nesl/ragobots/robot/hw/body/docs/IR_Power/Cliff_Rx/notes.txt

This is basically unmeasurable. The 620 shows 3.75mV which is less than 1 micro-amp (guess by extrapolation).
noise floor occurs for all currents below 17.2uA (see xls chart "620 CHARACTERIZATION)
