nesl/ragobots/robot/hw/body/docs/IR_Power/Obstacle_Low_Power_TX/notes.txt

Agilent E3631A reads: 1.201V, 3mA CC
I_peak = 368.8mV -> 16.6mA
I_avg = 165.2mV -> 7.2mA
