nesl/ragobots/publications/2004_10_Ragobot_EEARR2004.pdf

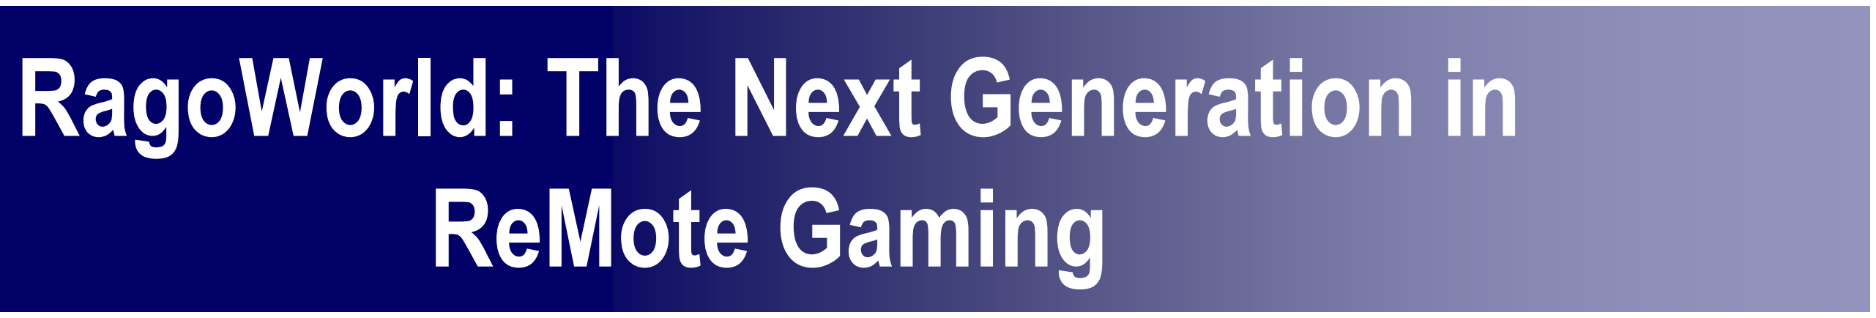
[picture p17: figure]
RagoWorld: The Next Generation in ReMote Gaming

Jonathan Friedman, David Lee, Advait Dixit, Parixit Aghera, Aman Kansal, Sophia Wong, William J. Kaiser, Greg J. Pottie, and Mani Srivastava http://nesl.ee.ucla.edu

### 2 EE ARR 2004

## Behind the Bot: A RagoStory

- Entertainment
- Provide new interactive gaming environment
- Visual interesting and new potential games
- Education
- Fun platform for students to learn about embedded robots
- Provide teaching aids for complex systems
- Research
- Provide reconfigurable mobile platform for embedded research
- New directions in adaptive actuation and coordinated operation
- Isolate test algorithms by shifting other functionality to central server

## RagoWorld: Robogaming Environment

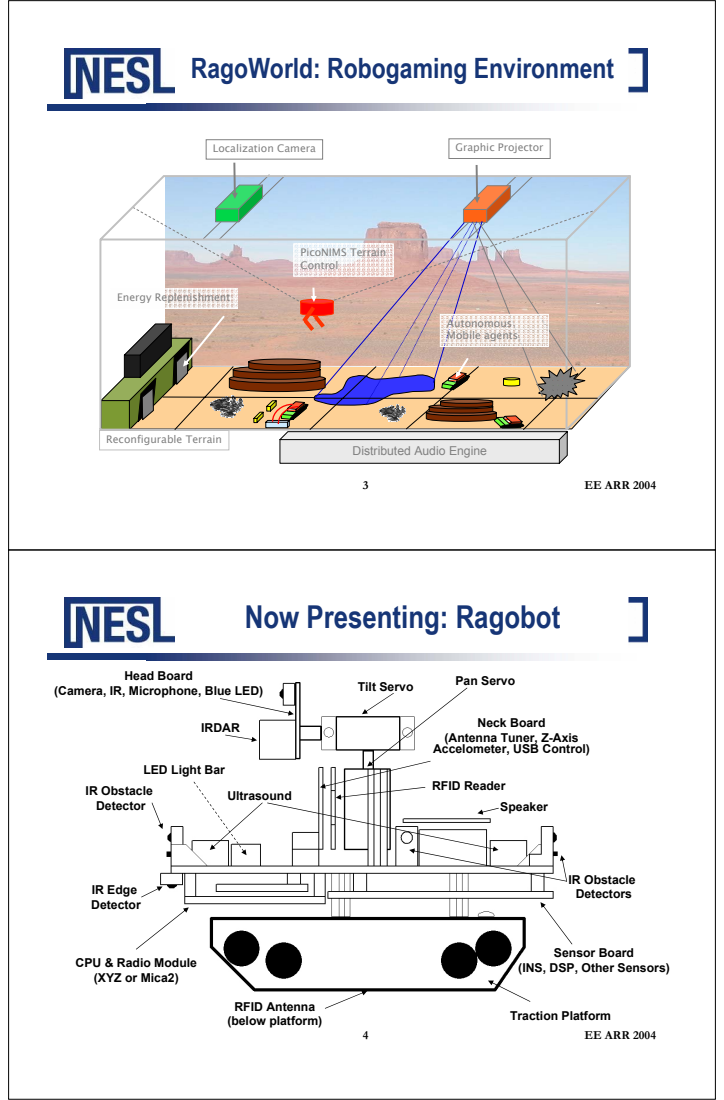
[picture p18: page 2]
3 EE ARR 2004; Graphic Projector; PicoNIMS Terrain Control; Energy Replenishment; Reconfigurable Terrain; Localization Camera; Autonomous Mobile agents; 4 EE ARR 2004; wIR Edge wDetector; IR Obstacle Detector; RFID Reader; Head Board; IRDAR; RFID Antenna (below platform); Speaker; Ultrasound; IR Obstacle Detectors; Traction Platform

Distributed Audio Engine

Now Presenting: Ragobot

Pan Servo Tilt Servo

(Camera, IR, Microphone, Blue LED)

Neck Board
(Antenna Tuner, Z-Axis
Accelometer, USB Control)

LED Light Bar

Sensor Board
(INS, DSP, Other Sensors)

wCPU & Radio Module
w(XYZ or Mica2)

## Ragobot Rev. 1, Say Cheese

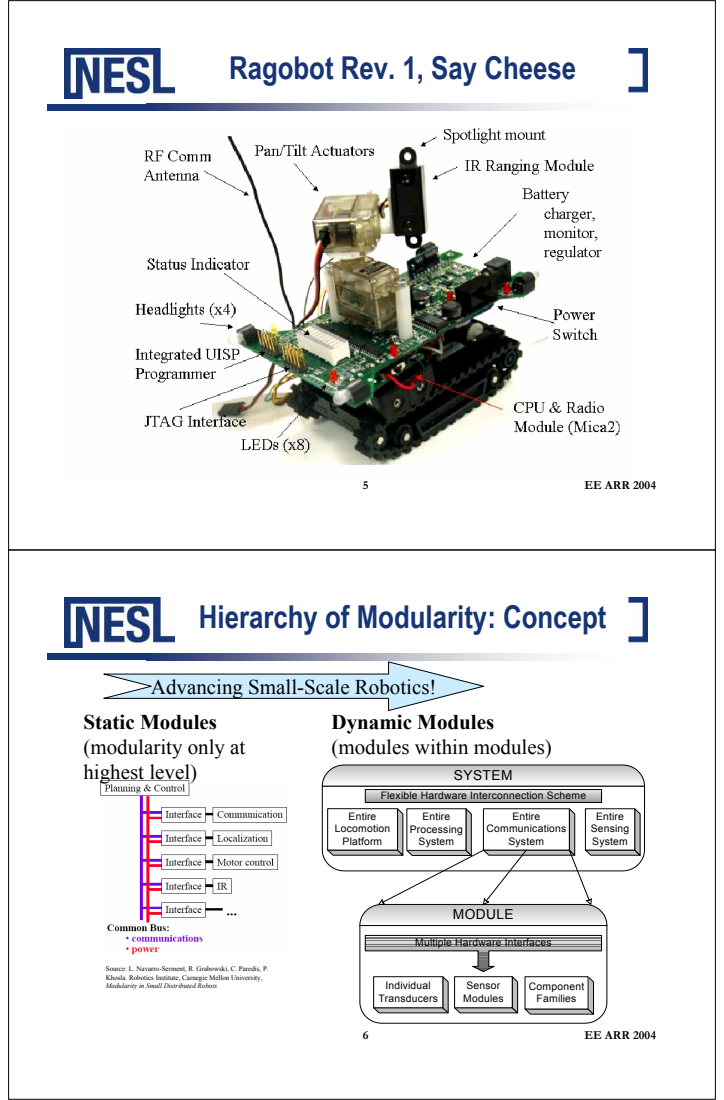
[picture p19: page 3]
5 EE ARR 2004; 6 EE ARR 2004; Entire Sensing System; Sensor Modules; Component Families; SYSTEM; MODULE; Individual Transducers; Entire Processing System; Entire Communications System

Hierarchy of Modularity: Concept

Advancing Small-Scale Robotics!
Static Modules
(modularity only at
highest level)

Dynamic Modules
(modules within modules)

Flexible Hardware Interconnection Scheme
Entire
Locomotion
Platform

Multiple Hardware Interfaces

Source: L. Navarro-Serment, R. Grabowski, C. Paredis, P.
Khosla. Robotics Institute, Carnegie Mellon University,
Modularity in Small Distributed Robots

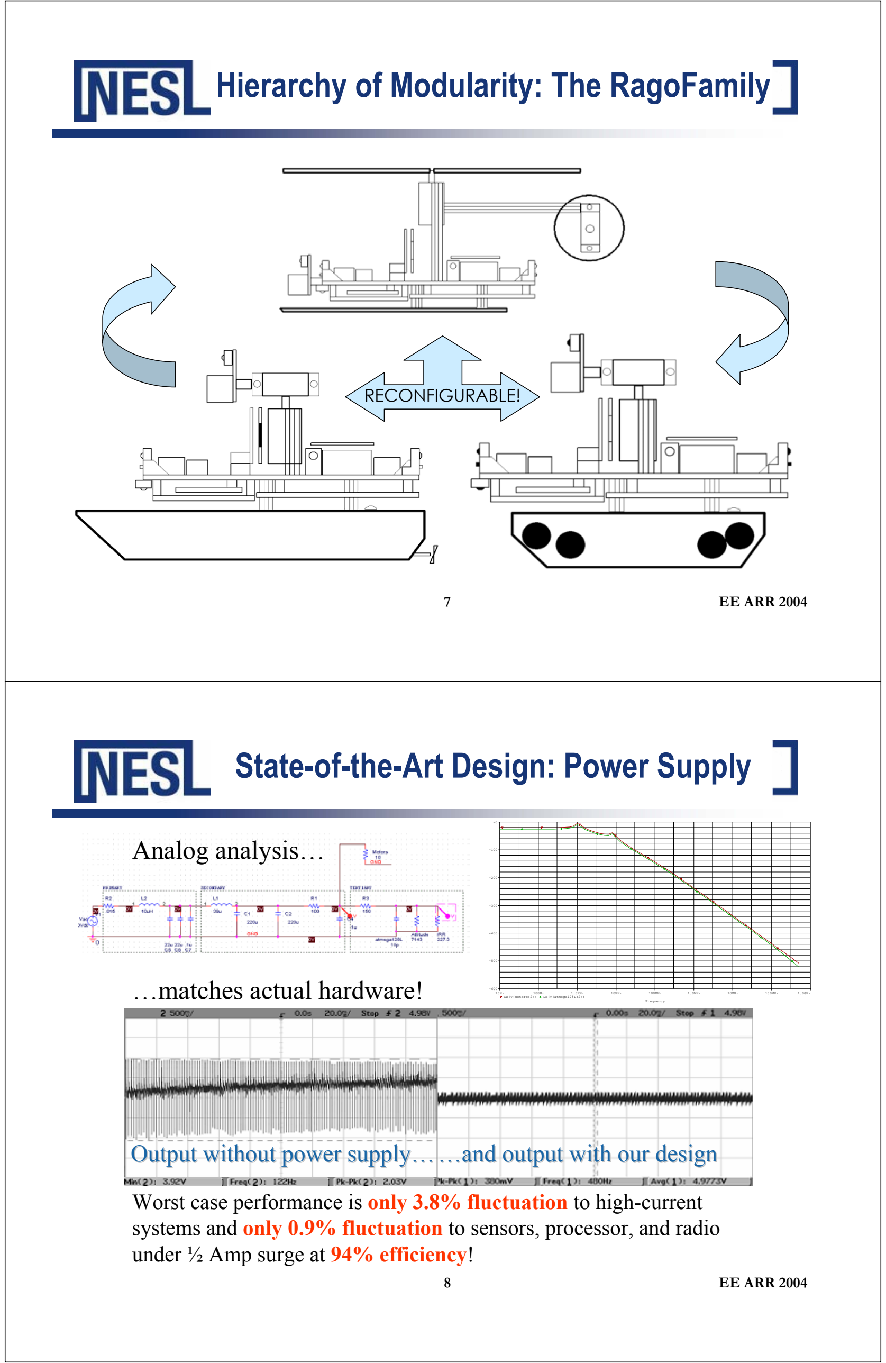
[picture p20: figure]
7 EE ARR 2004; Hierarchy of Modularity: The RagoFamily; RECONFIGURABLE!; 8 EE ARR 2004; State-of-the-Art Design: Power Supply; Frequency; 1.0KHz; 10KHz; 100KHz; 1.0MHz; 10MHz; 100MHz; 1.0GHz; DB(V(Motors:2)); DB(V(atmega128L:2)); under ½ Amp surge at 94% efficiency!; Analog analysis…; …matches actual hardware!

Worst case performance is only 3.8% fluctuation to high-current systems and only 0.9% fluctuation to sensors, processor, and radio

Output without power supply……and output with our design and output with our design

## Actuated Structures

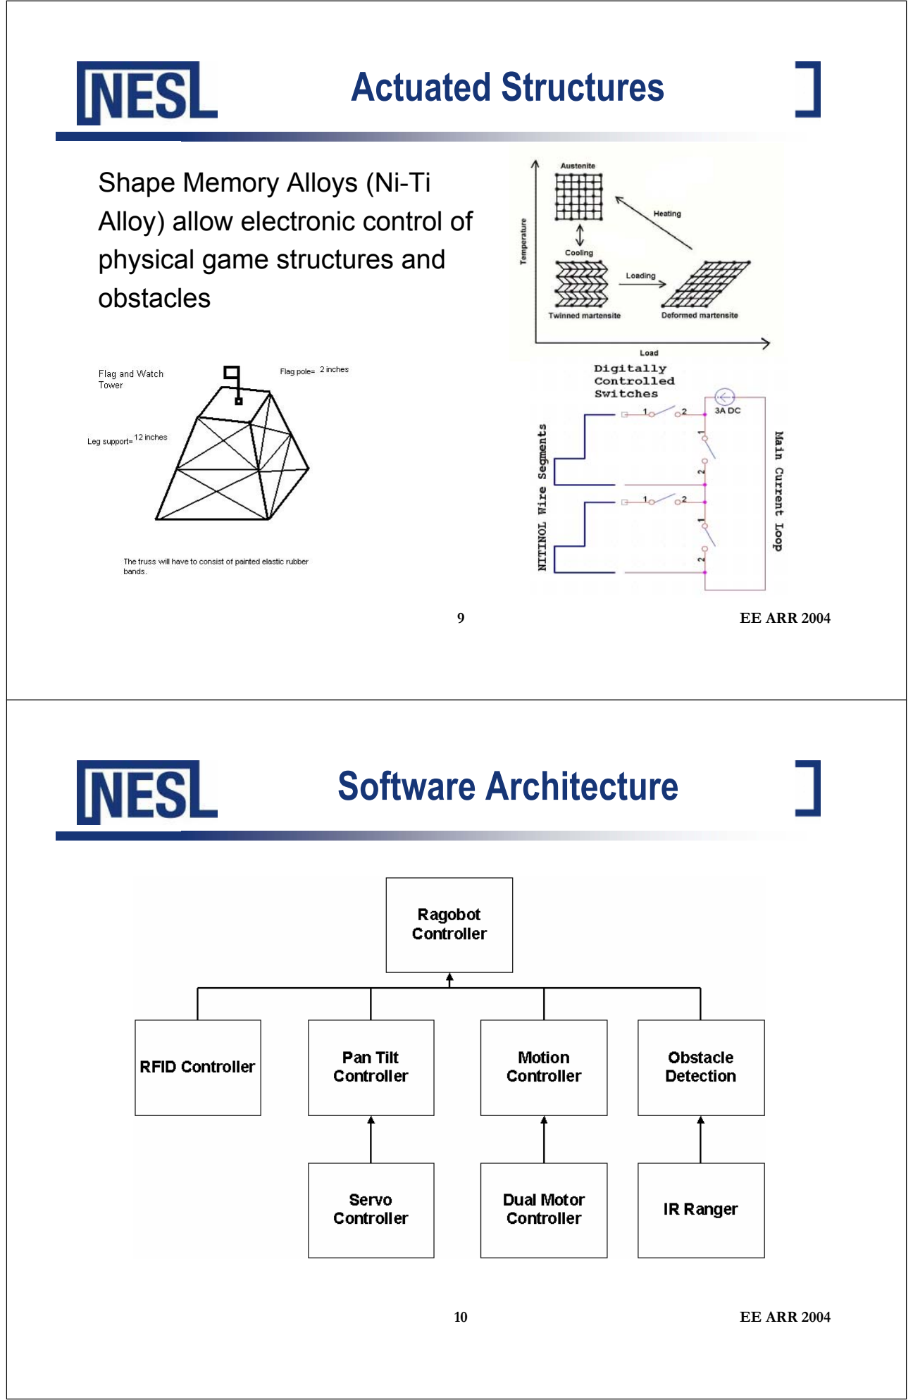
[picture p21: page 5]

### 9 EE ARR 2004

Shape Memory Alloys (Ni-Ti Alloy) allow electronic control of physical game structures and obstacles

### 10 EE ARR 2004

## Software Architecture

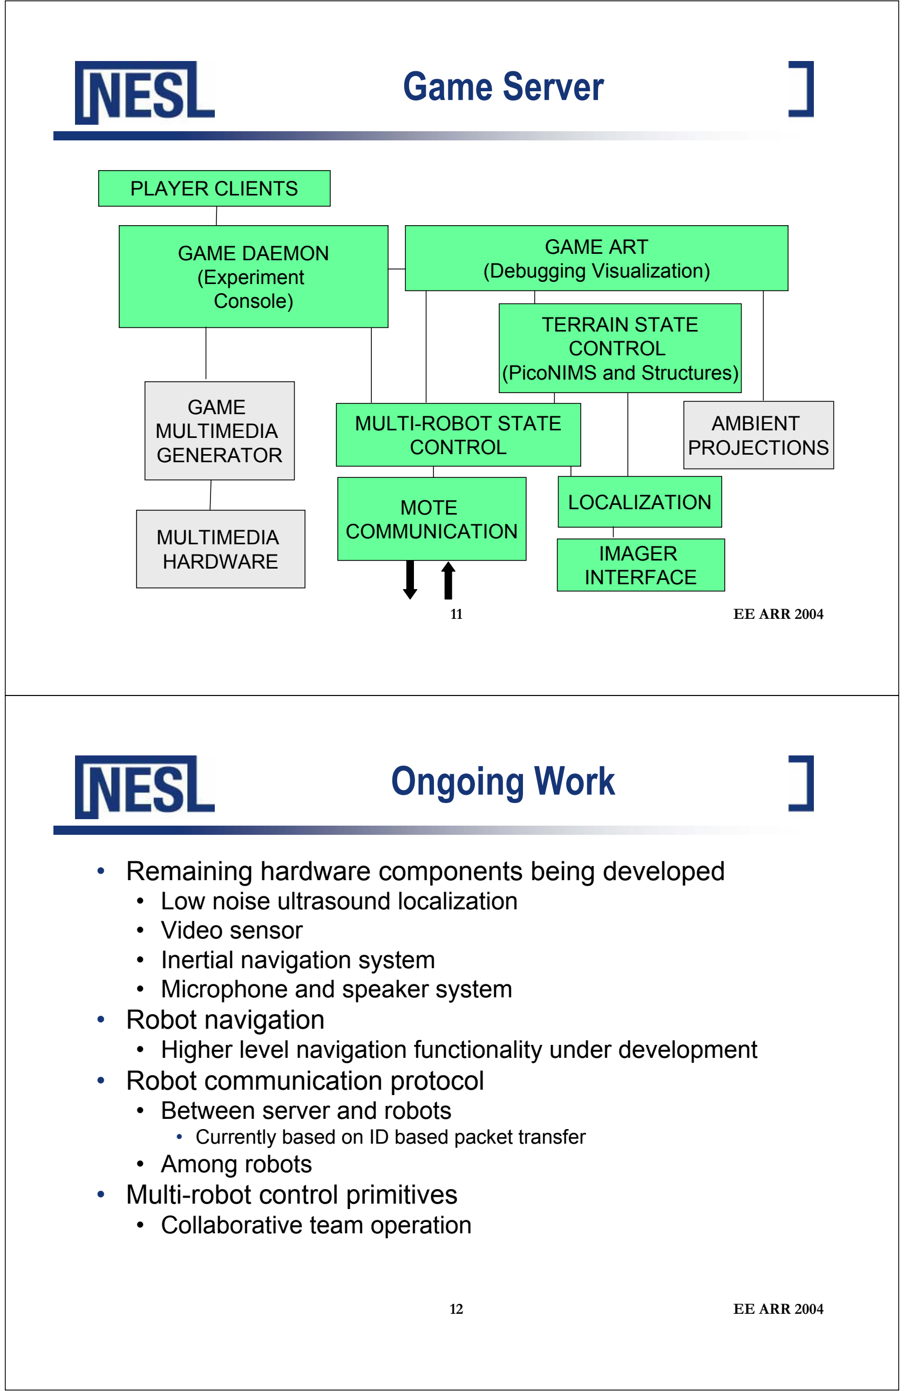
[picture p22: figure]
11 EE ARR 2004; Game Server; MOTE COMMUNICATION; MULTI-ROBOT STATE CONTROL; LOCALIZATION; GAME DAEMON (Experiment Console); PLAYER CLIENTS; TERRAIN STATE CONTROL (PicoNIMS and Structures); IMAGER INTERFACE; GAME MULTIMEDIA GENERATOR; MULTIMEDIA HARDWARE; GAME ART (Debugging Visualization); AMBIENT PROJECTIONS; 12 EE ARR 2004; Ongoing Work; • Low noise ultrasound localization • Video sensor • Inertial navigation system • Microphone and speaker system • Robot navigation; • Robot communication protocol • Between server and robots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

- Remaining hardware components being developed
- Higher level navigation functionality under development
- Currently based on ID based packet transfer
