nesl/ragobots/publications/2004_10_Ragobots_CENSARR2004.pdf

### Problem Description: Creation of a Test Platform for Mobile Sensor Network Research

### Proposed Solution: Ragobot and its Gaming Terrain

# Real Action Gaming Robots

Jonathan Friedman, David Lee, Parixit Aghera, Advait Dixit, Aman Kansal, Deborah Estrin, William J Kaiser, Mani B Srivastava, and Gaurav Sukhatme Networked and Embedded Systems Laboratory – http://nesl.ee.ucla.edu

### Introduction: Importance of Robogaming in Entertainment, Education, and Research

Entertainment and Education
- Provides new interactive gaming environment
– Creates opportunities for social interaction
- Promotes creativity
- Provides a flexible design platform
- Engages students to learn about robots and embedded mobile sensor networks
- Provides a teaching aid for complex systems

Mobile Sensor Network Research
- Provides reconfigurable mobile platform for embedded research
– Static sensor nodes may not be sufficient
– Mobility allows nodes to reconfigure into optimal sensing and communications topologies
- Allows adaptive actuation and coordinated operation

- Ragobot Hardware
– Hierarchy of modularity: robot divided into 5 PCBs:
- DSP sensor “Nerve” board,
- Processor “Brain” board,
- Motile sensor “Head” board,
- Vertical sensor mount “Neck” board, and
- Main interface “Body” board
– Large sensor array: 1) ultrasound, 2) RFID, 3) IR obstacle detection,
4) inertial navigation system , 5) microphone, and 6) camera –Custom power supply to reduce noise on mixed signal board
- Ragobot Software
–Game Server: 1) provides global services such as localization,
2) maintains state and provides robot control, 3) controls terrain configuration
- Platform independent GUI for player console ( Java )
- Components communicate using TCP/IP sockets (modularity)
–Robot Software (in TinyOS) 1) controls actuators and sensors,
2) communicates with game server and other Ragobots, 3) performs local tasks such as navigation, obstacle avoidance and treasure collection
- Different levels of abstractions to isolate hardware changes from upper layers
- Modular software design allows selection of different sets of functionalities
- Ragobot Terrain
–Electronically-controlled actuated structures using Ni-Ti shape memory alloys
–Modular terrain pieces with natural obstacles created from Insulfoam –Reconfigurable to create new terrain environments
–Global localization system using camera (CMVision) or ultrasound
- A fully capable, reconfigurable mobile platform to interface with sensor nodes
- Customizable sensor suite on mobile robots
- Simple programming interface for expert and non-expert users
- Real-time response to environmental stimuli
- Flexible, reconfigurable, interactive terrain

Game Server

Camera Localization

Multi-Robot State and
Control

Terrain Control
(PicoNIMS, Structures,
Projection and Audio)

Robot
Communication

Camera Interface

Player Console
Player Console

Robot Software

Navigation

Localization

Ragobot Controller

DualMotorController

ObstacleDetection

PanTiltController

ServoController

IRRanger

MotionController

«uses» | «uses»

«uses»

«uses» | «uses»

«uses»

«uses» | «uses»

«uses»

TreasureCollector

«uses»

GameServerComm

PlayerStrategy

RFIDController

HintCollector

Shaded Components have been developed/are being developed as part of this project.

ReliableComm

CPU & Radio Module
(XYZ or Mica2)

IR Edge
Detector

IR Obstacle
Detector

Sensor Board
(INS, DSP, Other Sensors)

RFID Reader

Head Board
(Camera, IR, Microphone, Blue LED)

IRDAR

RFID Antenna
(below platform)

Speaker

Ultrasound

LED Light Bar

IR Obstacle
Detectors

Neck Board
(Antenna Tuner, Z-Axis
Accelerometer, USB
Control)

Traction Platform

Pan Servo Tilt Servo
