nesl/ragobots/publications/org_chart.jpg

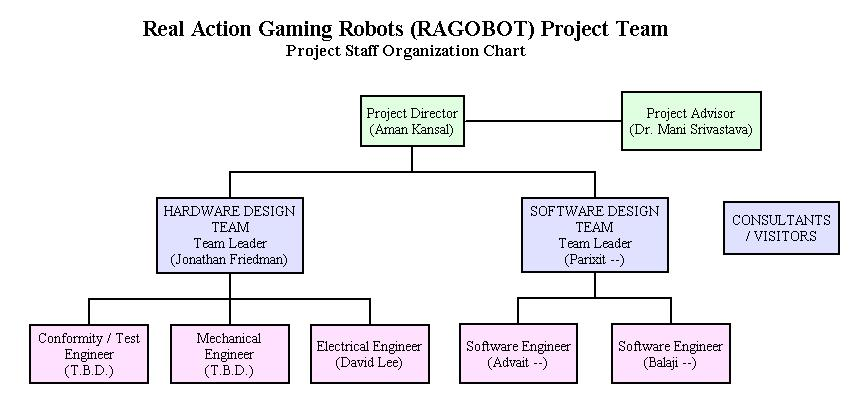
publications/org_chart.jpg
