nesl/ragobots/server/localization/capture.jpeg

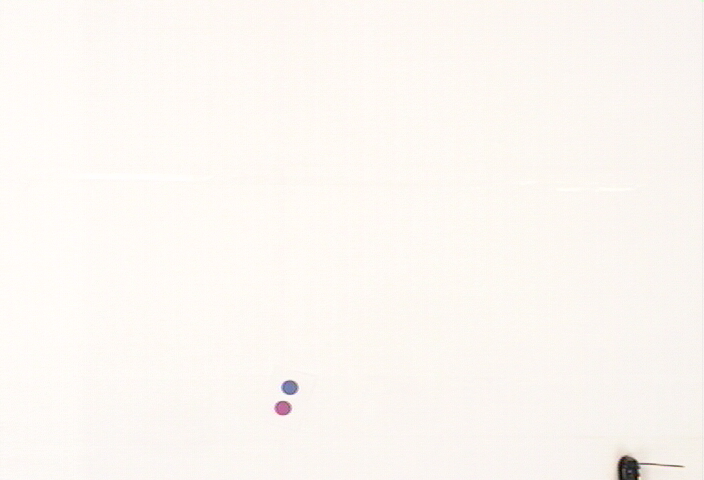
server/localization/capture.jpeg
