nesl/ragobots/server/localization/colors.bmp

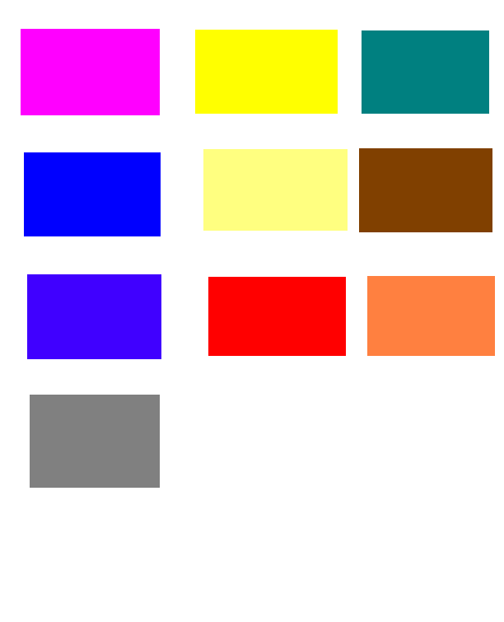
server/localization/colors.bmp
