nesl/ragobots/server/localization/colors_circles2.bmp

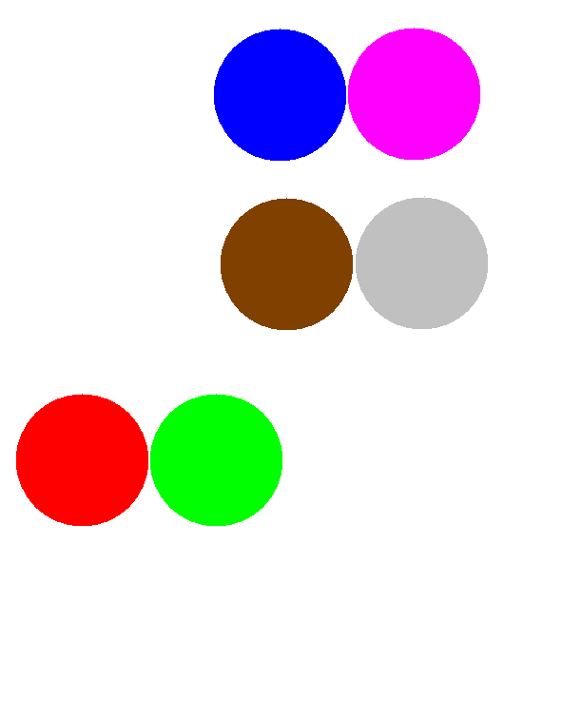
server/localization/colors_circles2.bmp
