nesl/ragobots/server/localization/colors_circles3.bmp

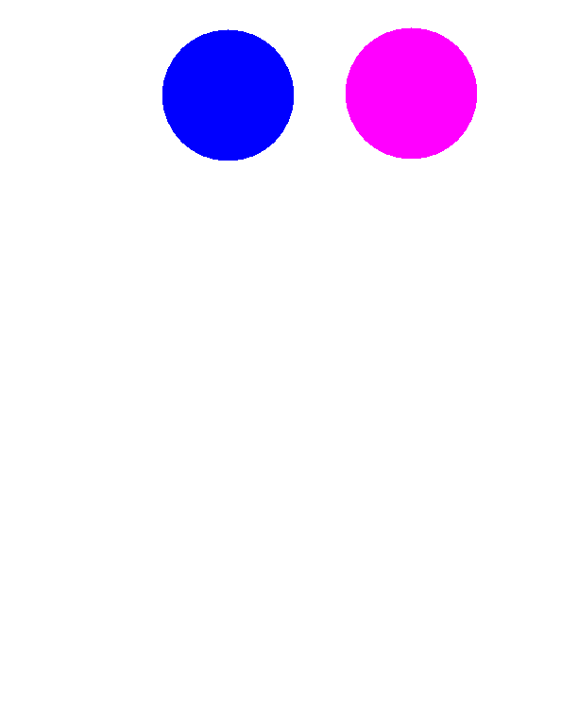
server/localization/colors_circles3.bmp
