nesl/ragobots/server/localization/colors_circles.bmp

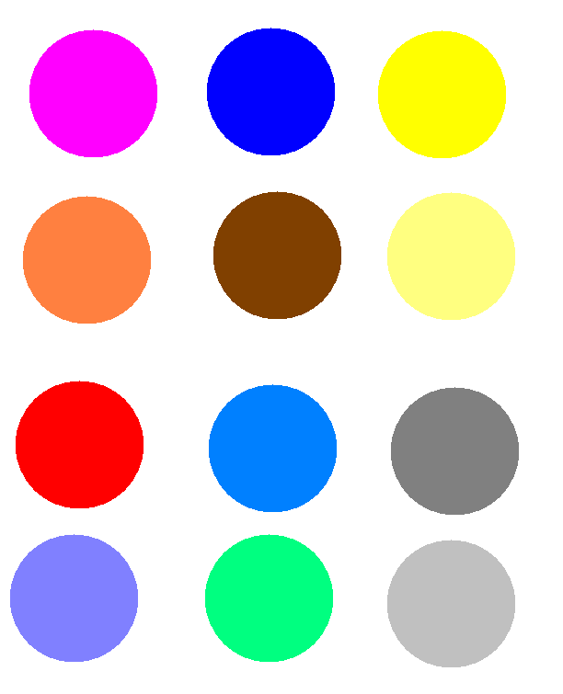
server/localization/colors_circles.bmp
