nesl/ragobots/server/localization/protractor2.gif

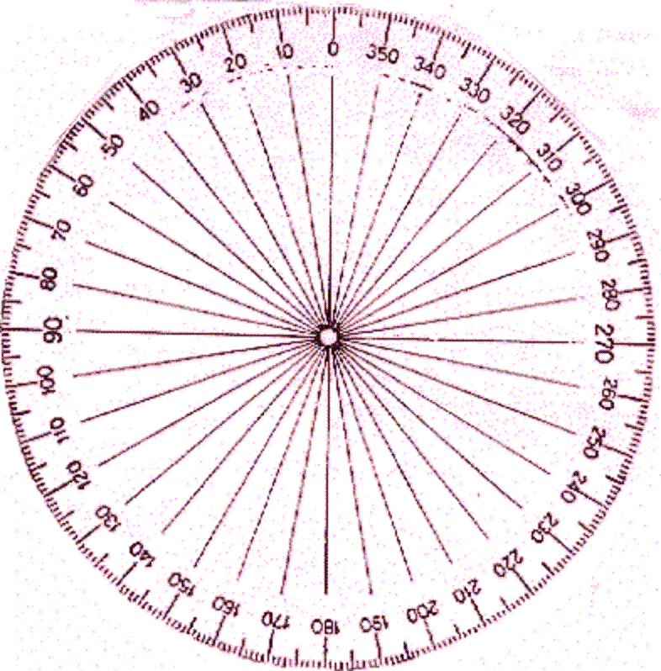
server/localization/protractor2.gif
