nesl/ragobots/server/localization/protractor.jpg

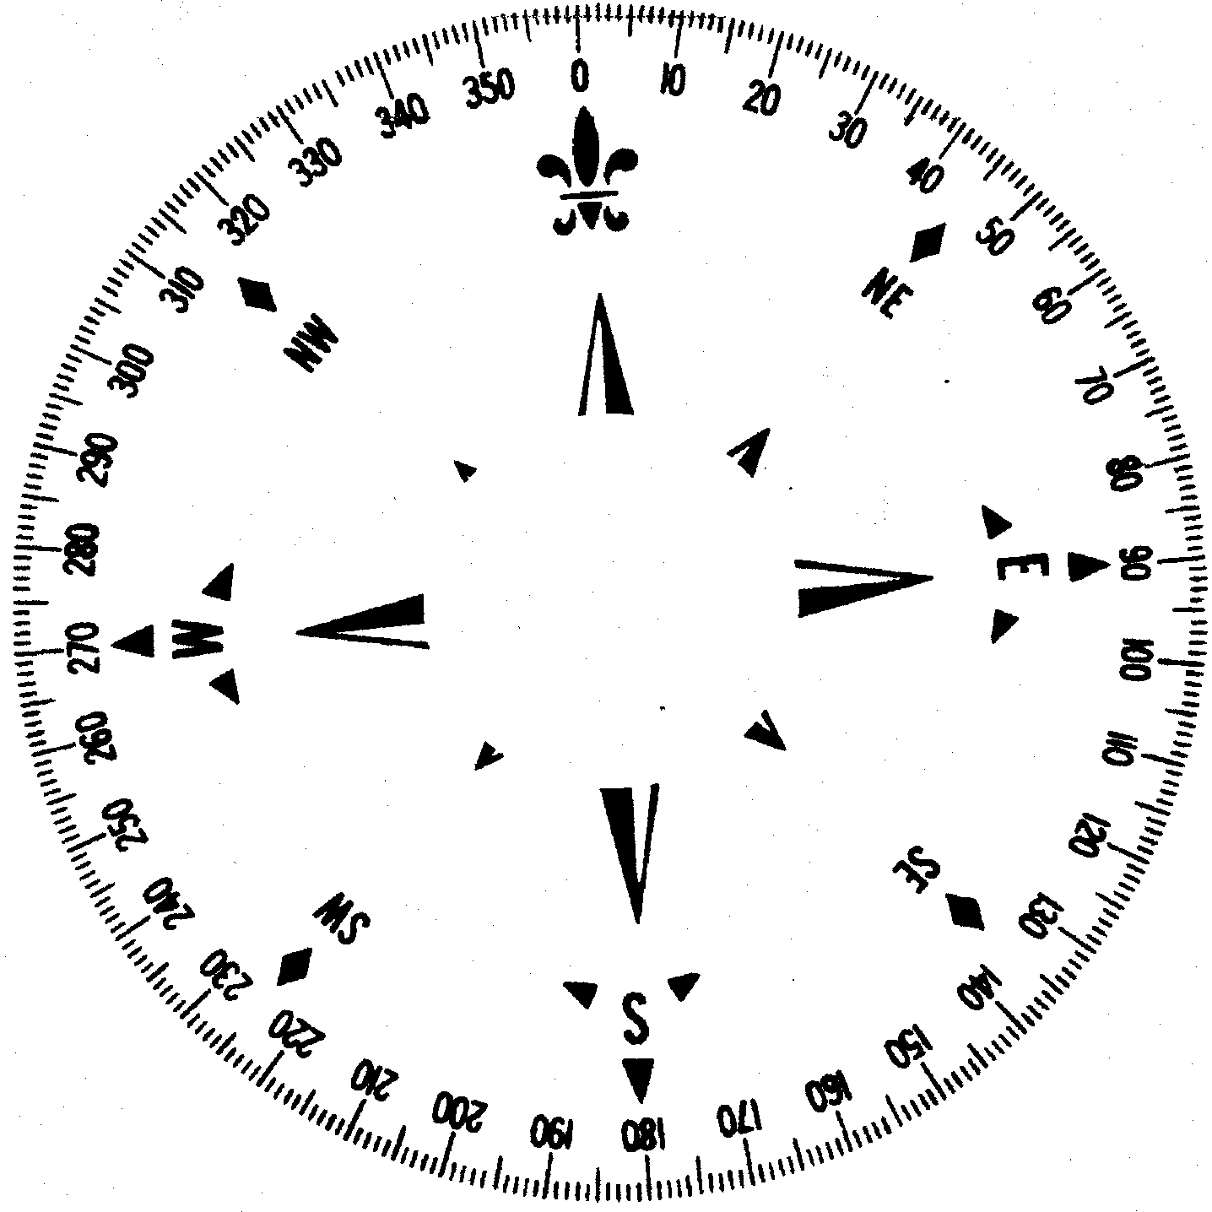
server/localization/protractor.jpg
