nesl/ragobots/robot/hw/body/docs/BOM_COST.xls

Item Number | Bin# | Distributor_Part_Number | Mfg_Part_Number | Description | Value | Quantity | Unit_Price
1 | C10.1 | ADXL203CE-ND | ADXL203CE | IC ACCELEROMETER DUAL-AXIS 8CLCC | ANALOG_DEVICES/ADXL203CE | 1 | 22.5 | $22.50 |  |  | $30.00 | <-Threshold for Expensive! Parts
2 | . | 77C7015 | MAX1138EEE | I2C 10 bit ADC with 12 channels | MAXIM/MAX1138 | 1 | 7.96 | $7.96 |  |  | $75.00 | <-Sum of Expensive! Parts
3 | . | AD623ARM-ND | AD623ARM | IC INSTR AMP R-R OUT 8-MSOP | ANALOG_DEVICES/AD623 | 4 | 3.49 | $13.96 |  |  | $207.37 | <-Total without Expensive! Parts
4 | G05.6 | MAX1908ETI | Max1908 | Low-Cost Multichemistry Battery Chargers | MAX1908 | 1 | 7.19 | $7.19
5 | . | 490-1582-1-ND | GRM188F51C105ZA01D | CAP CER 1.0UF 16V Y5V 0603 | 1.0uF | 4 | 0.075 | $0.30
6 | . | 445-1436-1-ND | C3225X5R1C226M | CAP CER 22UF 16V X5R 20% 1210 | 22uF | 5 | 1.386 | $6.93 |  |  |  |  | $194.39 | Cost without Sensors
7 | . | 311-1047-1-ND | 04022F104Z7B20D | CAP .10UF 16V CERAMIC Y5V 0402 | 0.1uF | 39 | 0.088 | $3.43
8 | G02.2 | 308-1269-1-ND | CDRH104R-100NC | INDUCTOR POWER 10UH 4.40A SMD | 10uH | 1 | 2.45 | $2.45
9 | . | P33.2LCT-ND | ERJ-2RKF33R2X | RES 33.2 OHM 1/16W 1% 0402 SMD | 33.2 | 1 | 0.098 | $0.10
10 | . | P133KLCT-ND | ERJ-2RKF1333X | RES 133K OHM 1/16W 1% 0402 SMD | 133K | 3 | 0.098 | $0.29
11 | . | P9.31KLCT-ND | ERJ-2RKF9311X | RES 9.31K OHM 1/16W 1% 0402 SMD | 9.31k | 1 | 0.098 | $0.10
12 | . | RHM1.00KLCT-ND | MCR01MZPF1001 | RES 1.00K OHM 1/16W 1% 0402 SMD | 1k | 4 | 0.082 | $0.33
13 | A10.4 | P33.2KLCT-ND | ERJ-2RKF3322X | RES 33.2K OHM 1/16W 1% 0402 SMD | 33k | 5 | 0.098 | $0.49
14 |  |  |  |  | 0 |  |  | $0.00
15 | . | P39NBCT-ND | ERJ-L12KF39MU | RESISTOR .039 OHM 1/2W 1% 1812 | 0.039 | 4 | 0.696 | $2.78
16 | G04.2 | P15MCT-ND | ERJ-M1WSF15MU | RESISTOR .015 OHM 1W 1% 2512 | 0.015 | 3 | 0.816 | $2.45
17 | C15.4 | DS2438Z-ND | DS2438Z | IC MONITOR SMART BATTERY 8-SOIC | DS2438 | 1 | 3.87 | $3.87
18 | . | RHM5.10KLCT-ND | MCR01MZPF5101 | RES 5.10K OHM 1/16W 1% 0402 SMD | 5.1K | 2 | 0.082 | $0.16
19 | L08.0 | H2163-ND | DF9-51S-1V(54) | CONN RECEPT 51POS 1MM SMD GOLD | Mica2 Sensor HDR (to Mote) | 1 | 3.12 | $3.12
20 | . | P5506-ND | ECA-0JHG221 | CAP 220UF 6.3V ELECT NHG RADIAL | 220uF | 1 | 0.19 | $0.19
21 | . | 490-1586-1-ND | GRM188F51A225ZE01D | CAP CER 2.2UF 10V Y5V 0603 | 2.2uF | 1 | 0.168 | $0.17
22 | . | 493-2182-1-ND | UWT1C681MNL1GS | CAP 680UF 16V ELECT WT SMD | 680u | 1 | 0.548 | $0.55
23 | B01.1 | 311-1014-1-ND | 0402CG100J9B200 | CAP CERAMIC 10PF 50V NP0 0402 | 10pF | 1 | 0.077 | $0.08
24 | B06.3 | PCC1909CT-ND | ECJ-1VB0J334K | CAP .33UF 6.3V CERAMIC X5R 0603 | 0.33uF | 1 | 0.134 | $0.13
25 | . | 478-1248-1-ND | 0603YD474KAT2A | CAP CERM .47UF 10% 16V X5R 0603 | 0.47uF | 3 | 0.495 | $1.48
26 | E02.5 | 160-1167-1-ND | LTST-C150CKT | LED RED CLEAR 1206 SMD | LED | 6 | 0.11 | $0.66
27 | . | L20488-ND | 5305H1/5 | LED RED/GRN T1-3/4 BI-CLR PCB | 5305H1/5 Tricolor LED | 4 | 1.94 | $7.76
28 | . | B220ADICT-ND | B220A-13 | DIODE SCHOTTKY 20V 2A SMA | 2A,20V | 12 | 0.76 | $9.12
29 | . | LN54PA-ND | LN54 | IR LED 950NM 17 DEG SIDE VIEW | 950nm | 6 | 1 | $6.00
30 | . | 02J4593 | MAX6816 | Single CMOS Switch Debouncer | MAXIM/MAX6816 | 1 | 2.18 | $2.18
31 | . | 38C7158 | FDS4435A | Discrete Semi's, MOSFET, P Channel, -30 V Voltage Rating, SO-8 Package | FAIRCHILD/FDS4435A | 1 | 1.15 | $1.15
32 | . | 497-1396-5-ND | L298P | IC DUAL FULL DRIVER 20POWERRSOIC | ST/L298/P20 | 1 | 4.86 | $4.86
33 | . | IRF7509CT-ND | IRF7509TR | HEX/MOS N/PCH DL 30V/-30V MICRO8 | IR/IRF7509 | 1 | 1.89 | $1.89
34 | . | WM4802-ND | 70543-0003 | CONN HEADER 4POS .100 VERT GOLD | 4 | 1 | 0.96 | $0.96
35 | . | PI74STX1G04CXCT-ND | PI74STX1G04CX | IC SINGLE INVERTER SC70-5 | PERICOM/PI74STX1G04CX/SC70 | 2 | 0.38 | $0.76
36 | E14.4 | 425-1131-ND | GP1UD28YK | RECEIVER REMOTE CTRL SIDE 40KHZ | SHARP/GP1UD26XK | 6 | 1.33 | $7.98
37 | . | HFJ50CT-ND | FH12-50S-0.5SH | CONN FPC/FFC 50POS .5MM HORZ SMD | 50 PIN | 2 | 3.54 | $7.08
38 | . | H1755-ND | DF15A(6.2)-50DP-0.65V(50) | CONN HEADER 50POS 6.2MM DUAL SMD | HEADER 50 | 1 | 2.73 | $2.73
39 | . | A26565-ND | 87227-1 | CONN HEADER VERT .100 2POS 15AU | CONN SOCKET 2 | 4 | 0.87 | $3.48
40 | D12.3 | CP-016-ND | PJ-016 | CONN PWR JACK 4.4MM X 1.65MM PCB | CONN_JACK_PWR | 1 | 0.54 | $0.54
41 | G07.3 | 445-1553-1-ND | MMZ1608Y152B | FERRITE CHIP 1500 OHM 300MA 0603 | 1.5K | 7 | 0.092 | $0.64
42 | . | 308-1050-1-ND | CDRH125-220MC | POWER INDUCTOR 22UH 2.8A SMD | 22uH | 1 | 2.13 | $2.13
43 | L04.0 | 512-MV5E164 | MV5E164 | LED BARGRAPH 10-SEG GRN/YLW/RED | LUMEX SSA-LXB10SRW-GF/LP | 1 | 0.86 | $0.86
44 | . | P11123-ND | WM-R30B | SPEAKER FLAT 30MM X 30MM | Note: Place both footprints! (one is mech, one is electrical) | 1 | 6.32 | $6.32
45 | . | 02J4502 | MAX3370EXK-T | 1uA, 2Mbps, Low-Voltage Level Translator in SC70 Package | MAXIM/MAX3370 | 4 | 2.04 | $8.16
46 | . | 342-1006-ND | HMC1023 | SENSOR LINEAR MAGN 3 AXIS 16-BGA | HONEYWELL/HMC1023 | 1 | 75 | $75.00 | EXPENSIVE! | $75.00
47 | G01.1 | BTR-7006 | BTR-7006 | 90 Degree Universal Servo Mount | SERVOCITY/90_DEG_SERVO_MOUNTS | 4 | 1.95 | $7.80
48 | . | A23858-ND | 644861-6 | CONN HEADER VERT .100 6POS TIN | 6x1 | 1 | 1.02 | $1.02
49 | . | A26267-ND | 103308-1 | CONN HEADER LOPRO STR 10POS 15AU | 5x2; .100" | 2 | 0.44 | $0.88
50 | . | 82C2573 | FDS6898A | SO-8 DUAL N-CH 20V PowerTrench MOSFETs | Dual N-CH | 5 | 1.32 | $6.60
51 | . | P150LCT-ND | ERJ-2RKF1500X | RES 150 OHM 1/16W 1% 0402 SMD | 150 | 6 | 0.098 | $0.59
52 | . | P47.5LCT-ND | ERJ-2RKF47R5X | RES 47.5 OHM 1/16W 1% 0402 SMD | 47.5 | 7 | 0.098 | $0.69
53 | . | RHM4.70LCT-ND | MCR01MZPFL4R70 | RES 4.70 OHM 1/16W 1% 0402 SMD | 4.7 | 2 | 0.082 | $0.16
54 | . | P17.4LCT-ND | ERJ-2RKF17R4X | RES 17.4 OHM 1/16W 1% 0402 SMD | 17.4 | 1 | 0.098 | $0.10
55 | . | P191LCT-ND | ERJ-2RKF1910X | RES 191 OHM 1/16W 1% 0402 SMD | 191 | 1 | 0.098 | $0.10
56 | G08.5. | Y1470CT-ND | EXB-2HV470JV | RES ARRAY 47 OHM 5% 8 RES SMD | 47 | 1 | 0.18 | $0.18
57 | . | P8002SCT-ND | EVQ-PHP03T | LIGHT TOUCH SWITCH W/ACT SLD SMD | SPST-M-NO | 1 | 0.86 | $0.86
58 | . | EG2486-ND | EG2211A | SWITCH SLIDE DPDT RT ANG PC MNT | slide switch | 1 | 0.82 | $0.82
59 | . | H2249-ND | FX2-40S-1.27SV | CONN RECEPT 40POS 1.27MM STR SMD | HIROSE/FX2-40S-1.27SV | 1 | 4.84 | $4.84
60 | . | NC7S32M5CT-ND | NC7S32M5 | IC GATE OR 2-INPUT SINGLE SOT-23 | FAIRCHILD/NC7S32M5X/SOT23_5 | 2 | 1.02 | $2.04
61 | . | MC74HC595ADTROSCT-ND | MC74HC595ADTR2 | IC REG SHFT 8BIT LCH 3ST 16TSSOP | ON/MC74HC595A/TSSOP16/B | 6 | 0.49 | $2.94
62 | . | TC74VHC165FN-ND | TC74VHC165FN | IC REG SHIFT PISO 8BIT 16-SOL | TOSHIBA/TC74VHC165 | 1 | 0.58 | $0.58
63 | G01.5 | ATMEGA48V-10MI-ND | ATMEGA48V-10MI | IC MCU AVR 4K 5V 12MHZ 32-MLF | ATMEL/ATMEGA48/88/168/MLF32 | 1 | 2.69 | $2.69
64 | . | MAX395CAG | MAX395CAG | Serially Controlled, Low-Voltage, 8-Channel SPST Switch, WSOIC24 (.300 inch) | MAX395CAG | 1 | 5.62 | $5.62
65 | . | WM1752-ND | 53048-1210 | CONN HEADER 12POS 1.25MM R/A TIN | PLANTRACO/Desktop_Rover | 1 | 1.62 | $1.62
66 |  |  |  |  | HEADER 8 |  |  | $0.00
67 |  |  |  |  | HEADER 8 |  |  | $0.00
68 | . | 490-1814-1-ND | GRM31CR61C106KC31L | CAP CER 10UF 16V 10% X5R 1206 | 10uF | 1 | 0.792 | $0.79
69 | . | PCD1667CT-ND | ELL-4LM100M | COIL PWR CHOKE 10UH 690MA SMD | 10uH | 1 | 1.4 | $1.40
70 | . | MAX1626ESA-ND | MAX1626ESA | IC DC/DCCONV STP-UP 3.3/5V 8SOIC | MAXIM/MAX1626 | 1 | 4.61 | $4.61
71 | . | 296-14212-5-ND | TPS62056DGS | IC STEP-DOWN CONV HI-EFF 10-MSOP | TI/TPS620XX | 1 | 4.16 | $4.16
 |  |  |  |  |  |  |  | $0.00
 |  |  |  |  |  |  |  | $0.00
 |  |  |  |  |  | 202 | Parts | $282.37 | Total BOM Cost
 |  |  |  |  |  |  |  |  | (no servos)
 |  | Update |  | Description/Results |  | BOM |  | Costs Saved
2004-12-05 |  | 11:37p |  | Removed Gyroscope |  | 84->80 |  | $49.00
2004-12-06 |  | 1:15a |  | BOM cleanup |  | 73 |  | $9.10
