nesl/ragobots/robot/hw/body/design/REV.B2/Ragobot BOM.xls

Item Number | Part Reference | Distributor_Part_Number | Quantity | Mfr_Part_Number | PCB Footprint | Description
1 | AC1 | MAX942CSA-ND | 1 | MAX942CSA | SOG.050/8/WG.244/L.200 | IC COMPARATOR DUAL 3V/5V 8-SOIC
2 | ACCEL1 | ADXL203CE-ND | 1 | ADXL203CE | ANALOG_DEVICES/ADXL203CE | IC ACCELEROMETER DUAL-AXIS 8CLCC
3 | ADC1 | 77C7015 | 1 | MAX1138EEE | MAXIM/QSOP/16 | I2C 10 bit ADC with 12 channels
4 | AMP2 AMP3 AMP4 | AD623ARM-ND | 3 | AD623ARM | ANALOG_DEVICES/AD623/MSOP | IC INSTR AMP R-R OUT 8-MSOP
5 | BC1 | MAX1908ETI | 1 | Max1908 | MAXIM/QFN/28/5X5X0.8 | Low-Cost Multichemistry Battery Chargers
6 | BC_C1 BC_C2 BC_C3 BC_C7 C22 C42 | 490-1582-1-ND | 6 | GRM188F51C105ZA01D | SM/C_0603 | CAP CER 1.0UF 16V Y5V 0603
7 | BC_C4 CB4 CB5 VR_CIN1 VR_CO1 | 445-1436-1-ND | 5 | C3225X5R1C226M | SM/C_1210 | CAP CER 22UF 16V X5R 20% 1210
8 | BC_C8 BC_C9 CD1 CD2 | PCC103BQCT-ND | 4 | ECJ-0EB1C103K | SM/C_0402 | CAP 10000PF 16V CERAMIC 0402 SMD
9 | BC_L1 | 308-1269-1-ND | 1 | CDRH104R-100NC | SUMIDA_CDRH104R | INDUCTOR POWER 10UH 4.40A SMD
10 | BC_R1 | P33.2LCT-ND | 1 | ERJ-2RKF33R2X | SM/R_0402 | RES 33.2 OHM 1/16W 1% 0402 SMD
11 | BC_R2 BC_R6 BM_RFILT1 | P133KLCT-ND | 3 | ERJ-2RKF1333X | SM/R_0402 | RES 133K OHM 1/16W 1% 0402 SMD
12 | BC_R3 BC_R7 | P9.31KLCT-ND | 2 | ERJ-2RKF9311X | SM/R_0402 | RES 9.31K OHM 1/16W 1% 0402 SMD
13 | BC_R4 R13 R21 R22 | P33.2KLCT-ND | 4 | ERJ-2RKF3322X | SM/C_0402 | RES 33.2K OHM 1/16W 1% 0402 SMD
14 | BC_R5 RGAIN2 RGAIN3 RGAIN4 | RHM1.00KLCT-ND | 4 | MCR01MZPF1001 | SM/C_0402 | RES 1.00K OHM 1/16W 1% 0402 SMD
15 | BC_R8 BM_R1 R43 R44 | RHM5.10KLCT-ND | 4 | MCR01MZPF5101 | SM/R_0402 | RES 5.10K OHM 1/16W 1% 0402 SMD
16 | BC_RS2 | P15MCT-ND | 1 | ERJ-M1WSF15MU | SM/R_2512 | RESISTOR .015 OHM 1W 1% 2512
17 | BM1 | DS2438Z-ND | 1 | DS2438Z | SOG.050/8/WG.244/L.200 | IC MONITOR SMART BATTERY 8-SOIC
18 | BM_RSENS1 VR_RSEN1 VR_RSEN2 | P39NBCT-ND | 3 | ERJ-L12KF39MU | SM/C_1812 | RESISTOR .039 OHM 1/2W 1% 1812
19 | BRAIN1 | H2163-ND | 1 | DF9-51S-1V(54) | XBOW/MICAX | CONN RECEPT 51POS 1MM SMD GOLD
20 | C1 C2 C3 C4 C5 C6 C7 C8 C9 C11 C15 C16 C17 C18 C23 C24 C25 C27 C28 C29 C32 C33 C34 C35 C36 C43 C44 CB1 CB6 CB7 CB8 CB9 CB10 CB11 VR_C1 VR_C2 | 311-1047-1-ND | 36 | 04022F104Z7B20D | SM/C_0402 | CAP .10UF 16V CERAMIC Y5V 0402
21 | C13 | 493-2182-1-ND | 1 | UWT1C681MNL1GS | NICHICON/NL10/2 | CAP 680UF 16V ELECT WT SMD
22 | C21 | P5506-ND | 1 | ECA-0JHG221 | TM/6.3MM_RADIAL_CAP/2 | CAP 220UF 6.3V ELECT NHG RADIAL
23 | C26 | PCC1909CT-ND | 1 | ECJ-1VB0J334K | SM/C_0603 | CAP .33UF 6.3V CERAMIC X5R 0603
24 | C30 C31 VR_CS1 | 478-1248-1-ND | 3 | 0603YD474KAT2A | SM/C_0603 | CAP CERM .47UF 10% 16V X5R 0603
25 | D1 D2 D3 D4 D5 D6 | 160-1167-1-ND | 6 | LTST-C150CKT | SM/D_1206_21 | LED RED CLEAR 1206 SMD
26 | D7 D8 D9 D10 | L20488-ND | 4 | 5305H1/5 | 5305H1/5 | LED RED/GRN T1-3/4 BI-CLR PCB
27 | D11 D18 D19 D20 D21 D22 D23 D24 D25 D26 D27 D28 D29 D30 D42 D43 | CRS06CT-ND | 16 | CRS06(TE85L) | SM/DO213AC_21/A | RECT SCHOTTKY 20V 1A 3-2A1A
28 | D12 D13 D14 D15 D16 D17 | LN54PA-ND | 6 | LN54 | PANASONIC/LN54 | IR LED 950NM 17 DEG SIDE VIEW
29 | DAC1 | 90C4136 | 1 | MAX550ACUA | MAXIM/UMAX/8 | +2.5V to +5.5V, Low-Power, Single, 8-Bit Voltage-Output DACs in µMAX Package
30 | DBNCE1 | 02J4593 | 1 | MAX6816 | SM/SOT143_1234 | Single CMOS Switch Debouncer
31 | FET1 | 512-FDS4935A | 1 | FDS4935A | SOG.050/8/WG.275/L.250 | Fairchild MOSFETs, SOIC-8 -30V, Dual P-channel
32 | H1 | 497-1396-5-ND | 1 | L298P | ST/POWERSO/20/B | IC DUAL FULL DRIVER 20POWERRSOIC
33 | HXFT1 | IRF7509CT-ND | 1 | IRF7509TR | IR/MICRO8 | HEX/MOS N/PCH DL 30V/-30V MICRO8
34 | IB1 |  | 1 |  | BLKCON.100/VH/TM1SQ/W.100/4
35 | INV1 INV2 | PI74STX1G04CXCT-ND | 2 | PI74STX1G04CX | TI/SC70/5 | IC SINGLE INVERTER SC70-5
36 | IR1 IR2 IR3 IR4 IR5 IR6 | 425-1131-ND | 6 | GP1UD28YK | SHARP/GP1UD28YK/5 | RECEIVER REMOTE CTRL SIDE 40KHZ
37 | J3 | HFJ33CT-ND | 1 | FH12-33S-0.5SH | HIROSE/FH12-33S-0.5SH/33/A | CONN FPC/FFC 33POS .5MM HORZ SMD
38 | J5 | CP-016-ND | 1 | PJ-016 | CUI/PJ-016 | CONN PWR JACK 4.4MM X 1.65MM PCB
39 | J15 | H2371CT-ND | 1 | DF17(3.0)-60DS-0.5V(51) | HIROSE/DF17/60/A | CONN RECEPT 60POS .5MM SMD W/FIT
40 | J16 | HFL33CT-ND | 1 | FH12-33S-0.5SV | HIROSE/FH12-33S-0.5SV/33/A | CONN FPC/FFC 33POS .5MM VERT SMD
41 | L1 L2 L3 L6 L7 L8 L9 L10 L11 | 445-1553-1-ND | 9 | MMZ1608Y152B | SM/C_0603 | FERRITE CHIP 1500 OHM 300MA 0603
42 | L5 | 308-1050-1-ND | 1 | CDRH125-220MC | SUMIDA/CDRH125 | POWER INDUCTOR 22UH 2.8A SMD
43 | LED BAR GRAPH 1 | 512-MV5E164 | 1 | MV5E164 | DIP.100/20/W.300/L1.000 | LED BARGRAPH 10-SEG GRN/YLW/RED
44 | LS1 | P11123-ND | 1 | WM-R30B | BLKCON.100/VH/TM2OE/W.200/2 | SPEAKER FLAT 30MM X 30MM
45 | LV1 LV2 LV3 LV4 | 02J4502 | 4 | MAX3370EXK-T | TI/SC70/5 | 1uA, 2Mbps, Low-Voltage Level Translator in SC70 Package
46 | MAG1 | 342-1006-ND | 1 | HMC1023 | HONEYWELL/HMC1023 | SENSOR LINEAR MAGN 3 AXIS 16-BGA
47 | MECH1 MECH2 MECH3 MECH4 | BTR-7006 | 4 | BTR-7006 | SERVOCITY/BTR-7006 | 90 Degree Universal Servo Mount
48 | PAN/TILT1 | A23858-ND | 1 | 644861-6 | TYCO/644861-6 | CONN HEADER VERT .100 6POS TIN
49 | PROG1 PROG2 | A26285-ND | 2 | 103310-1 | AMP/103310-1/10 | CONN HEADER LOPRO R/A 10POS 15AU
50 | Q1 Q2 Q3 Q4 Q5 | 82C2573 | 5 | FDS6898A | SOG.050/8/WG.275/L.250 | SO-8 DUAL N-CH 20V PowerTrench MOSFETs
51 | R1 R2 R3 R4 R5 R6 | P150LCT-ND | 6 | ERJ-2RKF1500X | SM/R_0402 | RES 150 OHM 1/16W 1% 0402 SMD
52 | R7 R8 R9 R10 R11 R12 | P47.5LCT-ND | 6 | ERJ-2RKF47R5X | SM/C_0402 | RES 47.5 OHM 1/16W 1% 0402 SMD
53 | R14 R15 | RHM4.70LCT-ND | 2 | MCR01MZPFL4R70 | SM/C_0402 | RES 4.70 OHM 1/16W 1% 0402 SMD
54 | R16 | P17.4LCT-ND | 1 | ERJ-2RKF17R4X | SM/R_0402 | RES 17.4 OHM 1/16W 1% 0402 SMD
55 | R17 R20 | P1.0MJCT-ND | 2 | ERJ-2GEJ105X | SM/C_0402 | RES 1.0M OHM 1/16W 5% 0402 SMD
56 | R19 R26 | P191LCT-ND | 2 | ERJ-2RKF1910X | SM/C_0402 | RES 191 OHM 1/16W 1% 0402 SMD
57 | R25 | P27.4LCT-ND | 1 | ERJ-2RKF27R4X | SM/R_0402 | RES 27.4 OHM 1/16W 1% 0402 SMD
58 | RN1 | Y1470CT-ND | 1 | EXB-2HV470JV | SM/0402X8 | RES ARRAY 47 OHM 5% 8 RES SMD
59 | SW1 | P8002SCT-ND | 1 | EVQ-PHP03T | PANASONIC/EVQPH/4 | LIGHT TOUCH SWITCH W/ACT SLD SMD
60 | SW2 | EG2486-ND | 1 | EG2211A | SLIDE_SWITCH | SWITCH SLIDE DPDT RT ANG PC MNT
61 | U1 | H2249-ND | 1 | FX2-40S-1.27SV | HIROSE/FX2-40S-1.27SV | CONN RECEPT 40POS 1.27MM STR SMD
62 | U2 | TC7W32FCT-ND | 1 | TC7W32F(TE12L) | SOG.050/8/WG.244/L.200 | IC 2-INPUT OR GATE DUAL FM8
63 | U3 U6 U7 U8 U13 | MC74HC595ADTROSCT-ND | 5 | MC74HC595ADTR2 | SOG.025/16/WG.270/L.200 | IC REG SHFT 8BIT LCH 3ST 16TSSOP
64 | U9 | TC74VHC165FN-ND | 1 | TC74VHC165FN | SOG.050/16/WG.244/L.400 | IC REG SHIFT PISO 8BIT 16-SOL
65 | U11 | ATMEGA48V-10MI-ND | 1 | ATMEGA48V-10MI | ATMEL/32M1-A/32 | IC MCU AVR 4K 5V 12MHZ 32-MLF
66 | U12 | 74LVQ08SC-ND | 1 | 74LVQ08SC | SOG.050/14/WG.244/L.350 | IC GATE AND QUAD LV 2INP 14-SOIC
67 | UCG1 | WM1752-ND | 1 | 53048-1210 | MOLEX/53048-1210/12 | CONN HEADER 12POS 1.25MM R/A TIN
68 | US1 |  | 1 |  | BLKCON2.0MM/VH/TM2OE/6
69 | US2 |  | 1 |  | BLKCON2.0MM/VH/TM2OE/6
70 | VREG3 VREG5 | MAX1626ESA-ND | 2 | MAX1626ESA | SOG.050/8/WG.244/L.200 | IC DC/DCCONV STP-UP 3.3/5V 8SOIC
71 | VR_CI1 | 490-1814-1-ND | 1 | GRM31CR61C106KC31L | SM/C_1206 | CAP CER 10UF 16V 10% X5R 1206
72 | VR_L1 | TKS2509CT-ND | 1 | 636CY-150M=P3 | TOKO/D73_D75_SERIES/2 | INDUCTOR 15UH FIXED D73C SMD
