nesl/ragobots/robot/hw/body/design/REV.C/BOM.xls

RAGOBOT C BOM
Do Not Populate Items in RED
Item Number | Part Reference | Distributor | Distributor_Part_Number | Quantity | Mfr_Part_Number | PCB Footprint | Description | Value | Quantity | SM | TH | FINE | Leadless
1 | 2.5 |  |  | 1 |  | NESL/TESTPOINT_0.040/SM |  | HEADER 1 | 1
2 | AC1 | Digikey | MAX941CSA-ND | 1 | MAX941CSA | SOG.050/8/WG.244/L.200 | IC COMPARATOR SINGLE 3V/5V 8-SOIC | 1 | 1 | 1
3 | ACCEL1 | Digikey | ADXL320JCP-ND | 1 | ADXL320JCP | ANALOG_DEVICES/ADXL320 | IC ACCELEROMETER DUAL-AX 16LFCSP | Accelerometer | 1 |  |  |  | 1
4 | ADC1 | Newark | 77C7015 | 1 | MAX1138EEE | MAXIM/QSOP/16 | I2C 10 bit ADC with 12 channels | MAXIM/MAX1138 | 1 | 1 |  |  | 1
5 | BC1 | Maxim Direct | MAX1908ETI | 1 | Max1908 | MAXIM/QFN/28/5X5X0.8 | Low-Cost Multichemistry Battery Chargers | MAX1908 | 1
6 | BCU DDSC IRISL IRISU | Digikey | ATMEGA168-20MI-ND | 4 | ATMEGA168-20MI | ATMEL/32M1-A/32 | IC MCU AVR 4K 5V 12MHZ 32-MLF | ATMEL/ATMEGA48/88/168/MLF32 | 4 |  |  |  | 4
7 | BC_C1 BC_C2 BC_C3 BC_C7 C10 C42 C61 | Digikey | 490-1582-1-ND | 7 | GRM188F51C105ZA01D | SM/C_0603 | CAP CER 1.0UF 16V Y5V 0603 | 1.0uF | 7 | 7
8 | BC_C4 C1 CB4 CB5 CIN2 VR_CIN1 VR_CO1 | Digikey | 445-1436-1-ND | 7 | C3225X5R1C226M | SM/C_1210 | CAP CER 22UF 16V X5R 20% 1210 | 22uF | 7 | 7
9 | BC_C8 BC_C9 CD1 CD2 | Digikey | PCC103BQCT-ND | 4 | ECJ-0EB1C103K | SM/C_0402 | CAP 10000PF 16V CERAMIC 0402 SMD | 0.01uF | 4 | 4
10 | BC_L1 | Digikey | 308-1269-1-ND | 1 | CDRH104R-100NC | SUMIDA_CDRH104R | INDUCTOR POWER 10UH 4.40A SMD | 10uH | 1 | 1
11 | BC_R1 | Digikey | P33.2LCT-ND | 1 | ERJ-2RKF33R2X | SM/R_0402 | RES 33.2 OHM 1/16W 1% 0402 SMD | 33.2 | 1 | 1
12 | BC_R2 BC_R4 BM_RFILT1 | Digikey | P133KLCT-ND | 3 | ERJ-2RKF1333X | SM/R_0402 | RES 133K OHM 1/16W 1% 0402 SMD | 133K | 3 | 3
13 | BC_R3 BC_R6 | Digikey | P9.31KLCT-ND | 2 | ERJ-2RKF9311X | SM/R_0402 | RES 9.31K OHM 1/16W 1% 0402 SMD | 9.31k | 2 | 2
14 | BC_R5 | Digikey | RHM1.00KLCT-ND | 1 | MCR01MZPF1001 | SM/C_0402 | RES 1.00K OHM 1/16W 1% 0402 SMD | 1k | 1 | 1
15 | BC_RS2 | Digikey | P15MCT-ND | 1 | ERJ-M1WSF15MU | SM/R_2512 | RESISTOR .015 OHM 1W 1% 2512 | 0.015 | 1 | 1
16 | BM1 | Digikey | DS2438Z-ND | 1 | DS2438Z | SOG.050/8/WG.244/L.200 | IC MONITOR SMART BATTERY 8-SOIC | DS2438 | 1 | 1
17 | BM_R1 R45 R46 R80 R81 RV1 | Digikey | RHM5.10KLCT-ND | 6 | MCR01MZPF5101 | SM/R_0402 | RES 5.10K OHM 1/16W 1% 0402 SMD | 5.1K | 6 | 4
18 | BM_RSENS1 VR_RSEN1 VR_RSEN2 | Digikey | P39NBCT-ND | 3 | ERJ-L12KF39MU | SM/C_1812 | RESISTOR .039 OHM 1/2W 1% 1812 | 0.039 | 3 | 3
19 | BRAIN1 | Digikey | H2163-ND | 1 | DF9-51S-1V(54) | XBOW/MICAX | CONN RECEPT 51POS 1MM SMD GOLD | Mica2 Sensor HDR (to Mote) | 1 |  |  | 1
20 | D31 | Digikey | SMAJ15A-FDICT-ND | 1 | SMAJ15A-13-F | SM/DIODE_KIS2/SMA | TVS ZENER UNIDIRECT 400W 15V SMA | 15V | 1
21 | C2 C3 C4 C5 C6 C7 C8 C9 C15 C16 C17 C18 C19 C20 C23 C29 C32 C33 C34 C35 C36 C43 C44 C54 C55 C57 C58 C59 C60 C62 C71 CB3 CB6 CB7 CB8 CB9 CB10 CB11 CB12 CB33 CBS1 VR_C1 VR_C2 VR_C3 VR_C4 | Digikey | 311-1047-1-ND | 45 | 04022F104Z7B20D | SM/C_0402 | CAP .10UF 16V CERAMIC Y5V 0402 | 0.1uF | 45 | 45
22 | C13 | Digikey | 493-2182-1-ND | 1 | UWT1C681MNL1GS | NICHICON/NL10/2 | CAP 680UF 16V ELECT WT SMD | 680u | 1 | 1
23 | C21 | Digikey | P5506-ND | 1 | ECA-0JHG221 | TM/6.3MM_RADIAL_CAP/2 | CAP 220UF 6.3V ELECT NHG RADIAL | 220uF | 1 |  | 1
24 | C22 VR_CI1 | Digikey | 490-1814-1-ND or PCC2413CT-ND | 2 | GRM31CR61C106KC31L | SM/C_1206 | CAP CER 10UF 16V 10% X5R 1206 | 10uF | 2 | 2
25 | C26 | Digikey | 490-3327-1-ND | 1 | GRM219R71H334KA88D | SM/C_0805 | CAP CER .33UF 50V X7R 0805 | 0.33uF | 1 | 1
26 | C30 C31 VR_CS1 | Digikey | 478-1248-1-ND | 3 | 0603YD474KAT2A | SM/C_0603 | CAP CERM .47UF 10% 16V X5R 0603 | 0.47uF | 3 | 3
27 | C45 C46 | Digikey | PCC180CQCT-ND | 2 | ECJ-0EC1H180J | SM/R_0402 | CAP 18PF 50V CERAMIC 0402 SMD | 18pF | 2 | 2
28 | D1 D2 D3 D4 D5 D6 DDSCL D_BCU D_IRISL D_IRISU | Digikey | 160-1167-1-ND | 10 | LTST-C150CKT | SM/D_1206_21 | LED RED CLEAR 1206 SMD | LED | 10 | 10
29 | D7 D8 D9 D10 | Digikey | L20488-ND | 4 | 5305H1/5 | 5305H1/5 | LED RED/GRN T1-3/4 BI-CLR PCB | 5305H1/5 Tricolor LED | 4 |  | 4
30 | D12 D13 D14 D15 D16 D17 | Digikey | 475-1087-ND | 6 | SFH4110 | PANASONIC/LN54 | IR LED 950NM Sidelooker | 950nm | 6 |  | 6
31 | D18 D26 D27 D28 D29 D30 D43 | Digikey | CRS06CT-ND | 7 | CRS06(TE85L) | TOSHIBA/CRS06/A | RECT SCHOTTKY 20V 1A 3-2A1A | . | 7 | 7
32 | DAC1 | Newark | 90C4136 | 1 | MAX550ACUA | MAXIM/UMAX/8 | +2.5V to +5.5V, Low-Power, Single, 8-Bit Voltage-Output DACs in µMAX Package | 1 | 1 |  |  | 1
33 | DBNCE1 | Newark | 02J4593 | 1 | MAX6816 | SM/SOT143_1234 | Single CMOS Switch Debouncer | MAXIM/MAX6816 | 1 | 1
34 | DFF1 DFF2 DFF3 DFF4 DFF5 DFF6 DFF7 | Digikey | TC7WH74FUTCT-ND | 7 | TC7WH74FU(TE12L) | SOG.65M/8/WG4.10/L3.17 | IC FLIP-FLOP D-TYPE SM8-8 | D-TYPE | 7 | 7
35 | DZ1 | Digikey | LM4050CEM3-2.5CT-ND | 1 | LM4050CEM3-2.5 | SM/SOT23_123 | IC PREC MICROPWR REF SOT-23 | NSM/LM4050CEM3 | 1 | 1
36 | FET1 FET2 | Mouser | 512-FDS4935A | 2 | FDS4935A | SOG.050/8/WG.275/L.250 | Fairchild MOSFETs, SOIC-8 -30V, Dual P-channel | Dual P | 2 | 2
37 | FOOT FOOT1 | Digikey | H2065-ND | 2 | DF11-12DP-2DS(22) | HIROSE/DF11-12DP-2DS/12 | CONN HEADER 12POS 2MM RT ANG TIN | 12 | 2 |  | 2
38 | IR1 IR2 IR3 IR4 IR5 IR6 | Digikey | 425-1131-ND | 6 | GP1UD28YK | SHARP/GP1UD28YK/5 | RECEIVER REMOTE CTRL SIDE 40KHZ | SHARP/GP1UD26XK | 6 |  | 6
39 | J5 | Digikey | CP-016-ND | 1 | PJ-016 | CUI/PJ-016 | CONN PWR JACK 4.4MM X 1.65MM PCB | CONN_JACK_PWR | 1 |  | 1
40 | J20 | Digikey | HFL33CT-ND | 1 | FH12-33S-0.5SV | HIROSE/FH12-33S-0.5SV/33/A | CONN FPC/FFC 33POS .5MM VERT SMD | 33 | 1 |  |  | 1
41 | J30 J31 J32 J33 J34 J42 | Digikey | RHM0.0JCT-ND | 6 | MCR01MZPJ000 | SM/C_0402 | RES 0.0 OHM 1/16W 5% 0402 SMD | 0 | 6 | 6
42 | J_NERVE | Samtec | MB1-150-01-F-S-02-SL | 1 | MB1-150-01-F-S-02-SL | SAMTEC/MB1/50/A | 1mm Mini Card Guide Socket (MB1 Series) | 50 | 1 |  |  | 1
43 | L2 L3 L4 L6 L7 L8 L9 L11 L50 | Digikey | 445-1553-1-ND | 9 | MMZ1608Y152B | SM/C_0603 | FERRITE CHIP 1500 OHM 300MA 0603 | 1.5K | 9 | 9
44 | L5 | Digikey | 308-1050-1-ND | 1 | CDRH125-220MC | SUMIDA/CDRH125 | POWER INDUCTOR 22UH 2.8A SMD | 22uH | 1 | 1
45 | LED BAR GRAPH 1 | Mouser | 512-MV5E164 | 1 | MV5E164 | DIP.100/20/W.300/L1.000 | LED BARGRAPH 10-SEG GRN/YLW/RED | LUMEX SSA-LXB10SRW-GF/LP | 1 |  | 1
46 | LS1 |  |  | 1 |  | BLKCON2.0MM/VH/TM1SQ/2 |  | SPEAKER | 1
47 | LS2 |  |  | 1 |  | BLKCON2.0MM/VH/TM1SQ/2 |  | SPEAKER | 1
48 | LV3 LV4 | Digikey | MAX3371EXT-TCT-ND | 2 | MAX3371EXT-T | TI/SC70/6 | IC LEVEL TRANSLATOR 2MBPS SC70-6 | . | 2 | 2
49 | MAG1 | Digikey | HMC6052-ND | 1 | HMC6052 | HONEYWELL/HMC6052/14 | IC SENSOR MAGN COMPASS 2AXIS SMD | HMC6052 | 1 |  |  |  | 1
50 | MAGX |  |  | 1 |  | NESL/TESTPOINT_0.040/SM |  | HEADER 1 | 1
51 | MAGY |  |  | 1 |  | NESL/TESTPOINT_0.040/SM |  | HEADER 1 | 1
52 | MECH5 MECH6 MECH7 MECH8 | ServoCity, Inc. | BTR-7006 | 4 | BTR-7006 | SERVOCITY/BTR-7006 | 90 Degree Universal Servo Mount | SERVOCITY/90_DEG_SERVO_MOUNTS | 4
53 | NECK | Samtec | HSEC8-125-01-SM-DVA | 1 | HSEC8-125-01-SM-DVA | SAMTEC/HSEC8/50 | 50 pin Card Edge Connector | 50 | 1 |  |  | 1
54 | PAN/TILT1 | Digikey | A23858-ND | 1 | 644861-6 | TYCO/644861-6 | CONN HEADER VERT .100 6POS TIN | 6x1 | 1 |  | 1
55 | PROG1 | Digikey | A26285-ND | 1 | 103310-1 | AMP/103310-1/10 | CONN HEADER LOPRO R/A 10POS 15AU | 5x2 | 1 |  | 1
56 | P_BCU P_DDSC P_IRISL P_IRISU | Mill-Max Manufacturing Corp. | 851-99-005-10-001000 | 4 | 851-99-005-10-001000 | MILLMAX/851XX00510001000/5/PGM | 0.050" pitch socket, 5pin, low-profile |  | 4
57 | Q2 Q4 Q12 | Newark | 82C2573 | 3 | FDS6898A | SOG.050/8/WG.275/L.250 | SO-8 DUAL N-CH 20V PowerTrench MOSFETs | Dual N-CH | 3 | 3
58 | Q3 Q11 Q13 | Digikey | NDS8958CT-ND | 3 | NDS8958 | SOG.050/8/WG.275/L.250 | MOSFET N/P-CH DL 30V 5.3A 8-SOIC | dual mosfet | 3 | 3
59 | R1 R2 R3 R4 R5 R6 R37 R64 R72 R73 | Digikey | P150LCT-ND | 10 | ERJ-2RKF1500X | SM/R_0402 | RES 150 OHM 1/16W 1% 0402 SMD | 150 | 10 | 10
60 | R7 R8 R9 R10 R11 R12 | Digikey | P47.5LCT-ND | 6 | ERJ-2RKF47R5X | SM/C_0402 | RES 47.5 OHM 1/16W 1% 0402 SMD | 47.5 | 6 | 6
61 | R13 R21 R22 R23 R24 R27 R28 R29 R36 R48 R50 | Digikey | P33.2KLCT-ND | 11 | ERJ-2RKF3322X | SM/C_0402 | RES 33.2K OHM 1/16W 1% 0402 SMD | 33k | 11 | 11
62 | R14 R15 | Digikey | RHM4.70LCT-ND | 2 | MCR01MZPFL4R70 | SM/C_0402 | RES 4.70 OHM 1/16W 1% 0402 SMD | 4.7 | 2 | 2
63 | R16 | Digikey | P17.4LCT-ND | 1 | ERJ-2RKF17R4X | SM/R_0402 | RES 17.4 OHM 1/16W 1% 0402 SMD | 17.4 | 1 | 1
64 | R17 R20 | Digikey | P1.0MJCT-ND | 2 | ERJ-2GEJ105X | SM/C_0402 | RES 1.0M OHM 1/16W 5% 0402 SMD | 1.0M | 2 | 2
65 | R19 R26 | Digikey | P191LCT-ND | 2 | ERJ-2RKF1910X | SM/C_0402 | RES 191 OHM 1/16W 1% 0402 SMD | 191 | 2 | 2
66 | R25 | Digikey | P27.4LCT-ND | 1 | ERJ-2RKF27R4X | SM/R_0402 | RES 27.4 OHM 1/16W 1% 0402 SMD | 27.4 | 1 | 1
67 | R31 R32 R83 | Digikey | P27KACT-ND | 3 | ERJ-6GEYJ273V | SM/C_0805 | RES 27K OHM 1/8W 5% 0805 SMD | 27K | 3 | 3
68 | R34 R35 R43 R44 R51 R52 R53 R54 R55 R56 R82 | Digikey | RHM330LCT-ND | 11 | MCR01MZPF3300 | SM/R_0402 | RES 330 OHM 1/16W 1% 0402 SMD | 330 | 11 | 11
69 | RN1 | Digikey | Y1470CT-ND | 1 | EXB-2HV470JV | SM/0402X8 | RES ARRAY 47 OHM 5% 8 RES SMD | 47 | 1 | 1
70 | RN2 RN3 | Digikey | Y1105CT-ND | 2 | EXB-2HV105JV | SM/0402X8 | RES ARRAY 1.0M OHM 5% 8 RES SMD | 1.0Meg | 2 | 2
71 | SR+ |  |  | 1 |  | NESL/TESTPOINT_0.040/SM |  | HEADER 1 | 1
72 | SW1 | Digikey | P8002SCT-ND | 1 | EVQ-PHP03T | PANASONIC/EVQPH/4 | LIGHT TOUCH SWITCH W/ACT SLD SMD | SPST-M-NO | 1 | 1
73 | SW2 | Digikey | EG2486-ND | 1 | EG2211A | SLIDE_SWITCH | SWITCH SLIDE DPDT RT ANG PC MNT | slide switch | 1 |  | 1
74 | SW3 | Digikey | LTC4412ES6-ND | 1 | LTC4412ES6 | LINEAR/TSOT23/6 | IC CTRLR LOWLOSS PWRPATH SOT23-6 | PowerPath Ctlr | 1 | 1
75 | TP1 |  |  | 1 |  | NESL/TESTPOINT_0.040/SM |  | HEADER 1 | 1
76 | TP2 |  |  | 1 |  | NESL/TESTPOINT_0.040/SM |  | HEADER 1 | 1
77 | TP3 |  |  | 1 |  | NESL/TESTPOINT_0.040/SM |  | HEADER 1 | 1
78 | TP4 |  |  | 1 |  | NESL/TESTPOINT_0.040/SM |  | HEADER 1 | 1
79 | TP5 |  |  | 1 |  | NESL/TESTPOINT_0.040/SM |  | HEADER 1 | 1
80 | TP6 |  |  | 1 |  | NESL/TESTPOINT_0.040/SM |  | HEADER 1 | 1
81 | TP7 |  |  | 1 |  | NESL/TESTPOINT_0.040/SM |  | HEADER 1 | 1
82 | TP8 |  |  | 1 |  | NESL/TESTPOINT_0.040/SM |  | HEADER 1 | 1
83 | U3 U6 U7 U8 U9 | Digikey | MC74HC595ADTROSCT-ND | 5 | MC74HC595ADTR2 | SOG.025/16/WG.270/L.200 | IC REG SHFT 8BIT LCH 3ST 16TSSOP | ON/MC74HC595A/TSSOP16/B | 5 |  |  | 5
84 | U12 | Digikey | 74LVQ08SC-ND | 1 | 74LVQ08SC | SOG.050/14/WG.244/L.350 | IC GATE AND QUAD LV 2INP 14-SOIC | 4 | 1 | 1
85 | U16 U51 U69 | Digikey | TC74HC14AFN-ND | 3 | TC74HC14AFN | SOG.050/14/WG.244/L.350 | IC INV HEX SCHMITT TRIG 14-SOL | TOSHIBA/74HC14/14 | 3 | 3
86 | U17 | Newark | 83F4571 | 1 | A3966SLB | SOG.050/16/WG.420/L.425 | Dual full-bridge pwm motor driver | . | 1 | 1
87 | U50 | Digikey | 568-1052-5-ND | 1 | PCA9554APW | SOG.65M/16/WG6.70/L5.10 | IC I2C I/O EXPANDER GP 16-TSSOP | 8bit I/O register | 1 | 1 |  |  |  | 75
88 | UCG1 | Digikey | H2066-ND | 1 | DF11-14DP-2DS(22) | HIROSE/DF11-14DP-2DS/14 | CONN HEADER 14POS 2MM RT ANG TIN | 14 | 1 |  | 1
89 | VREG3 VREG5 | Digikey | MAX1626ESA-ND | 2 | MAX1626ESA | SOG.050/8/WG.244/L.200 | IC DC/DCCONV STP-UP 3.3/5V 8SOIC | MAXIM/MAX1626 | 2 | 2
90 | VR_L1 | Digikey | TKS2509CT-ND or 445-2001-1-ND | 1 | 636CY-150M=P3 | TOKO/D73_D75_SERIES/2 | INDUCTOR 15UH FIXED D73C SMD | 15uH | 1 | 1
91 | Y1 | Digikey | XC738CT-ND | 1 | ECS-160-20-5PDN-TR | ECS/CSM-7/2 | CRYSTAL 16.00MHZ 20PF SMD | 16.000 MHz | 1 | 1
 |  |  |  |  |  |  |  |  |  | 207 | 25 | 10 | 7
