nesl/ragobots/robot/hw/neck.display/design/REV.A/to_asm/BOM.RBTNDPA.xls

Item Number | Part Reference | Distributor | Distributor_Part_Number | Mfr_Name | Mfr_Part_Number | Description | Qty | Unit_Price
DIGIKEY
1 | C1 C2 C22 | Digikey | 587-1304-1-ND | Taiyo Yuden | JMK212BJ106KD-T | CAP CER 10UF 6.3V X5R 0805 | 3 | $0.33
2 | C3 C4 C5 C6 C9 C10 C13 C14 C15 C16 C17 C18 C21 C24 C26 C27 | Digikey | 311-1047-1-ND | Yageo America | 04022F104Z7B20D | CAP .10UF 16V CERAMIC Y5V 0402 | 16 | $0.09
3 | C7 C8 | Digikey | PCC180CQCT-ND | Panasonic - ECG | ECJ-0EC1H180J | CAP 18PF 50V CERAMIC 0402 SMD | 2 | $0.03
4 | C11 C19 C28 | Digikey | PCC1762CT-ND | Panasonic - ECG | ECJ-1VB1C104K | CAP .1UF 16V CERAMIC X7R 0603 | 3 | $0.05
5 | C12 C20 | Digikey | 490-1582-1-ND | Murata Electronics North America | GRM188F51C105ZA01D | CAP CER 1.0UF 16V Y5V 0603 | 2 | $0.07
6 | C23 | Digikey | 587-1255-1-ND | Taiyo Yuden | JMK107BJ475MA-T | CAP CER 4.7UF 6.3V X5R 0603 | 1 | $0.24
7 | C25 | Digikey | PCC1756CT-ND | Panasonic - ECG | ECJ-1VB1C333K | CAP 33000PF 16V CERM X7R 0603 | 1 | $0.05
9 | D1 D2 D3 D4 D7 D9 | Digikey | 160-1167-1-ND | Lite-On Trading USA, Inc. | LTST-C150CKT | LED RED CLEAR 1206 SMD | 6 | $0.11
10 | D5 D6 D8 | Digikey | 160-1169-1-ND | Lite-On Trading USA, Inc. | LTST-C150GKT | LED GREEN CLEAR 1206 SMD | 3 | $0.11
11 | DFLH | Digikey | ATMEGA48V-10MI-ND | Atmel | ATMEGA48V-10MI | IC MCU AVR 4K 5V 12MHZ 32-MLF | 1 | $2.69
12 | GPU | Digikey | ATMEGA128L-8AI-ND | Atmel | ATMEGA128L-8AI | IC AVR MCU 128K 8MHZ LV 64-TQFP | 1 | $15.05
15 | J3 | Digikey | RHM0.0JCT-ND | Rohm | MCR01MZPJ000 | RES 0.0 OHM 1/16W 5% 0402 SMD | 1 | $0.07
18 | PS1 PS2 | Digikey | 296-2566-5-ND | Texas Instruments | TPS2031D | IC 0.6A POWER DIST SWITCH 8-SOIC | 2 | $2.25
20 | Q1 | Digikey | NDS8958CT-ND | Fairchild Semiconductor | NDS8958 | MOSFET N/P-CH DL 30V 5.3A 8-SOIC | 1 | $1.33
21 | R1 | Digikey | D4AA14-ND | Panasonic - ECG | EVN-D8AA03B14 | TRIMPOT 10K CARBON LAYDOWN (103) | 1 | $0.35
22 | R2 | Digikey | RHM330LCT-ND | Rohm | MCR01MZPF3300 | RES 330 OHM 1/16W 1% 0402 SMD | 1 | $0.08
23 | R3 R4 R5 R7 R9 R10 R13 R14 R18 R23 | Digikey | P33.2KLCT-ND | Panasonic - ECG | ERJ-2RKF3322X | RES 33.2K OHM 1/16W 1% 0402 SMD | 10 | $0.10
24 | R6 R8 R11 R12 R21 R32 R35 R39 R40 | Digikey | RHM150LCT-ND | Rohm | MCR01MZPF1500 | RES 150 OHM 1/16W 1% 0402 SMD | 9 | $0.08
25 | R15 R16 R17 R22 R26 | Digikey | RHM470JCT-ND | Rohm | MCR01MZPJ471 | RES 470 OHM 1/16W 5% 0402 SMD | 5 | $0.07
26 | R19 R20 | Digikey | P10.0KHCT-ND | Panasonic - ECG | ERJ-3EKF1002V | RES 10.0K OHM 1/10W 1% 0603 SMD | 2 | $0.09
27 | R24 R25 | Digikey | RHM27JCT-ND | Rohm | MCR01MZPJ270 | RES 27 OHM 1/16W 5% 0402 SMD | 2 | $0.07
28 | R27 R28 R29 R33 | Digikey | RHM1.00MLCT-ND | Rohm | MCR01MZPF1004 | RES 1.00M OHM 1/16W 1% 0402 SMD | 4 | $0.08
29 | R30 R31 R36 R38 | Digikey | RHM0.0GCT-ND | Rohm | MCR03EZPJ000 | RES 0.0 OHM 1/10W 5% 0603 SMD | 4 | $0.07
30 | R34 | Digikey | RHM1.50KLCT-ND | Rohm | MCR01MZPF1501 | RES 1.50K OHM 1/16W 1% 0402 SMD | 1 | $0.08
31 | R41 | Digikey | RHM2.2KJCT-ND | Rohm | MCR01MZPJ222 | RES 2.2K OHM 1/16W 5% 0402 SMD | 1 | $0.07
32 | R42 | Digikey | RHM10KJCT-ND | Rohm | MCR01MZPJ103 | RES 10K OHM 1/16W 5% 0402 SMD | 1 | $0.07
33 | SW1 SW2 SW3 SW4 SW5 | Digikey | P8002SCT-ND | Panasonic - ECG | EVQ-PHP03T | LIGHT TOUCH SWITCH W/ACT SLD SMD | 5 | $0.86
34 | U1 | Digikey | 568-1029-5-ND | Philips | PCA9513D | IC HOTSWAP I2C/SMBUS BUFF 8-SOIC | 1 | $2.25
35 | U2 U3 | Digikey | PI5C3384Q-ND | Pericom | PI5C3384Q | IC 10BIT 2PORT BUS SWITCH 24QSOP | 2 | $0.72
37 | U6 | Digikey | 93C66B-I/SN-ND | Microchip Technology | 93C66B-I/SN | IC SRL EEPROM 4K 256X16 5V 8SOIC | 1 | $0.60
38 | X1 | Digikey | 490-1218-1-ND | Murata Electronics North America | CSTCR6M00G53Z-R0 | RESONATOR 6.00MHZ CERAMIC INDUST | 1 | $0.65
39 | Y1 | Digikey | XC694CT-ND | ECS Inc | ECS-160-20-5P-TR | CRYSTAL 16.00MHZ 20PF SMD | 1 | $0.73
MOUSER
8 | CN1 | Mouser | 538-54819-0572 | Molex/Waldom Electronics Corp | 54819-0572 | Molex USB Connectors USB Mini-B Recept On-The-Go, | 1
16 | L1 L2 L3 L4 L5 | Mouser | 810-MMZ1608A152E | TDK Corporation | MMZ1608A152E | TDK Ferrite Chip Beads - Z=2.5K @ 100MHz | 5 | $0.10
36 | U4 | Mouser | 619-604-00033G | FTDI, Ltd. | FT2232L | Dual UART FTDI USB Interface ICs 48P-LQFP FT2232L | 1
DO NOT POPULATE |  |  |  |  |  |  | 102
13 | J1 | Card Edge, just a PCB feature
40 | J2 | Test points, not actual part
19 | P_DFLH P_GPU | Mill-Max Manufacturing Corp. | 851-99-006-10-001000 | Mill-Max Manufacturing Corp. | 851-99-006-10-001000 | 0.050" pitch socket, 6pin, low-profile | 2
17 | LCD1 | CrystalFontz | CFAG12232D-YYH-N | CrystalFontz America, Inc. | CFAG12232D-YYH-N | Graphic 122x32 LCD module with parallel data interface and backlight | 1 | $20.03
17 | LCD1 (cont'd) | Mouser | HEADER 0.050"; Single Row; 16pos
