nesl/ragobots/robot/hw/body/docs/Design Sheets.xls

Sheet: Ragobot Connector
 |  | This side is the on the Mica2 |  | This side is on the Ragobot
ATMEGA128L | Function | Mica2 | # | Ragobot | Special Behavior | IF | Planes | Signal | Type
 |  | GND | 1 | GND_CN |  |  | 1 | SENSOR_GND | Analog
 |  | VSNSR/VCC | 2 | BRAIN_DD | Device discovery (output) | DDS |  | SENSOR_VCC | Analog
E7 |  | INT3 | 3 | MASTER ALERT (head0, neck0, nerve0, bcu0) | interrupt / wake (or'd from all interfaces)
E6 | MICAZ - Q SIGNAL | INT2 | 4 | DNC |  |  | 2 | VCC_CN | Digital
E5 |  | INT1 | 5 | PUSHBUTTON | interrupt / wake | YES |  | GND_CN | Digital
E4 |  | INT0 | 6 | HEAD GPIO 0 (interrupt) / irr_out | interrupt
A5 | BATTERY MONITOR ENABLE | BAT_MON | 7 | NERVE GPIO0 |  |  | 3 | MOTOR_VCC | Analog
A0 | LED | LED3 | 8 | DNC |  |  |  | MOTOR_GND | Analog
A1 | LED | LED2 | 9 | DNC
A2 | LED | LED1 | 10 | DNC |  |  | 4 | SERVO_VCC
 |  | RD | 11 | NERVE1 | flow control |  |  | SERVO_GND
 |  | WR | 12 | NERVE2 | flow control
 |  | ALE | 13 | BCU1 |  |  | 5 | EXPANSION_VCC
 |  | PW7 | 14 | IR DISTANCE SENSOR (Vin) |  |  |  | EXPANSION_GND
 | FLASH MEMORY | USART1_CLK | 15
 |  | PROG_MOSI | 16 | DNC
 |  | PROG_MISO | 17 | DNC
 |  | SPI_SCK | 18 | DNC
 | FLASH MEMORY | USART1_RXD | 19 | NECK SERIAL
 | FLASH MEMORY | USART1_TXD | 20 | NECK SERIAL
 |  | I2C_CLK | 21 | I2C SCL
 |  | I2C_DATA | 22 | I2C SDA
 |  | PWM0 | 23 | NERVE GPIO1
 |  | PWM1A | 24 | TILT SERVO | NECK | NECK
 |  | AC+ | 25 | NECK GPIO0 |  | YES
 |  | AC- | 26 | NECK GPIO1/PWM
 |  | UART_RXD0 | 27 | NERVE SERIAL
 |  | UART_TXD0 | 28 | NERVE SERIAL
 |  | PW0 | 29 | BCU0 / MOTOR STOP
 |  | PW1 | 30 | 1-WIRE BATTERY MONITOR DATA | 1-WIRE
 |  | PW2 | 31 | NECK GPIO2
 |  | PW3 | 32 | CB2 RESET |  | CB2
 |  | PW4 | 33 | CB2 UPDATE |  | CB2
 |  | PW5 | 34 | CB2 CLOCK |  | CB2
 |  | PW6 | 35 | CB2 DATA IN |  | CB2
 | BATTERY MONITOR | ADC7 | 36 | JTAG | NECK GPIO 3 | NECK
 |  | ADC6 | 37 | JTAG | NECK GPIO 2 | NECK
 |  | ADC5 | 38 | JTAG | NECK GPIO 1 | NECK
 |  | ADC4 | 39 | JTAG | NECK GPIO 0 | NECK
 |  | ADC3 | 40 | HEAD GPIO1
 |  | ADC2 | 41 | HEAD GPIO2
F1 | THERMISTOR | ADC1 | 42 | CARGO GPIO0 |  | NO!
 | RADIO RSSI | ADC0 | 43 | CARGO GPIO1
A7 |  | THERM_PWR | 44 | NERVE GPIO2
DNC | No Connection | THRU1 | 45 | VBATT
DNC | No Connection | THRU2 | 46 | VBATT
DNC | No Connection | THRU3 | 47 | 5V
RST | Reset | RSTN | 48 | JTAG & STK300 |  | NECK
 |  | PWM1B | 49 | PAN SERVO | NECK | NECK
 |  | VCC | 50 | VCC_CN
 |  | GND | 51 | GND_CN

Sheet: Digikey Order
 | LAB
 |  | 100 mil connector assembly stuff (pins and crimp tool and empty boxes)
 |  | More power jacks and plugs (also get different size)
 |  | Standoff's different heights
 |  | Solder for SMT
 |  |  |  | MANUFACTURER# | unit price | disc price | qty for disc | # in design | sub-total
 | LED's
 |  | 5100H6-ND | LED BLUE 1/4 HOLE PANEL MOUNT |  | $2.17
 |  | P465-ND | Super Bright Blue LED (leads, no package) |  | $2.67 |  |  | 1 | 2.67
 |  | L20488-ND | LED RED/GRN T1-3/4 BI-CLR PCB |  | $1.94 | $1.57 | 25 | 4 | 7.76
 |  | 350-1366-ND | LED 3MM HIGH EFF DIFF YELLOW |  | $0.60 |  |  | 10 | 6
 |  | 350-1363-ND | LED 3MM HIGH EFF DIFF RED |  | $0.60 |  |  | 10 | 6
 |  | 350-1364-ND | LED 3MM HIGH EFF DIFF ORANGE |  | $0.39 |  |  | 10 | 3.9
 |  | MV5E164-ND | LED BARGRAPH 10-SEG GRN/YLW/RED |  | $0.80 | $0.80 | 20 | 20 | 15.95
 | Diodes
 |  | MBR0530T1OSCT-ND | DIODE SCHOTTKY 30V 0.5A SOD-123 |  |  | $0.31 | 10 | 2
 | Ragobot IC's
 |  | TC74HC595AFN-ND | IC REG/LATCH SHIFT 8BIT 16-SOL |  | $0.58 |  | 25
RESISTORS
 | Resistor Arrays
 |  | Y1470CT-ND | RES ARRAY 47 OHM 5% 8 RES SMD |  | $0.18 |  | 10
 |  | Y1680CT-ND | RES ARRAY 68 OHM 5% 8 RES SMD |  | $0.18 |  | 10
 | Resistors (1210, 1%, 1/4W) |  | SM/L_1210
 |  | P33.2AACT-ND | 33.2 |  |  | $0.38 | 10
 |  | P75.0AACT-ND | 75 |  |  | $0.38 | 10
 |  | P1.00KAACT-ND | 1K |  |  | $0.38 | 10
 |  | P2.00KAACT-ND | 2K
 |  | P3.57KAACT-ND | 3.57K |  |  | $0.38 | 10
 |  | P5.1KVCT-ND | 5.1K |  |  | $0.27 | 10
 |  | P9.31KAACT-ND | 9.31K |  |  | $0.38 | 10
 |  | P23.2KAACT-ND | 23.2K
 |  | P24.9KAACT-ND | 24.9K |  |  | $0.38 | 10
 |  | P30.9KAACT-ND | 30.9K |  |  | $0.38 | 10
 |  | P33KAACT-ND | 33K |  |  | $0.38 | 10
 |  | P37.4KAACT-ND | 37.4K |  |  | $0.38 | 10
 |  | P39KAACT-ND | 39K |  |  | $0.38 | 10
 |  | P41.2KAACT-ND | 41.2K |  |  | $0.38 | 10
 |  | P75.0KAACT-ND | 75K |  |  | $0.38 | 10
 |  | P100KAACT-ND | 100K |  |  | $0.38 | 10
 |  | P130KAACT-ND | 130K |  |  | $0.38 | 10
 |  | P200KAACT-ND | 200K |  |  | $0.38 | 10
 | Resistors (2512, 1%, 1W)
 |  | P15MCT-ND | 0.015 |  |  | $0.82 | 10
 |  | P10MCT-ND | 0.01 |  |  | $0.82 | 10
 | Resistors (1812, 1%, 1/2W)
 |  | P25NBCT-ND | 0.025 |  |  | $0.70 | 10
CAPACITORS
 | Capacitors
 |  | PCF1126CT-ND | 0.1uF Bypass 0805, FILM |  |  | $0.33 | 10
 | Capacitors (through hole)
 |  | 399-1405-ND | 22uF TM |  | $0.93 | $0.80 | 10
 |  | P5518-ND | CAP 220UF 10V ELECT NHG RADIAL | ECA-1AHG221 | $0.36 | $18.70 | 10
 | Capacitors (1210, 10%, ceramic) |  | SM/L_1210
 | 1206!!! | BC1320CT-ND | 4.7nF |  |  | $0.13 | 10
 | 1206!!! | 311-1208-1-ND | 5.6nF |  |  | $0.11 | 10
 | 1206!!! | 311-1211-1-ND | 8.2nF |  |  | $0.11 | 10
 | 1206!!! | BC1321CT-ND | 10nF |  |  | $0.13 | 10
 |  | PCC2303CT-ND | 1uF | Panasonic - ECG |  | $0.64 | 10
 |  | 478-1608-1-ND | 0.01uF | AVX |  | $1.04 | 10
 | Inductors
 |  | 308-1269-1-ND | INDUCTOR POWER 10UH 4.40A SMD |  | $2.45 |  |  | 1
 |  |  | H104R-100NC
 |  | 308-1243-1-ND | POWER INDUCTOR 33UH 1.2A SMD |  | $1.46 |  |  | 1
 |  | 308-1134-1-ND | POWER INDUCTOR 39UH 1.28A SMD |  | $1.56 |  |  | 1
 | MOUSER
 |  | 512-FDS6912A | SO-8 SO-8 DUAL N-CH 30V |  | $1.40 | $1.05 | 25 | 1
 |  |  |  |  |  |  |  |  | 0
 | Ram |  |  |  |  |  |  |  | 0
 |  | Connector for 20 gague wire |  |  |  |  |  |  | 0
 |  | Two pot chips |  |  |  |  |  |  | 0
 |  |  |  |  | $20.00 |  |  | 5 | 100
 |  |  |  |  | $150.00 |  |  | 1 | 150
 |  |  |  |  |  |  |  |  | 292.28

Sheet: Despec'd Parts
399-1643-1-ND | 0.1uF Cap SMD | $0.18 | $0.15 | 10
 | T491A104K035AS
399-1795-1-ND | 220uF Tantalum Cap 10v, 10% | $3.63
 | high surge
67-1525-ND | LED ARRAY 10-SEG CURVED SUPR RED | $6.72 | $5.60 | 25 | 1 | 0

Sheet: Component Groups
Group Number | Description | DONE
0 | unused
1 | battery charger | X
2 | batt monitor | X
3 | 3.3v REG | X
4 | 5V REG | X
5 | SERVOS | X
6 | MOTOR CONTROL | X
7 | RGB_CB2
8 | IRDAR
9 | CB2+1 | x
10 | CB2+LIGHTBAR | X
11 | CB2+2

Sheet: Analog Performance
Frequency (MHz) | Attenuation (dB) | Vpeak | Attenuation (dB)
1000 | -20.57541105 | 0.09359 | -20.57541105
500 | -21.06025132 | 0.088509 | -21.06025132
400 | -21.07547568 | 0.088354 | -21.07547568
200 | -23.12015431 | 0.069822 | -23.12015431
100 | -20.45247939 | 0.094924 | -20.45247939
10 | -4.894702172 | 0.5692 | -4.894702172
1 | -0.1136569466 | 0.987 | -0.1136569466

Sheet: RFP12N10L characterization
Vload | Vsupply | Vgate | Loss (%) | measurement mismatch
5.2876 | 5.301 | 5.0 | -0.253% | 0.0006
5.2871 | 5.301 | 4.0 | -0.262%
5.2865 | 5.301 | 3.3 | -0.274% | measurements taken @ 50mA load
5.2862 | 5.301 | 3.2 | -0.279%
5.2862 | 5.301 | 3.1 | -0.279%
5.2859 | 5.301 | 3.0 | -0.285%
5.2857 | 5.301 | 2.9 | -0.289%
5.2848 | 5.301 | 2.7 | -0.306%
4.9881 | 5.000 | 5.0 | -0.238%
4.9876 | 5.000 | 4.0 | -0.248%
4.9871 | 5.000 | 3.3 | -0.258%
4.9870 | 5.000 | 3.2 | -0.260%
4.9868 | 5.000 | 3.1 | -0.264%
4.9866 | 5.000 | 3.0 | -0.268%
4.9864 | 5.000 | 2.9 | -0.272%
4.9852 | 5.000 | 2.7 | -0.296%
4.5885 | 4.600 | 5.0 | -0.250%
4.5882 | 4.600 | 4.0 | -0.257%
4.5876 | 4.600 | 3.3 | -0.270%
4.5874 | 4.600 | 3.2 | -0.274%
4.5872 | 4.600 | 3.1 | -0.278%
4.5872 | 4.600 | 3.0 | -0.278%
4.5869 | 4.600 | 2.9 | -0.285%
4.5858 | 4.600 | 2.7 | -0.309%
4.2706 | 4.601 | 2.9 | -7.181% | measurements taken at 500mA load
4.6981 | 5.000 | 2.9 | -6.038%
4.9368 | 5.300 | 2.9 | -6.853%
4.3162 | 4.600 | 3.4 | -6.170%
4.6560 | 5.000 | 3.4 | -6.880%
4.9802 | 5.300 | 3.4 | -6.034%
4.9679 | 4.999 | 3.3 | -0.622% | Measurements taken at 100mA load
4.9686 | 4.999 | 3.7 | -0.608%
4.9660 | 4.999 | 2.9 | -0.660%
 | 4.999 |  | -100.000%
 | 4.999 |  | -100.000%
 | 4.999 |  | -100.000%
 | 4.999 |  | -100.000%
