nesl/ragobots/robot/hw/overview/doc/Ragobot_Power.xls

RAGOBOT POWER BUDGET
 | Global Performance Params | Percentage of time in motion | 50%
 |  | Percentage of time firing weapon | 5%
 | Budget Outputs | Total power consumption (W) | 2.254
 |  | Runtime Estimate (Hr) | 1.019
Group | Description | Part# | Duty (%) | Qty (#) | V (V) | I (A) | P (W) | Additional Notes
POWER | Battery | Renata |  | 2 | 3.7 | 0.345 | 2.553 | (Rating is for 1 hour)
 | Regulator | National Semiconductor |  |  | efficiency | 90% | 2.2977 | <-- This is how much power we have to use
SENSOR BOARD
IR | 40kHz Sharp Side IR | 425-1131-ND | 100% | 5 | 3.3 | 0.0002 | 0.0033
 | Bi-dir obstacle avoidance | LN59-ND | 50% | 3 | 3.3 | 0.01 | 0.0495
 |  |  |  |  |  |  | 0
DSP | TMS320VC5416PGE120 | 296-12169-ND | 100% | 1 | 3.3 | 0.2 | 0.66
 | 1 MB Flash |  |  |  |  |  | 0
 | CB2 MUX |  | 0% | 1 |  |  | 0
 | USB interface | FT232BM | 0% | 1 | 3.3 | 0.025 | 0
 |  |  |  |  |  |  | 0
Audio | Class D Audio Amp | MAX9700 |  |  |  |  | 0
 | Speaker (Panasonic Card Type) | WM-R30B |  |  |  |  | 0
 | Microphone Pre-amp | MAX4061 |  |  |  |  | 0
 | Digital Pot for Gain Control |  |  |  |  |  | 0
 |  |  |  |  |  |  | 0
INS | Analog Devices ADXL203 Accelerometer |  | 100% | 1 | 5 | 0.0007 | 0.0035
 | Analog Devices ADXR150 Gyroscope |  | 100% | 1 | 5 | 0.006 | 0.03
 |  |  |  |  |  |  | 0
RF | RFM TR1000 transceiver at 916MHz |  |  |  |  |  | 0
 |  |  |  |  |  |  | 0
POWER | Independent 1.8, 3.3, 5, & 15V power supply. |  |  |  |  |  | 0
 | (3.3 and 5 also available from the main-board) |  |  |  |  |  | 0
 |  |  |  |  |  |  | 0
 |  |  |  |  |  |  | 0
 |  |  |  |  |  |  | 0
 |  |  |  |  |  |  | 0
PERV BOARD
 | Pushbutton | Panasonic from Vorata | 0% | 1 | 0 | 0 | 0
 | MAX4052 Multiplexer/Switch | MAX4052 | 0% | 1 | 5 | 1e-06 | 0 | 0
 | Synch Bin. Counter | SN74HC191 | 0% | 1 | 5 | 8e-05 | 0
 | Max6816 Debounce |  | 0% | 1 | 5 | 6e-06 | 0
 | Signal LED |  | 0% | 3 |  |  | 0
 | Analog Devices ADXL103 (z-axis for INS sub-system)\ |  | 100% | 1 | 5 | 0.0007 | 0.0035
 | RFID M1-mini Reader/antenna |  | 100% | 1 | 3.3 | 0.05 | 0.165
 |  |  |  |  |  |  | 0
HEAD BOARD
VISIBLE | VGA Color Video Camera | OV7649 |  |  |  |  | 0
 | Blue LED (spotlight) | P465-ND | 5% | 1 | 3.3 | 0.1 | 0.0165
IR | Weapon (LN51L) | LN51L-ND | 5% | 1 | 3.3 | 0.1 | 0.0165
 | Sharp IR Ranger (GP2D02) | GP2D02 | 50% | 1 | 5 | 0.022 | 0.055
AUDIO | Microphone |  |  |  |  |  | 0
 |  |  |  |  |  |  | 0
MAIN BOARD
MOTORS | Main Propulsion | Plantraco Desktop Rover | 50% | 2 | 5 | 0.25 | 1.25
IR | 40kHz Sharp Top IR (Cliff Detector) | 425-1119-ND | 100% | 1 | 3.3 | 0.0002 | 0.00066
 | 40kHz Sharp Side IR (front) | 425-1131-ND | 100% | 1 | 3.3 | 0.0002 | 0.00066
INS | Compass |  | 100% |  |  |  | 0
 |  |  |  |  |  |  | 0
 |  |  |  |  |  |  | 0
 |  |  |  |  |  |  | 0
