nesl/ragobots/(list of files, cad)

Other CAD files:
robot/hw/body/design/REV.A/RAGOBOT.STL
