nesl/ragobots/robot/hw/body/docs/IR_Power/Cliff_Low_Power_TX/PRINT_09.TXT

Anlg Ch State  Volts/div  Position  Coupling  BW Limit  Invert 
 Ch 2:    On     200mV/    12.0mV      DC        Off      Off  

Anlg Ch  Probe 
 Ch 2:  10 : 1 

Trigger Mode  Coupling  Noise Rej  HF Reject  Holdoff 
  Edge  Auto     DC        Off        Off       60ns  

Trigger Source   Slope   Level 
         Ch 2   Rising  +219mV 

Time Time Ref  Main S/div  Delay 
Main  Center     5.00us/   400ns 

Acquisition Realtime  Vectors  Infinite Persistence 
   Normal      Off       On             Off
