nesl/ragobots/robot/hw/body/docs/IR_Power/Cliff_High_Power_TX/PRINT_08.CSV

x-axis | 2
second | Volt
-214.0000E-06 | +30.6249857E-03
-213.5000E-06 | +30.6249857E-03
-213.0000E-06 | +30.6249857E-03
-212.5000E-06 | +46.2499857E-03
-212.0000E-06 | +30.6249857E-03
-211.5000E-06 | +30.6249857E-03
-211.0000E-06 | +14.9999857E-03
-210.5000E-06 | +30.6249857E-03
-210.0000E-06 | +30.6249857E-03
-209.5000E-06 | +46.2499857E-03
-209.0000E-06 | +30.6249857E-03
-208.5000E-06 | +46.2499857E-03
-208.0000E-06 | +30.6249857E-03
-207.5000E-06 | +30.6249857E-03
-207.0000E-06 | +46.2499857E-03
-206.5000E-06 | +30.6249857E-03
-206.0000E-06 | +30.6249857E-03
-205.5000E-06 | +46.2499857E-03
-205.0000E-06 | +30.6249857E-03
-204.5000E-06 | +30.6249857E-03
-204.0000E-06 | +30.6249857E-03
-203.5000E-06 | +30.6249857E-03
-203.0000E-06 | +46.2499857E-03
-202.5000E-06 | +14.9999857E-03
-202.0000E-06 | +14.9999857E-03
-201.5000E-06 | +30.6249857E-03
-201.0000E-06 | +14.9999857E-03
-200.5000E-06 | +30.6249857E-03
-200.0000E-06 | +14.9999857E-03
-199.5000E-06 | +30.6249857E-03
-199.0000E-06 | +30.6249857E-03
-198.5000E-06 | +30.6249857E-03
-198.0000E-06 | +30.6249857E-03
-197.5000E-06 | +46.2499857E-03
-197.0000E-06 | +30.6249857E-03
-196.5000E-06 | +14.9999857E-03
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
