nesl/ragobots/robot/hw/body/docs/IR_Power/Cliff_Low_Power_TX/PRINT_10.CSV

x-axis | 2
second | Volt
-24.60000E-06 | +237.00000346E-03
-24.57500E-06 | +243.25000355E-03
-24.55000E-06 | +237.00000346E-03
-24.52500E-06 | +243.25000355E-03
-24.50000E-06 | +237.00000346E-03
-24.47500E-06 | +243.25000355E-03
-24.45000E-06 | +243.25000355E-03
-24.42500E-06 | +237.00000346E-03
-24.40000E-06 | +237.00000346E-03
-24.37500E-06 | +243.25000355E-03
-24.35000E-06 | +237.00000346E-03
-24.32500E-06 | +243.25000355E-03
-24.30000E-06 | +237.00000346E-03
-24.27500E-06 | +243.25000355E-03
-24.25000E-06 | +237.00000346E-03
-24.22500E-06 | +243.25000355E-03
-24.20000E-06 | +249.50000364E-03
-24.17500E-06 | +243.25000355E-03
-24.15000E-06 | +243.25000355E-03
-24.12500E-06 | +243.25000355E-03
-24.10000E-06 | +243.25000355E-03
-24.07500E-06 | +249.50000364E-03
-24.05000E-06 | +243.25000355E-03
-24.02500E-06 | +237.00000346E-03
-24.00000E-06 | +243.25000355E-03
-23.97500E-06 | +249.50000364E-03
-23.95000E-06 | +243.25000355E-03
-23.92500E-06 | +237.00000346E-03
-23.90000E-06 | +237.00000346E-03
-23.87500E-06 | +249.50000364E-03
-23.85000E-06 | +243.25000355E-03
-23.82500E-06 | +237.00000346E-03
-23.80000E-06 | +255.75000374E-03
-23.77500E-06 | +243.25000355E-03
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
