nesl/ragobots/robot/hw/body/docs/IR_Power/Obstacle_High_Power_TX/PRINT_15.CSV

x-axis | 2
second | Volt
-83.80000E-06 | +1.35937500000E+00
-83.75000E-06 | +1.35937500000E+00
-83.70000E-06 | +1.35937500000E+00
-83.65000E-06 | +1.35937500000E+00
-83.60000E-06 | +1.35937500000E+00
-83.55000E-06 | +1.37500000000E+00
-83.50000E-06 | +1.34375000000E+00
-83.45000E-06 | +1.37500000000E+00
-83.40000E-06 | +1.37500000000E+00
-83.35000E-06 | +1.37500000000E+00
-83.30000E-06 | +1.39062500000E+00
-83.25000E-06 | +1.37500000000E+00
-83.20000E-06 | +1.42187500000E+00
-83.15000E-06 | +1.40625000000E+00
-83.10000E-06 | +1.42187500000E+00
-83.05000E-06 | +1.39062500000E+00
-83.00000E-06 | +1.43750000000E+00
-82.95000E-06 | +1.40625000000E+00
-82.90000E-06 | +1.40625000000E+00
-82.85000E-06 | +1.40625000000E+00
-82.80000E-06 | +1.42187500000E+00
-82.75000E-06 | +1.42187500000E+00
-82.70000E-06 | +1.40625000000E+00
-82.65000E-06 | +1.37500000000E+00
-82.60000E-06 | +1.37500000000E+00
-82.55000E-06 | +1.35937500000E+00
-82.50000E-06 | +1.31250000000E+00
-82.45000E-06 | +1.26562500000E+00
-82.40000E-06 | +968.75000000E-03
-82.35000E-06 | +1.12500000000E+00
-82.30000E-06 | +1.18750000000E+00
-82.25000E-06 | +1.12500000000E+00
-82.20000E-06 | +1.17187500000E+00
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
