nesl/ragobots/robot/hw/body/docs/IR_Power/Obstacle_Low_Power_TX/PRINT_13.CSV

x-axis | 2
second | Volt
-83.80000E-06 | +343.75000512E-03
-83.75000E-06 | +343.75000512E-03
-83.70000E-06 | +356.25000531E-03
-83.65000E-06 | +350.00000522E-03
-83.60000E-06 | +343.75000512E-03
-83.55000E-06 | +350.00000522E-03
-83.50000E-06 | +350.00000522E-03
-83.45000E-06 | +350.00000522E-03
-83.40000E-06 | +350.00000522E-03
-83.35000E-06 | +350.00000522E-03
-83.30000E-06 | +356.25000531E-03
-83.25000E-06 | +350.00000522E-03
-83.20000E-06 | +356.25000531E-03
-83.15000E-06 | +356.25000531E-03
-83.10000E-06 | +356.25000531E-03
-83.05000E-06 | +356.25000531E-03
-83.00000E-06 | +356.25000531E-03
-82.95000E-06 | +356.25000531E-03
-82.90000E-06 | +362.50000540E-03
-82.85000E-06 | +356.25000531E-03
-82.80000E-06 | +362.50000540E-03
-82.75000E-06 | +356.25000531E-03
-82.70000E-06 | +356.25000531E-03
-82.65000E-06 | +368.75000549E-03
-82.60000E-06 | +350.00000522E-03
-82.55000E-06 | +343.75000512E-03
-82.50000E-06 | +356.25000531E-03
-82.45000E-06 | +387.50000577E-03
-82.40000E-06 | +362.50000540E-03
-82.35000E-06 | +356.25000531E-03
-82.30000E-06 | +362.50000540E-03
-82.25000E-06 | +362.50000540E-03
-82.20000E-06 | +356.25000531E-03
-82.15000E-06 | +356.25000531E-03
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
