nesl/ragobots/robot/hw/body/docs/IR_Power/Cliff_High_Power_TX/PRINT_08.TIF

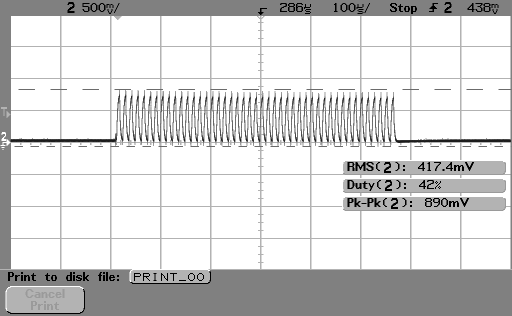
robot/hw/body/docs/IR_Power/Cliff_High_Power_TX/PRINT_08.TIF
