nesl/ragobots/robot/hw/body/docs/IR_Power/Cliff_Low_Power_TX/PRINT_09.TIF

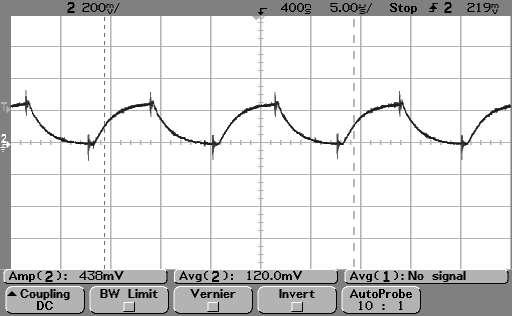
robot/hw/body/docs/IR_Power/Cliff_Low_Power_TX/PRINT_09.TIF
