nesl/ragobots/robot/hw/body/docs/IR_Power/Obstacle_High_Power_TX/PRINT_14.TIF

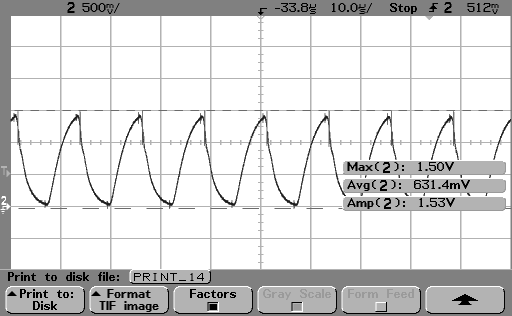
robot/hw/body/docs/IR_Power/Obstacle_High_Power_TX/PRINT_14.TIF
