nesl/ragobots/robot/hw/body/docs/IR_Power/Obstacle_Low_Power_TX/PRINT_12.TIF

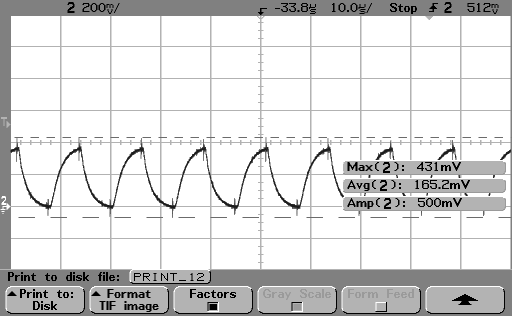
robot/hw/body/docs/IR_Power/Obstacle_Low_Power_TX/PRINT_12.TIF
