nesl/ragobots/robot/sw/code/tinyos/apps/VerifyDualMotorController/README

README for VerifyDualMotorController
Author/Contact: parixit@ee.ucla.edu

Description:
This application verifies functionality of Dual motor controller.

Tools:

None

Known bugs/limitations:

None

See Also:
