nesl/ragobots/server/localization/Debug/localization/capture.jpeg

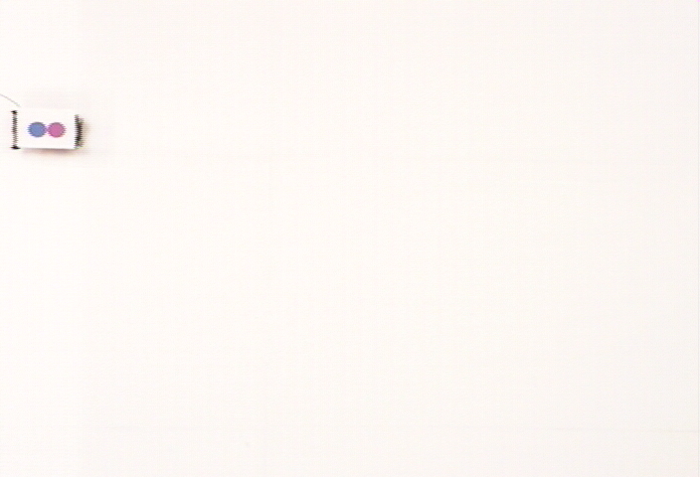
server/localization/Debug/localization/capture.jpeg
