nesl/ragobots/robot/hw/body/ragobot_body_C_SCH.pdf

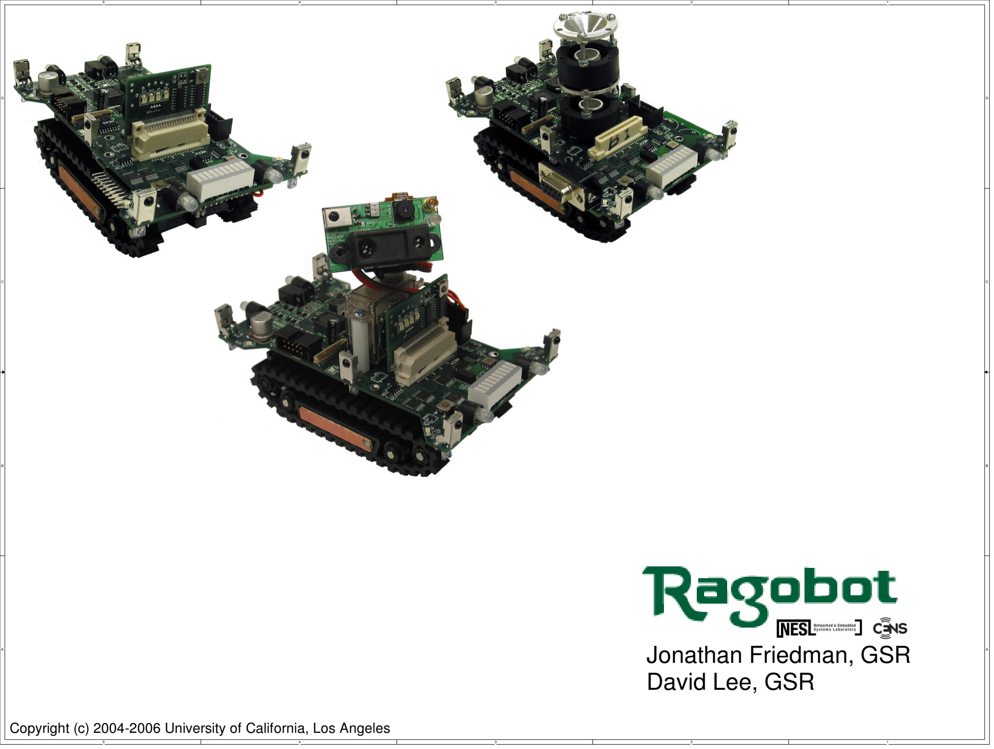
[picture p36: page 1]

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
# A A Jonathan Friedman, GSR David Lee, GSR

# Copyright (c) 2004-2006 University of California, Los Angeles

# AVCC_5 -> VCC_5 AGND -> DGND

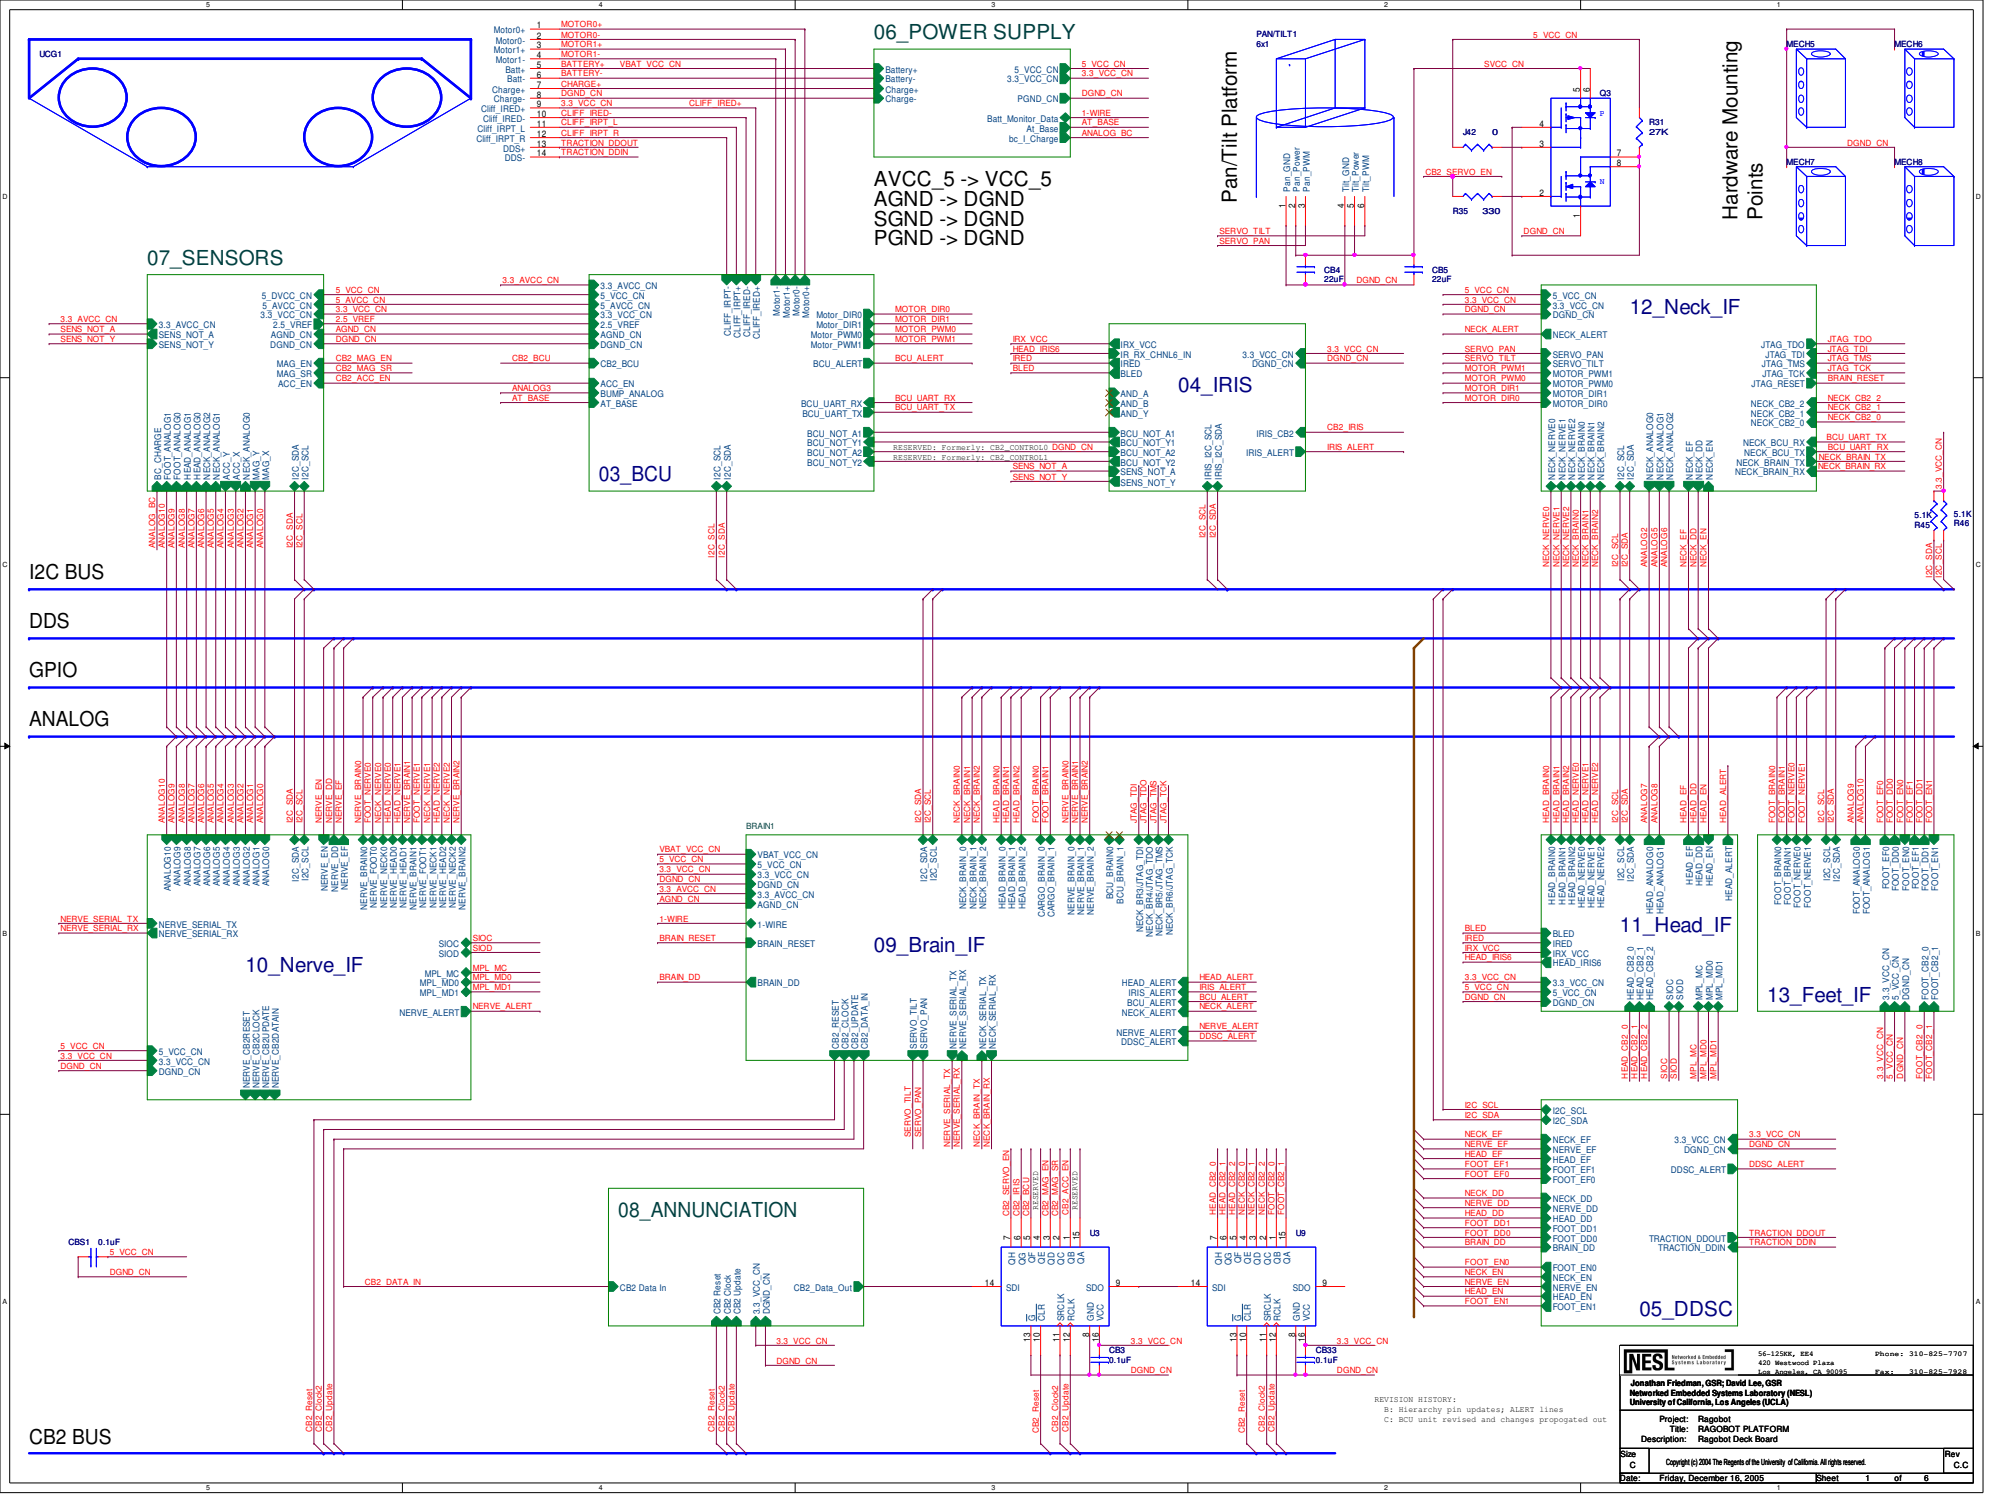
[picture p37: page 2]

Jonathan Friedman, GSR; David Lee, GSR
Networked Embedded Systems Laboratory (NESL)
University of California, Los Angeles (UCLA)

REVISION HISTORY:
B: Hierarchy pin updates; ALERT lines
C: BCU unit revised and changes propogated out

Copyright (c) 2004 The Regents of the University of California. All rights reserved.

## HEAD_IRIS6 SIOC

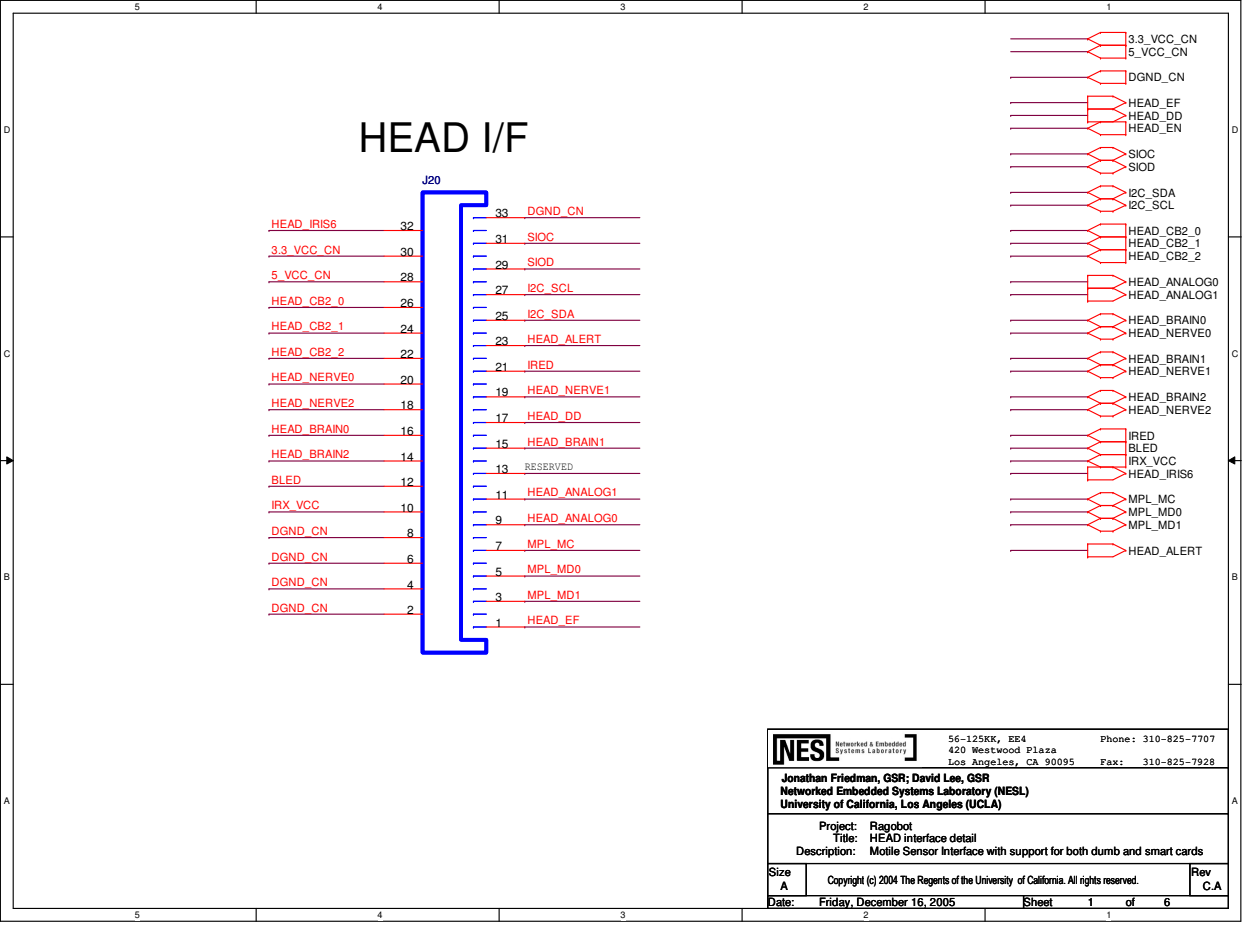
[picture p38: page 3]
I2C_SCL; I2C_SDA; 3.3_VCC_CN; 5_VCC_CN; HEAD_BRAIN2; SIOD; MPL_MC; MPL_MD0; MPL_MD1; IRED; HEAD_EF; HEAD_BRAIN1; DGND_CN; HEAD_NERVE0; HEAD_ALERT; HEAD_DD; HEAD_ANALOG0; HEAD_NERVE1; BLED; HEAD_ANALOG1; HEAD_NERVE2; IRX_VCC; HEAD_CB2_0; HEAD_CB2_2; HEAD_CB2_1; HEAD_BRAIN0; I2C_SDA I2C_SCL; HEAD_BRAIN0 HEAD_NERVE0; HEAD_BRAIN1 HEAD_NERVE1; HEAD_BRAIN2 HEAD_NERVE2; IRED BLED; MPL_MC MPL_MD0 MPL_MD1; HEAD_DD HEAD_EN; SIOC SIOD; IRX_VCC HEAD_IRIS6; Title:; Size; Project:; Rev; Phone: 310-825-7707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

420 Westwood Plaza
Los Angeles, CA 90095

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

Ragobot
HEAD interface detail
Motile Sensor Interface with support for both dumb and smart cards

# DDSC

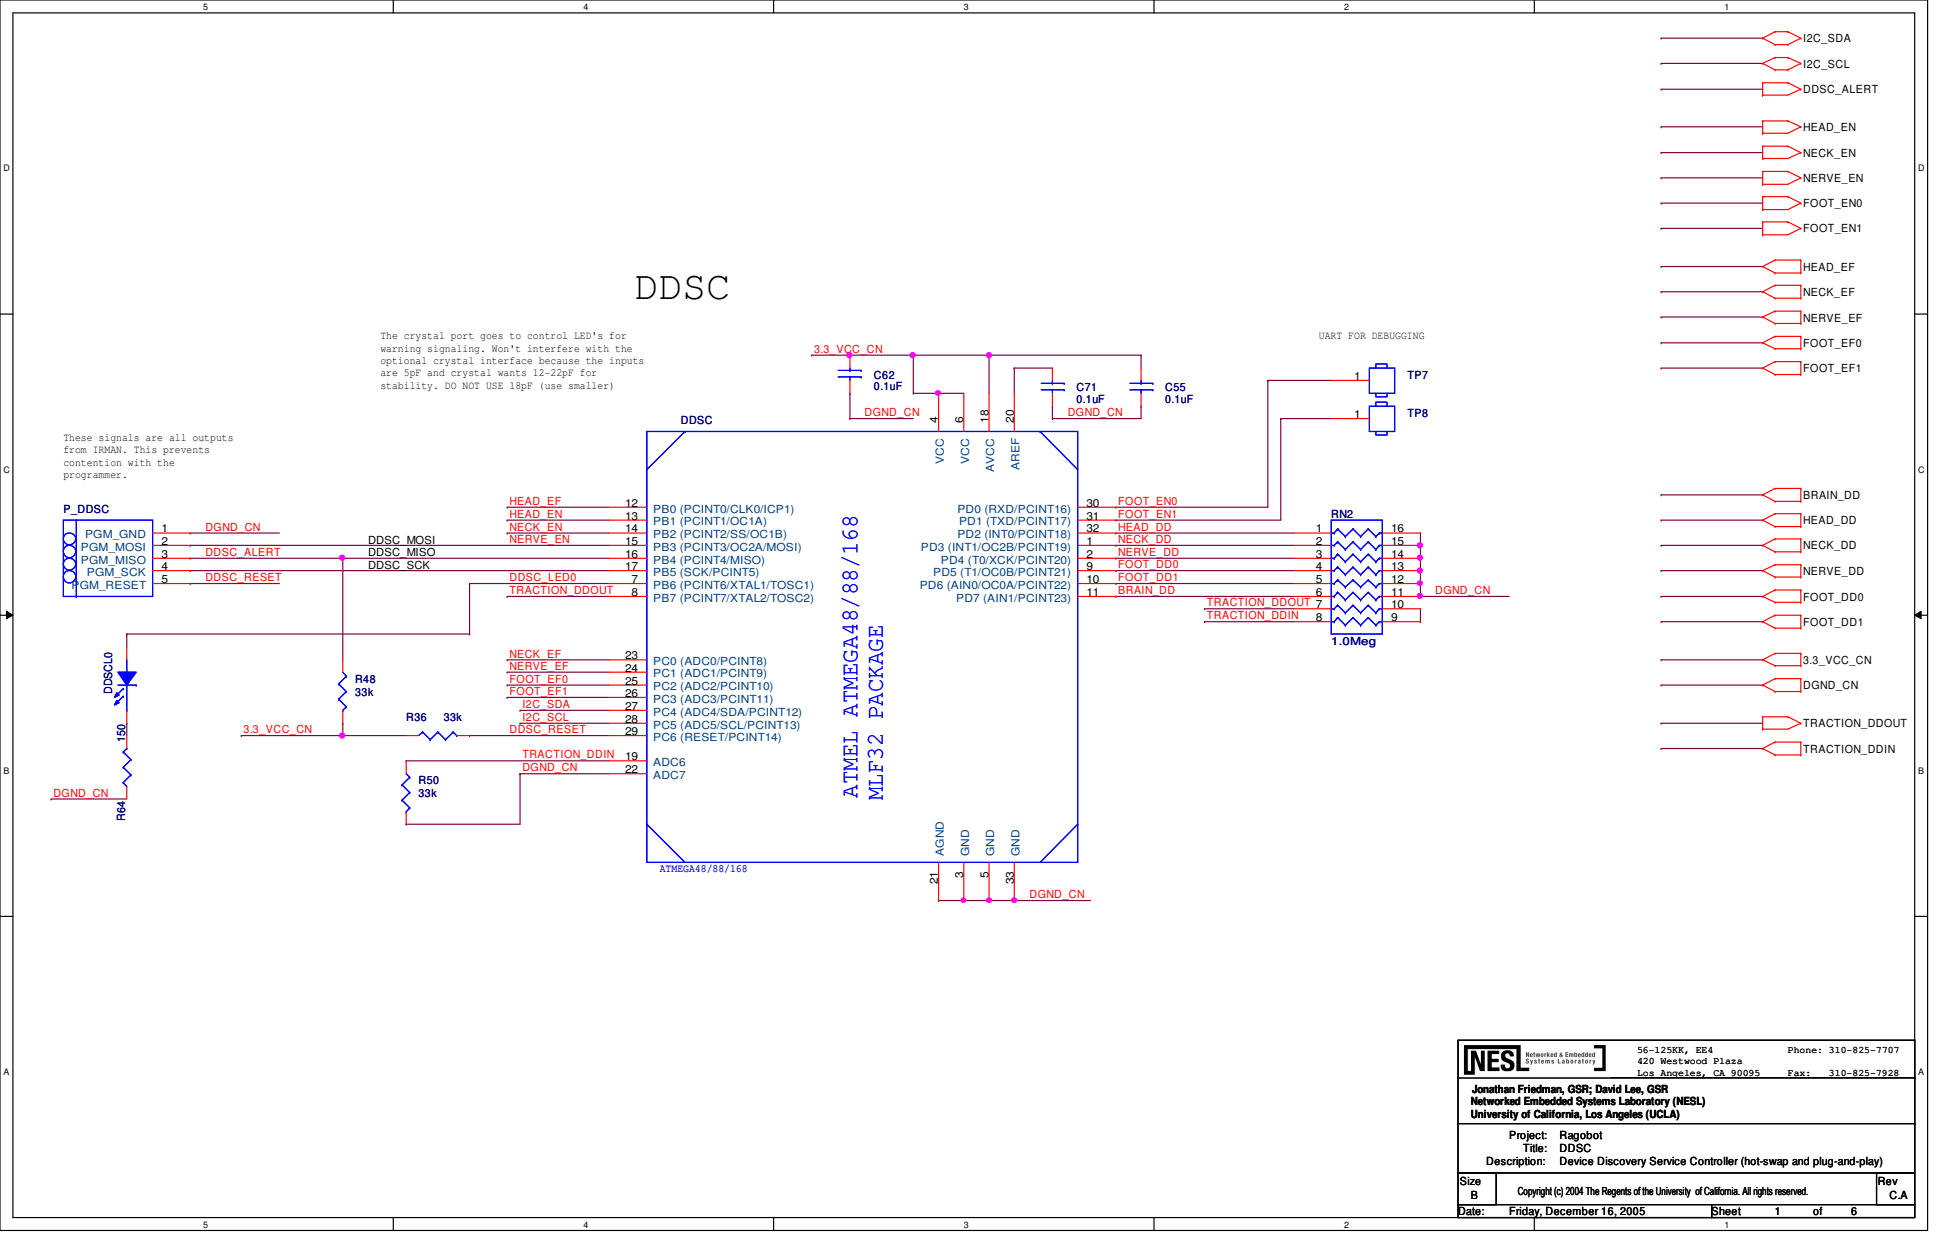
[picture p39: page 4]

The crystal port goes to control LED's for
warning signaling. Won't interfere with the
optional crystal interface because the inputs
are 5pF and crystal wants 12-22pF for
stability. DO NOT USE 18pF (use smaller)

These signals are all outputs
from IRMAN. This prevents
contention with the
programmer.

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

Ragobot
DDSC
Device Discovery Service Controller (hot-swap and plug-and-play)

Copyright (c) 2004 The Regents of the University of California. All rights reserved.

## SIOC

## SIOD

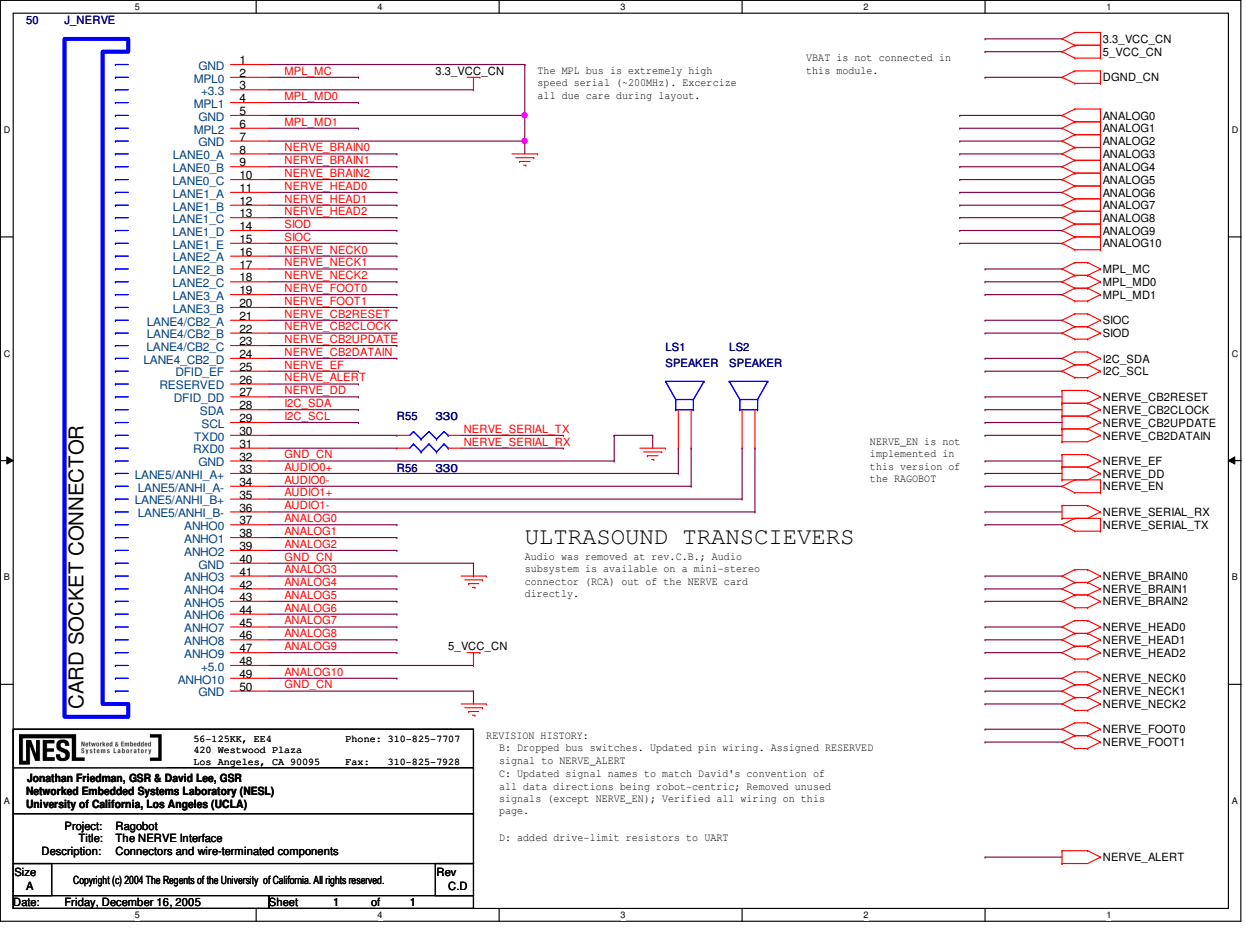
[picture p40: page 5]
AUDIO0+ AUDIO0- AUDIO1+ AUDIO1-; NERVE_DD; GND_CN; I2C_SDA I2C_SCL; NERVE_EF; NERVE_CB2DATAIN; NERVE_CB2UPDATE; NERVE_CB2CLOCK; NERVE_CB2RESET; NERVE_FOOT1; NERVE_FOOT0; NERVE_NECK2; NERVE_NECK1; NERVE_NECK0; NERVE_HEAD2; NERVE_HEAD1; NERVE_HEAD0; NERVE_BRAIN2; NERVE_BRAIN1; NERVE_BRAIN0; ANALOG3; ANALOG2; ANALOG4 ANALOG5 ANALOG6 ANALOG7 ANALOG8 ANALOG9; ANALOG1; ANALOG0; ANALOG10; MPL_MC; MPL_MD0; MPL_MD1; NERVE_ALERT; NERVE_SERIAL_TX NERVE_SERIAL_RX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

VBAT is not connected in

speed serial (~200MHz). Excercize
all due care during layout.

CARD SOCKET CONNECTOR

NERVE_EN is not
implemented in
this version of
the RAGOBOT

Audio was removed at rev.C.B.; Audio
subsystem is available on a mini-stereo
connector (RCA) out of the NERVE card
directly.

420 Westwood Plaza
Los Angeles, CA 90095

REVISION HISTORY:
B: Dropped bus switches. Updated pin wiring. Assigned RESERVED
signal to NERVE_ALERT
C: Updated signal names to match David's convention of
all data directions being robot-centric; Removed unused
signals (except NERVE_EN); Verified all wiring on this
page.

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

Ragobot
The NERVE Interface
Connectors and wire-terminated components

D: added drive-limit resistors to UART

## FOOT_CB2_0

## FOOT_BRAIN0

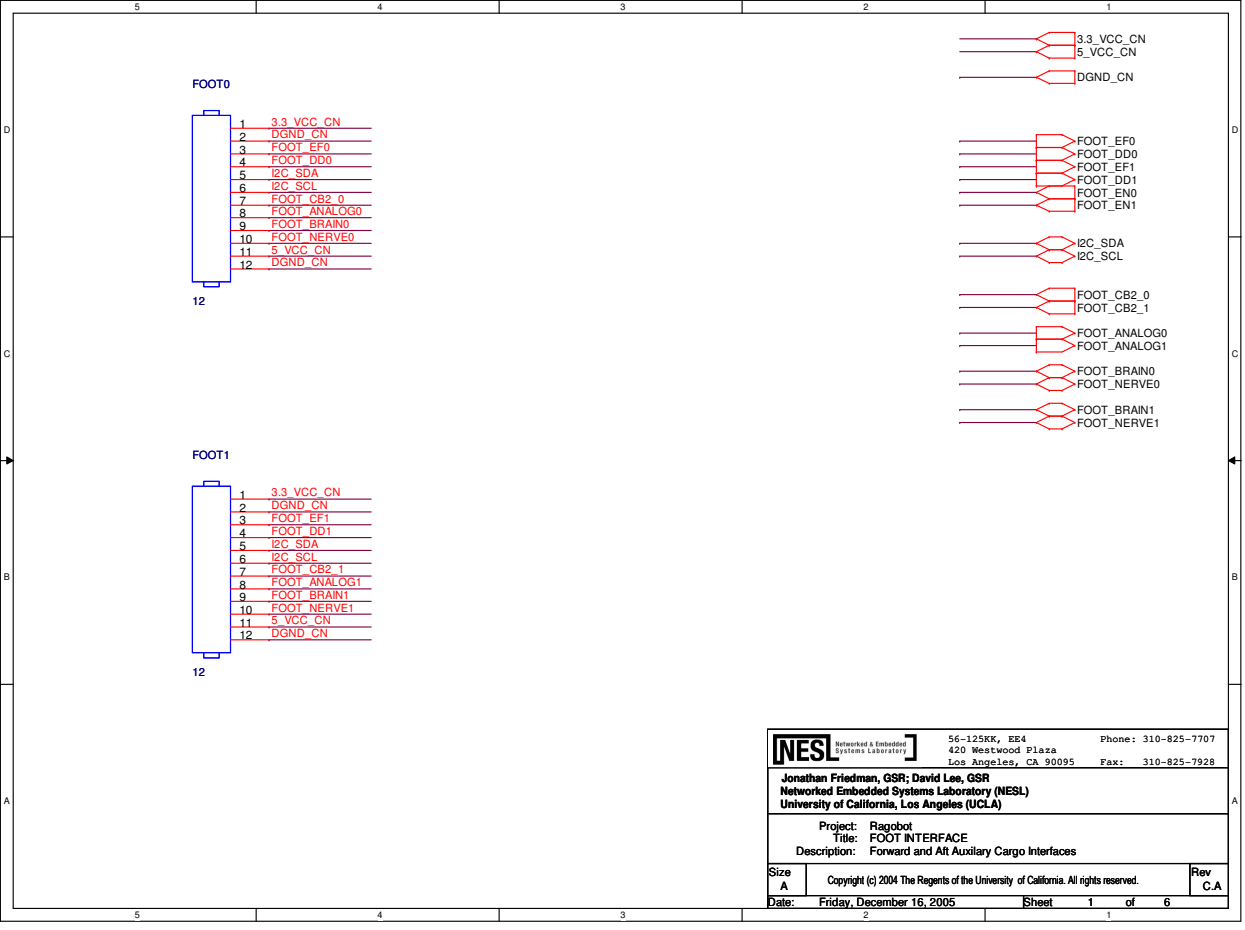
[picture p41: page 6]
FOOT_NERVE0; 3.3_VCC_CN DGND_CN FOOT_EF0 FOOT_DD0 I2C_SDA I2C_SCL; FOOT_ANALOG0; 5_VCC_CN DGND_CN; FOOT_CB2_1; FOOT_BRAIN1 FOOT_NERVE1; 3.3_VCC_CN DGND_CN FOOT_EF1 FOOT_DD1 I2C_SDA I2C_SCL; FOOT_ANALOG1; 5_VCC_CN; FOOT_CB2_0; FOOT_EF0 FOOT_DD0 FOOT_EF1 FOOT_DD1; I2C_SDA I2C_SCL; FOOT_BRAIN0 FOOT_NERVE0; FOOT_EN0 FOOT_EN1; Title:; Size; Project:; Rev; Phone: 310-825-7707; Fax:; Description:; Friday, December 16, 2005; FOOT1; FOOT0

420 Westwood Plaza
Los Angeles, CA 90095

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

Ragobot
FOOT INTERFACE
Forward and Aft Auxilary Cargo Interfaces

## DGND_CN

## DGND_CN

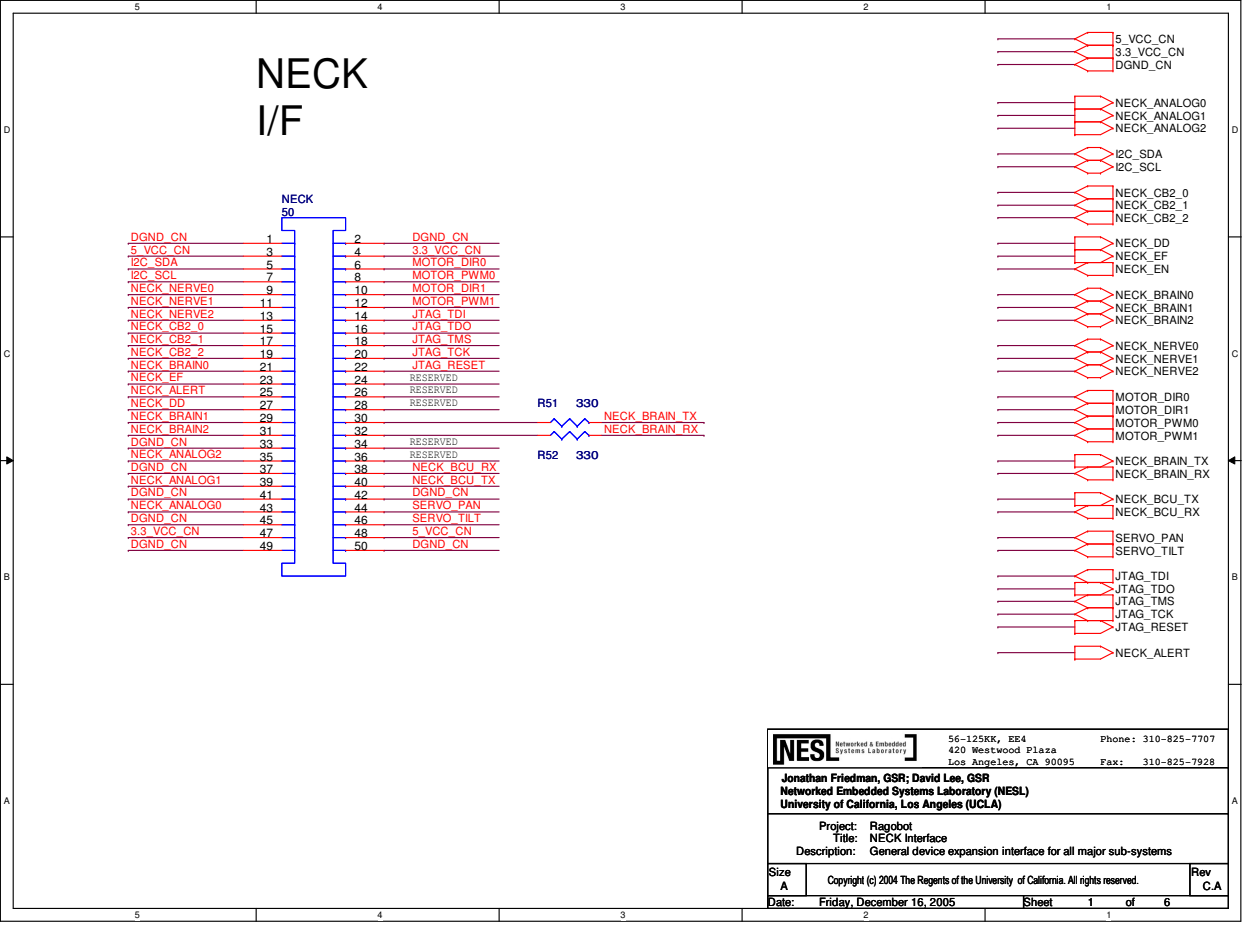
[picture p42: page 7]
MOTOR_DIR1; I2C_SDA I2C_SCL; SERVO_TILT; 5_VCC_CN; 3.3_VCC_CN; NECK_ANALOG1; NECK_ANALOG2; NECK_ANALOG0; DGND_CN; NECK_DD; NECK_EF; NECK_CB2_0 NECK_CB2_1 NECK_CB2_2 NECK_BRAIN0; NECK_BRAIN1 NECK_BRAIN2; NECK_NERVE0 NECK_NERVE1 NECK_NERVE2; NECK_BCU_TX; NECK_BCU_RX; MOTOR_PWM0; SERVO_PAN; NECK_ALERT; JTAG_TDI JTAG_TDO JTAG_TMS; JTAG_TCK JTAG_RESET; MOTOR_DIR0; MOTOR_PWM1; NECK_BRAIN_TX NECK_BRAIN_RX; JTAG_TDI; JTAG_TMS; JTAG_TDO; JTAG_TCK; NECK_ANALOG0 NECK_ANALOG1 NECK_ANALOG2; I2C_SCL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

420 Westwood Plaza
Los Angeles, CA 90095

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

Ragobot
NECK Interface
General device expansion interface for all major sub-systems

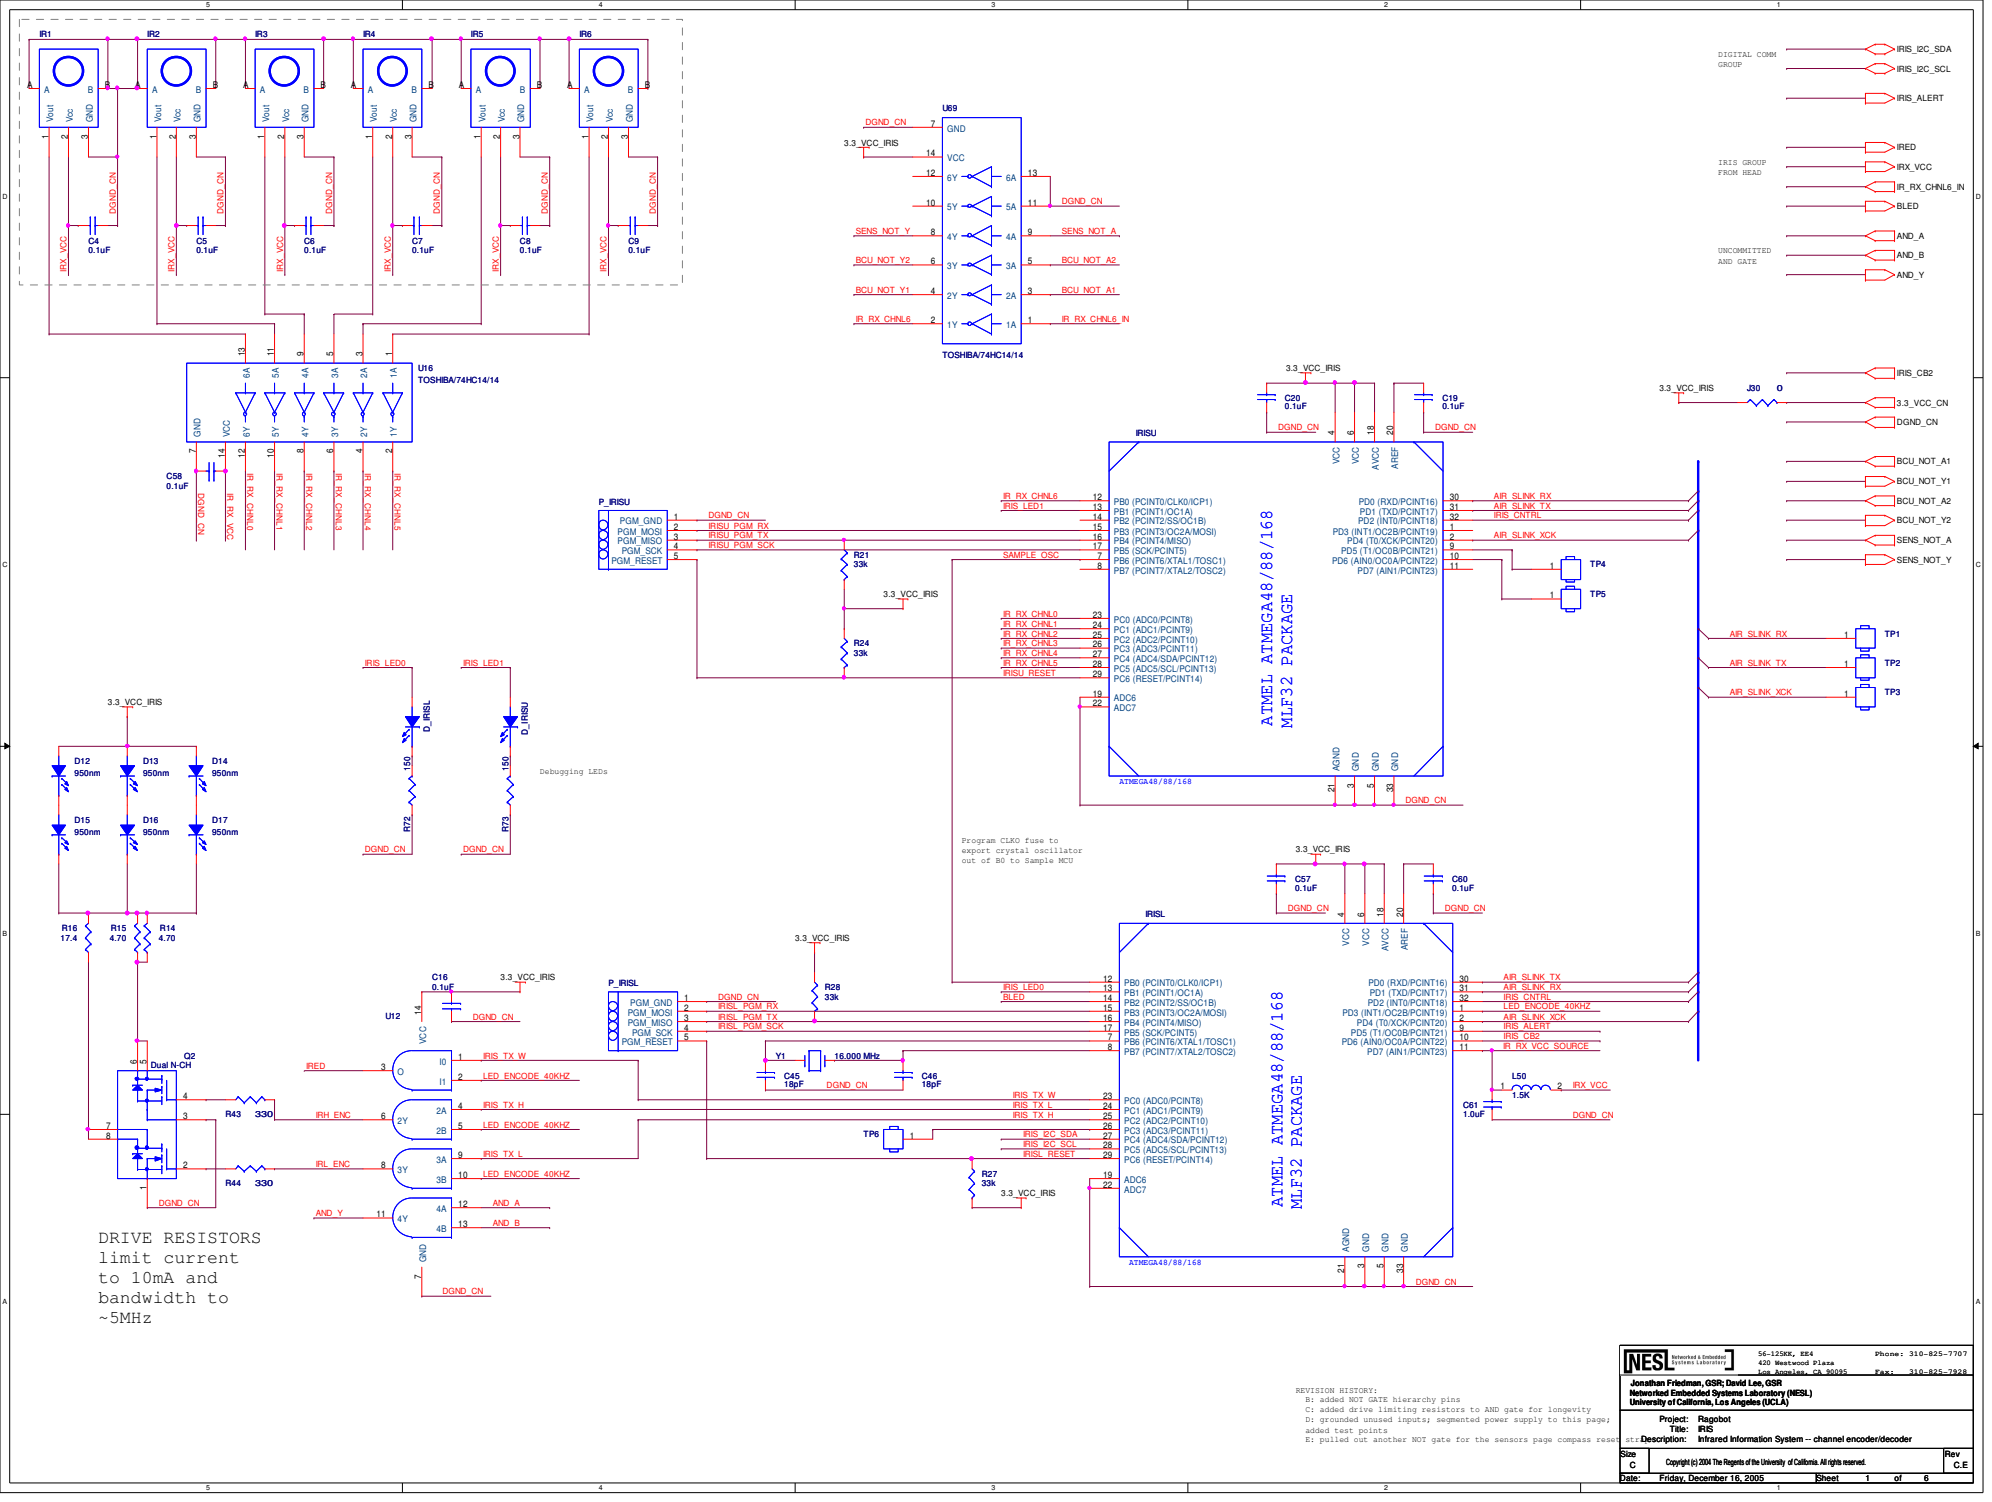
[picture p43: page 8]

Program CLKO fuse to
export crystal oscillator
out of B0 to Sample MCU

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

REVISION HISTORY:
B: added NOT GATE hierarchy pins
C: added drive limiting resistors to AND gate for longevity
D: grounded unused inputs; segmented power supply to this page;
added test points
E: pulled out another NOT gate for the sensors page compass reset strap

Ragobot
IRIS
Infrared Information System -- channel encoder/decoder

CB2

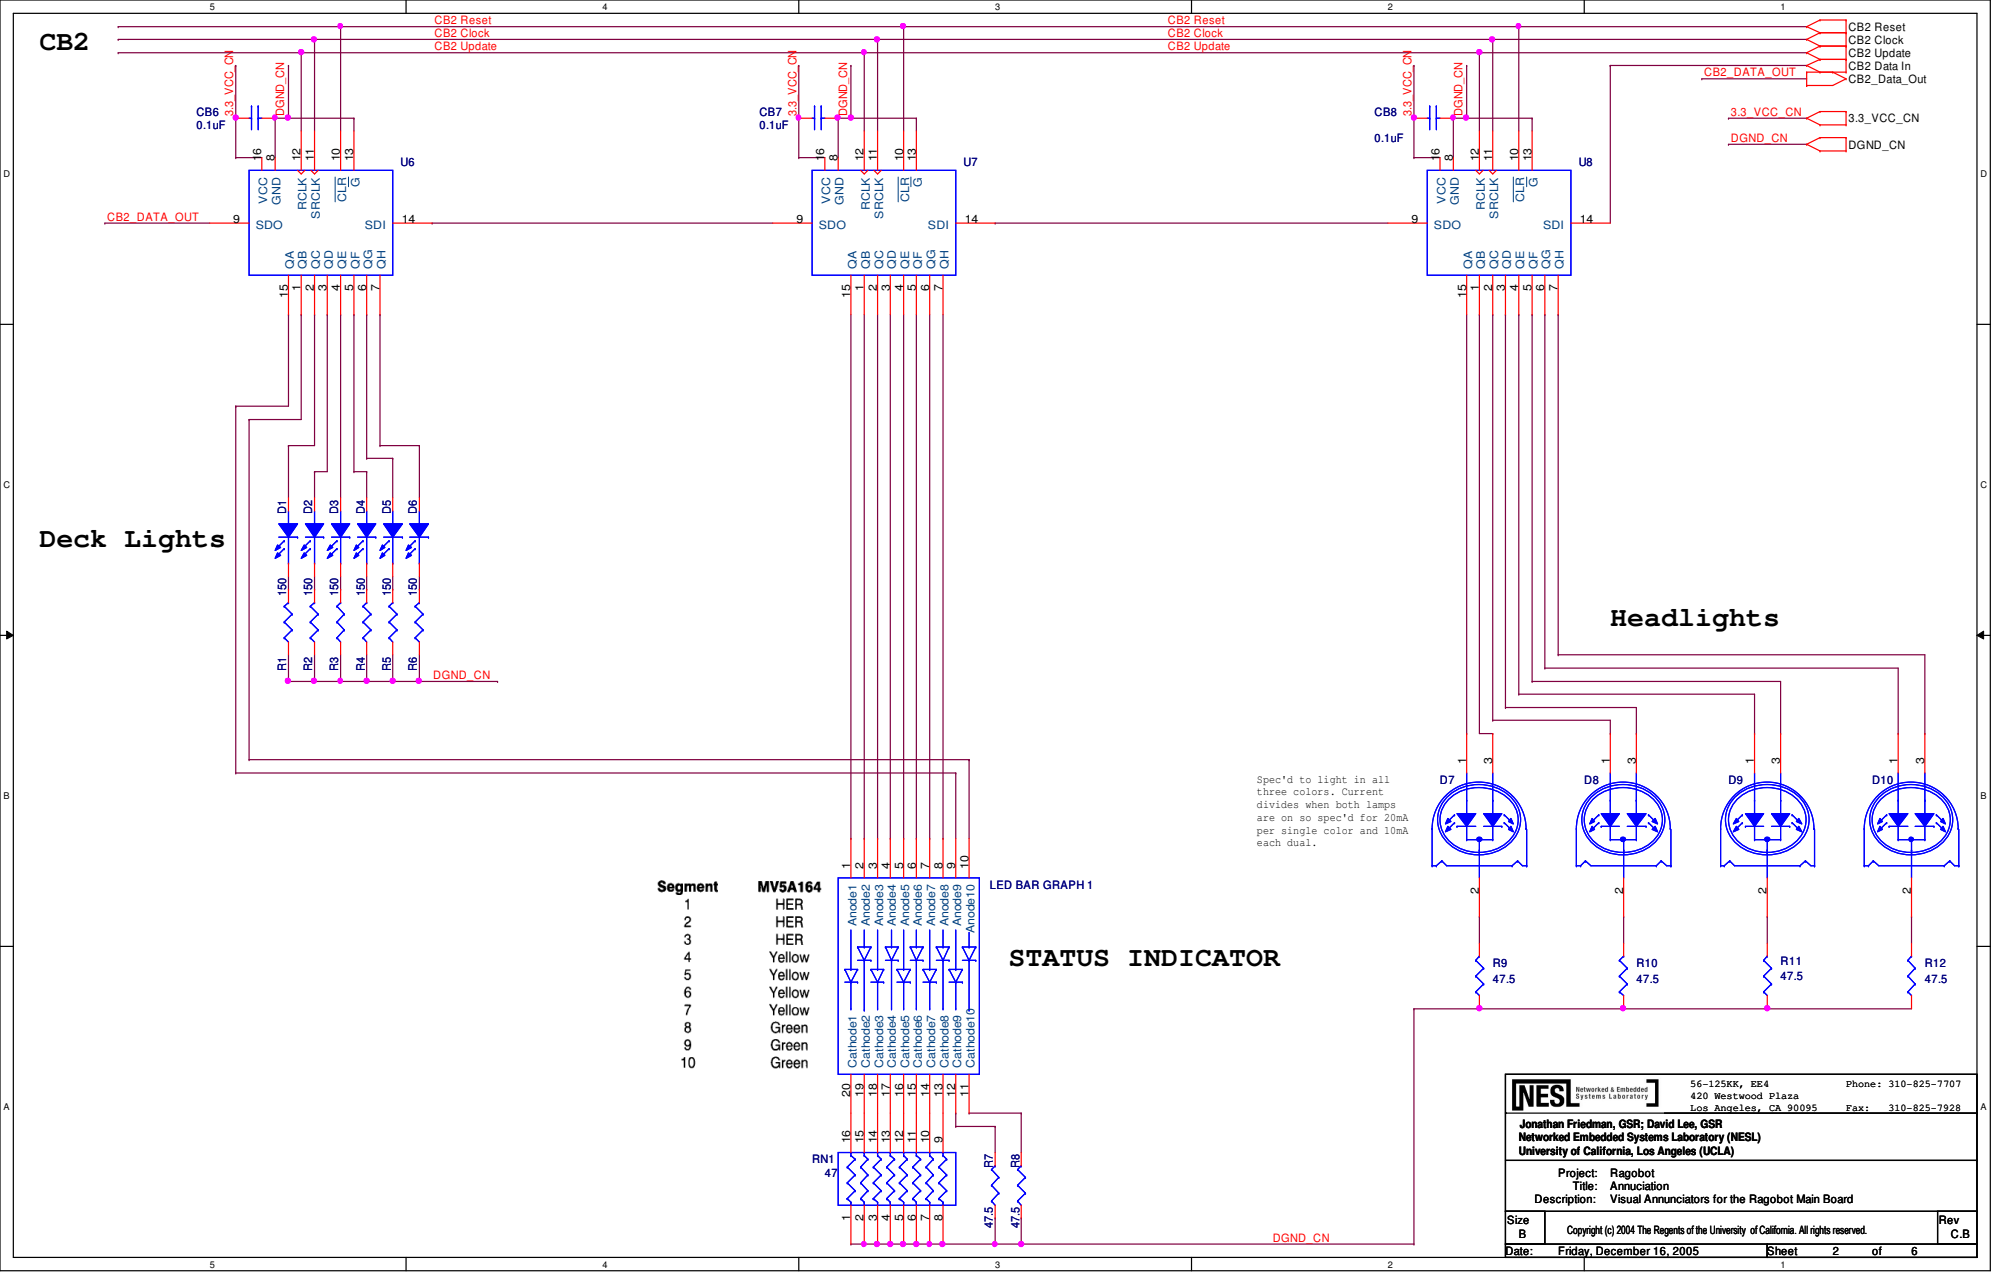
[picture p44: page 9]

Spec'd to light in all
three colors. Current
divides when both lamps
are on so spec'd for 20mA
per single color and 10mA
each dual.

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

Ragobot
Annuciation
Visual Annunciators for the Ragobot Main Board

Copyright (c) 2004 The Regents of the University of California. All rights reserved.

## DIGITAL COMMUNICATIONS

## POWER DISTRIBUTION

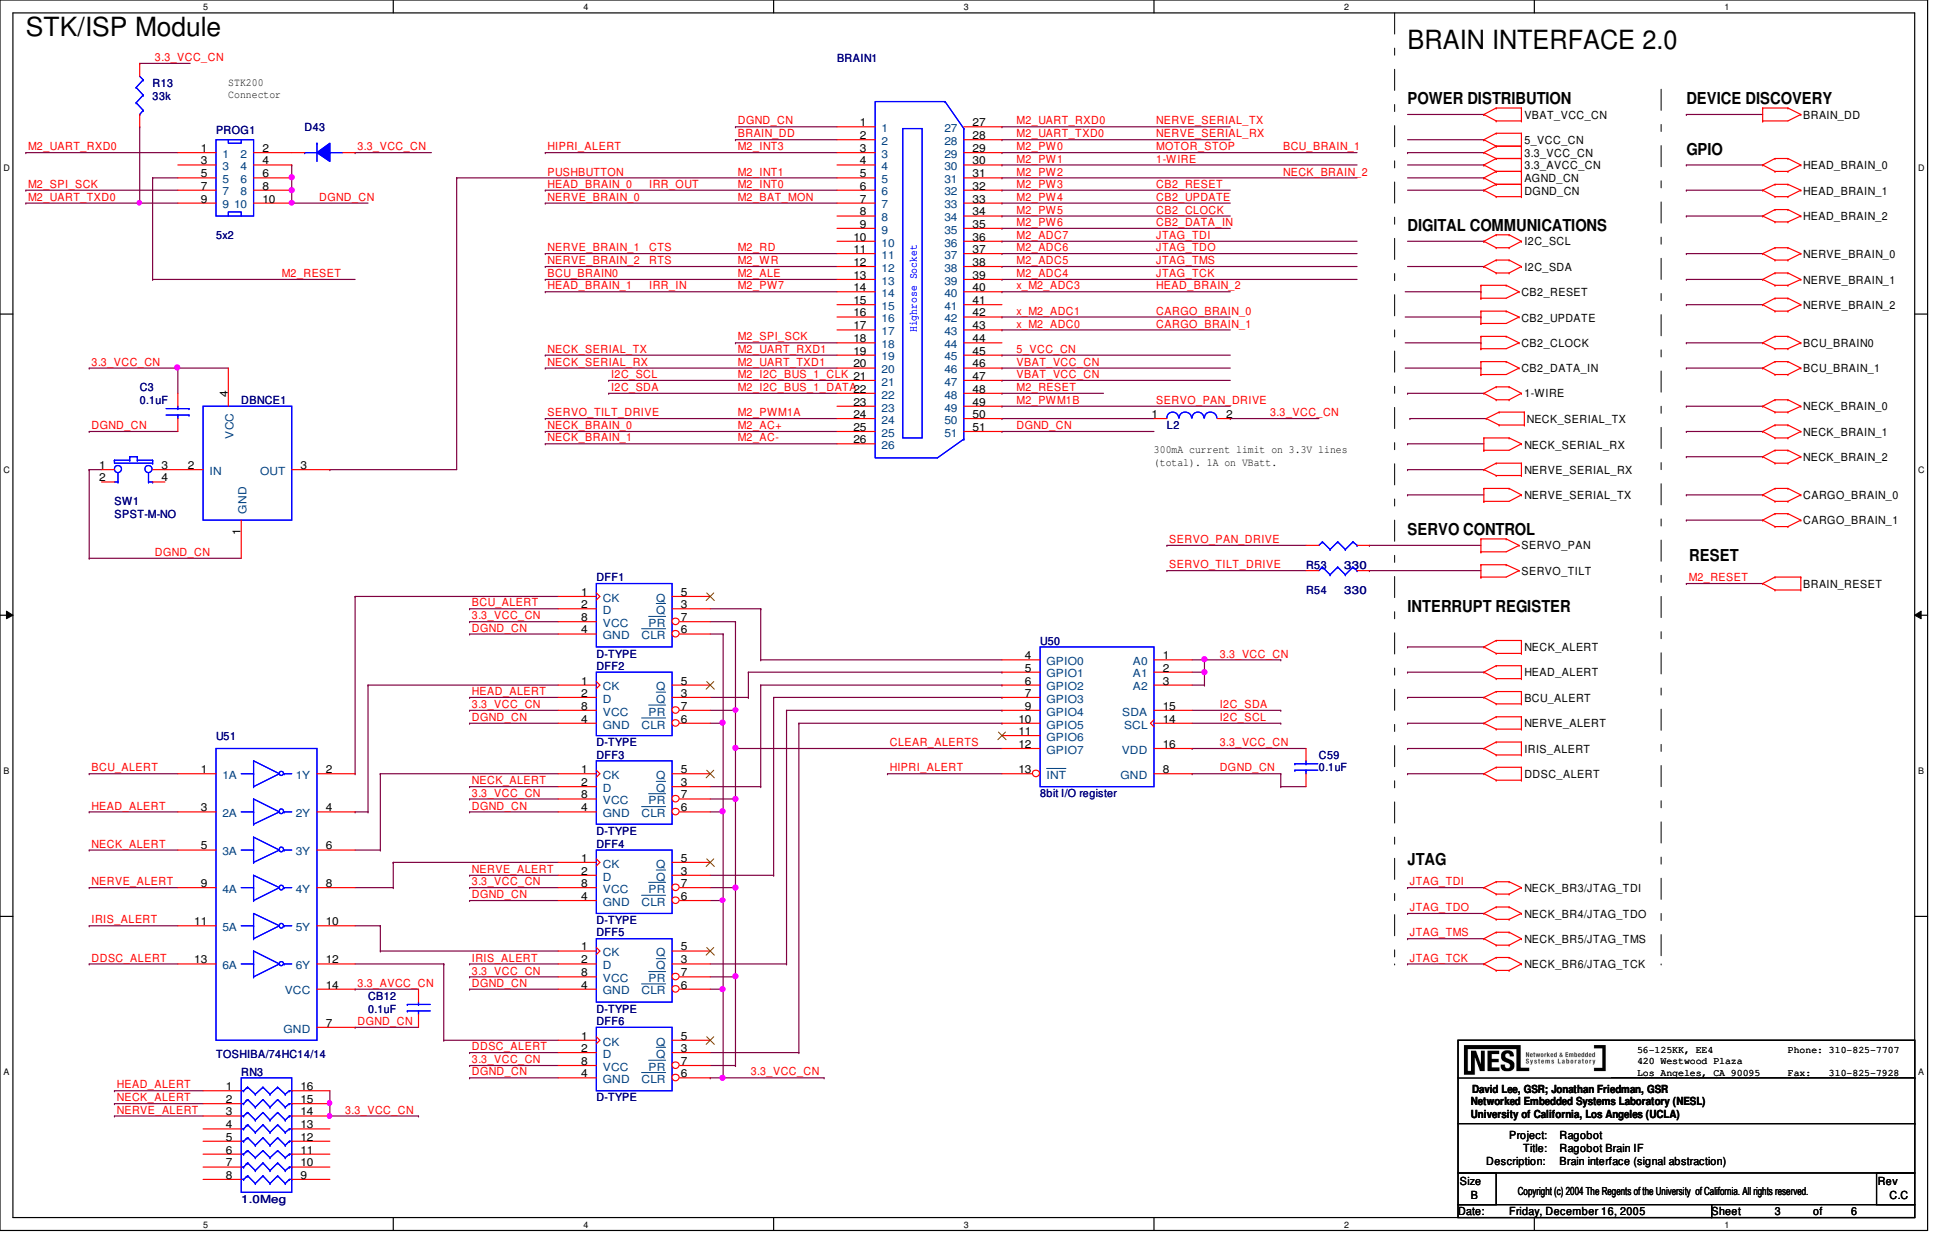
[picture p45: page 10]

300mA current limit on 3.3V lines
(total). 1A on VBatt.

David Lee, GSR; Jonathan Friedman, GSR
Networked Embedded Systems Laboratory (NESL)
University of California, Los Angeles (UCLA)

Ragobot
Ragobot Brain IF
Brain interface (signal abstraction)

Copyright (c) 2004 The Regents of the University of California. All rights reserved.

## NOTE: NEGATIVE LOGIC; REQ'D BY

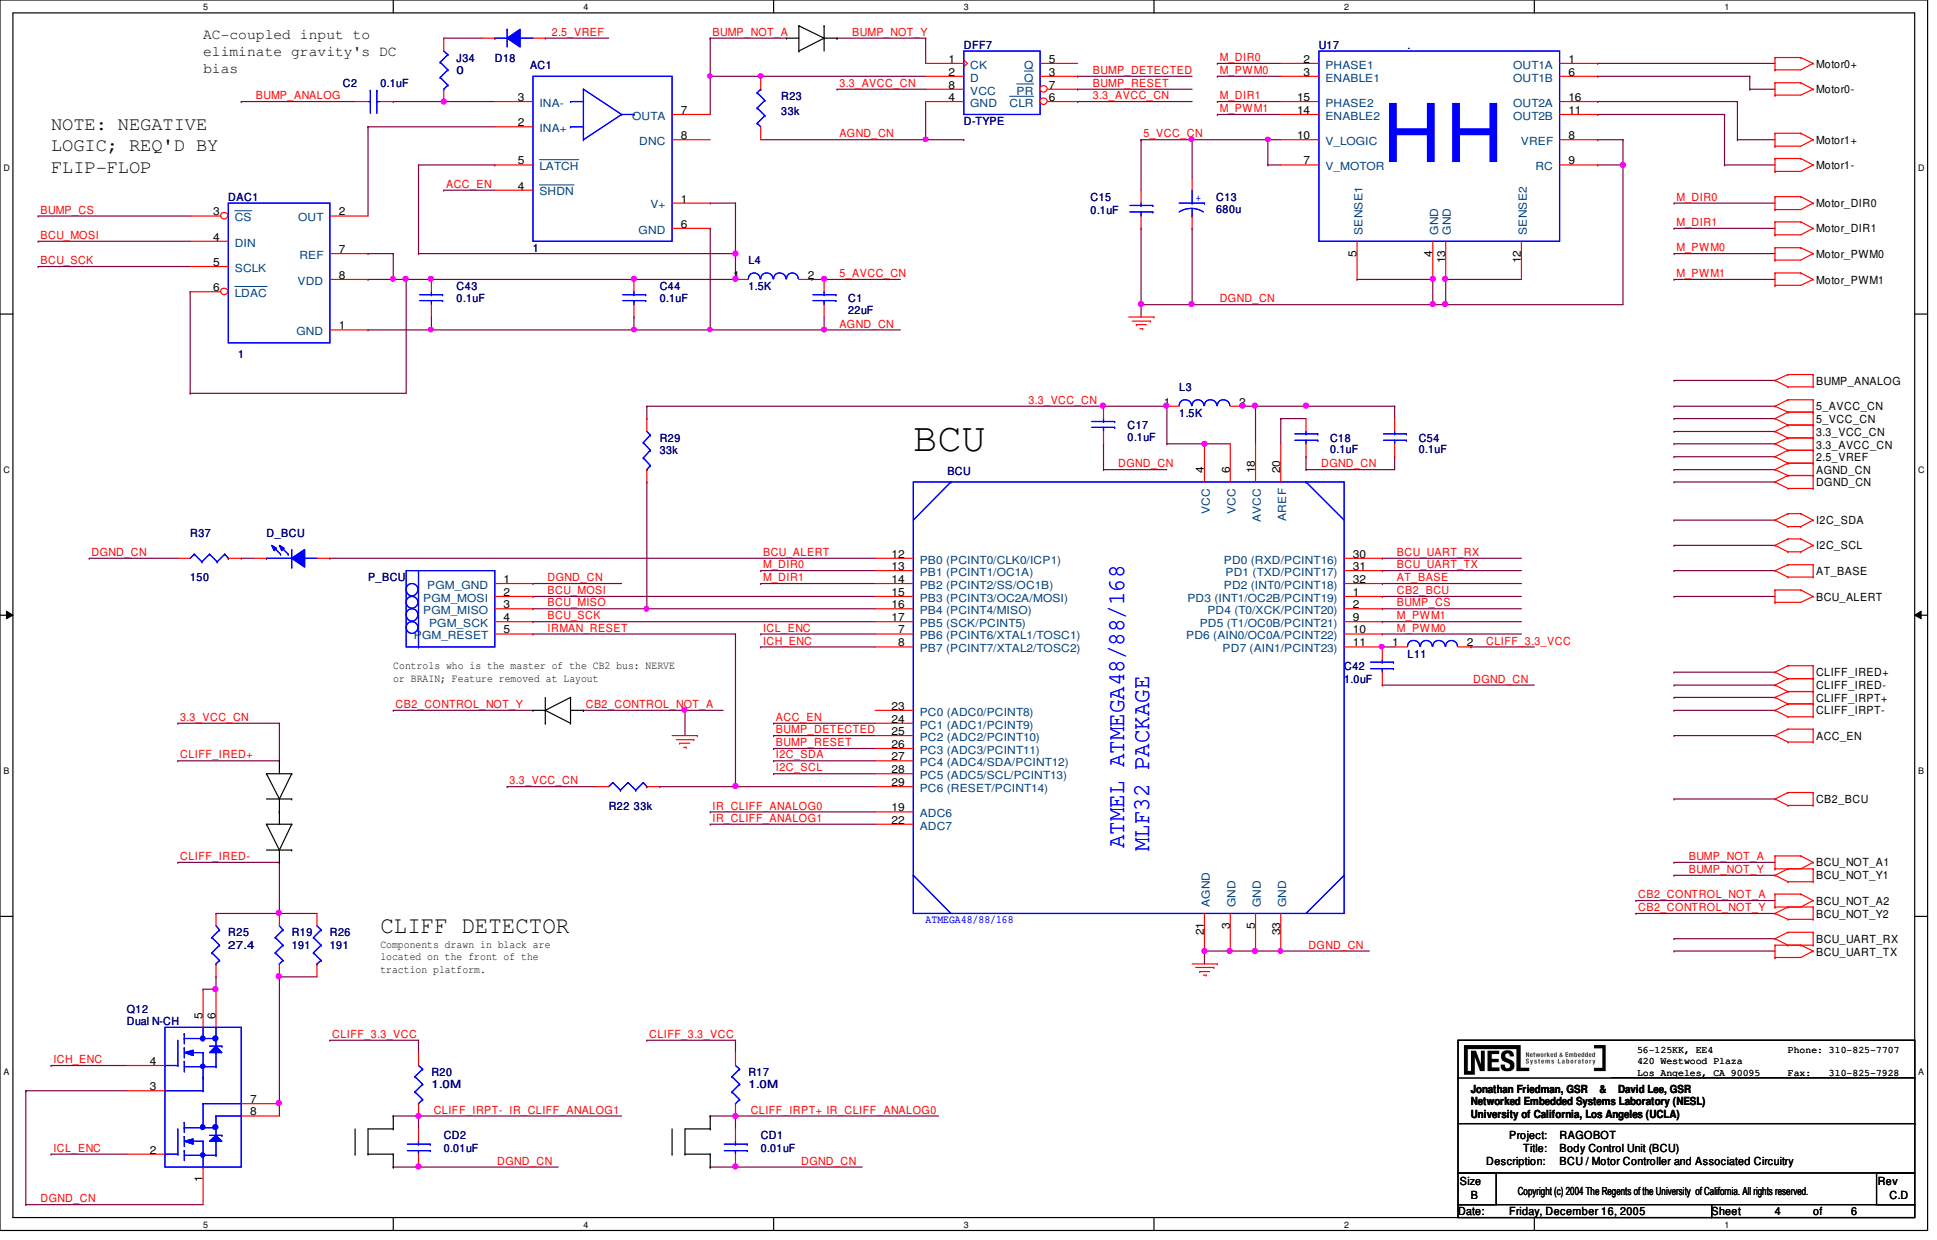
[picture p46: page 11]

AC-coupled input to
eliminate gravity's DC
bias

Controls who is the master of the CB2 bus: NERVE
or BRAIN; Feature removed at Layout

Components drawn in black are
located on the front of the
traction platform.

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

RAGOBOT
Body Control Unit (BCU)
BCU / Motor Controller and Associated Circuitry

Copyright (c) 2004 The Regents of the University of California. All rights reserved.

# PGND_CN At_Base bc_I_Charge 3.3_VCC_CN Charge+ Charge-

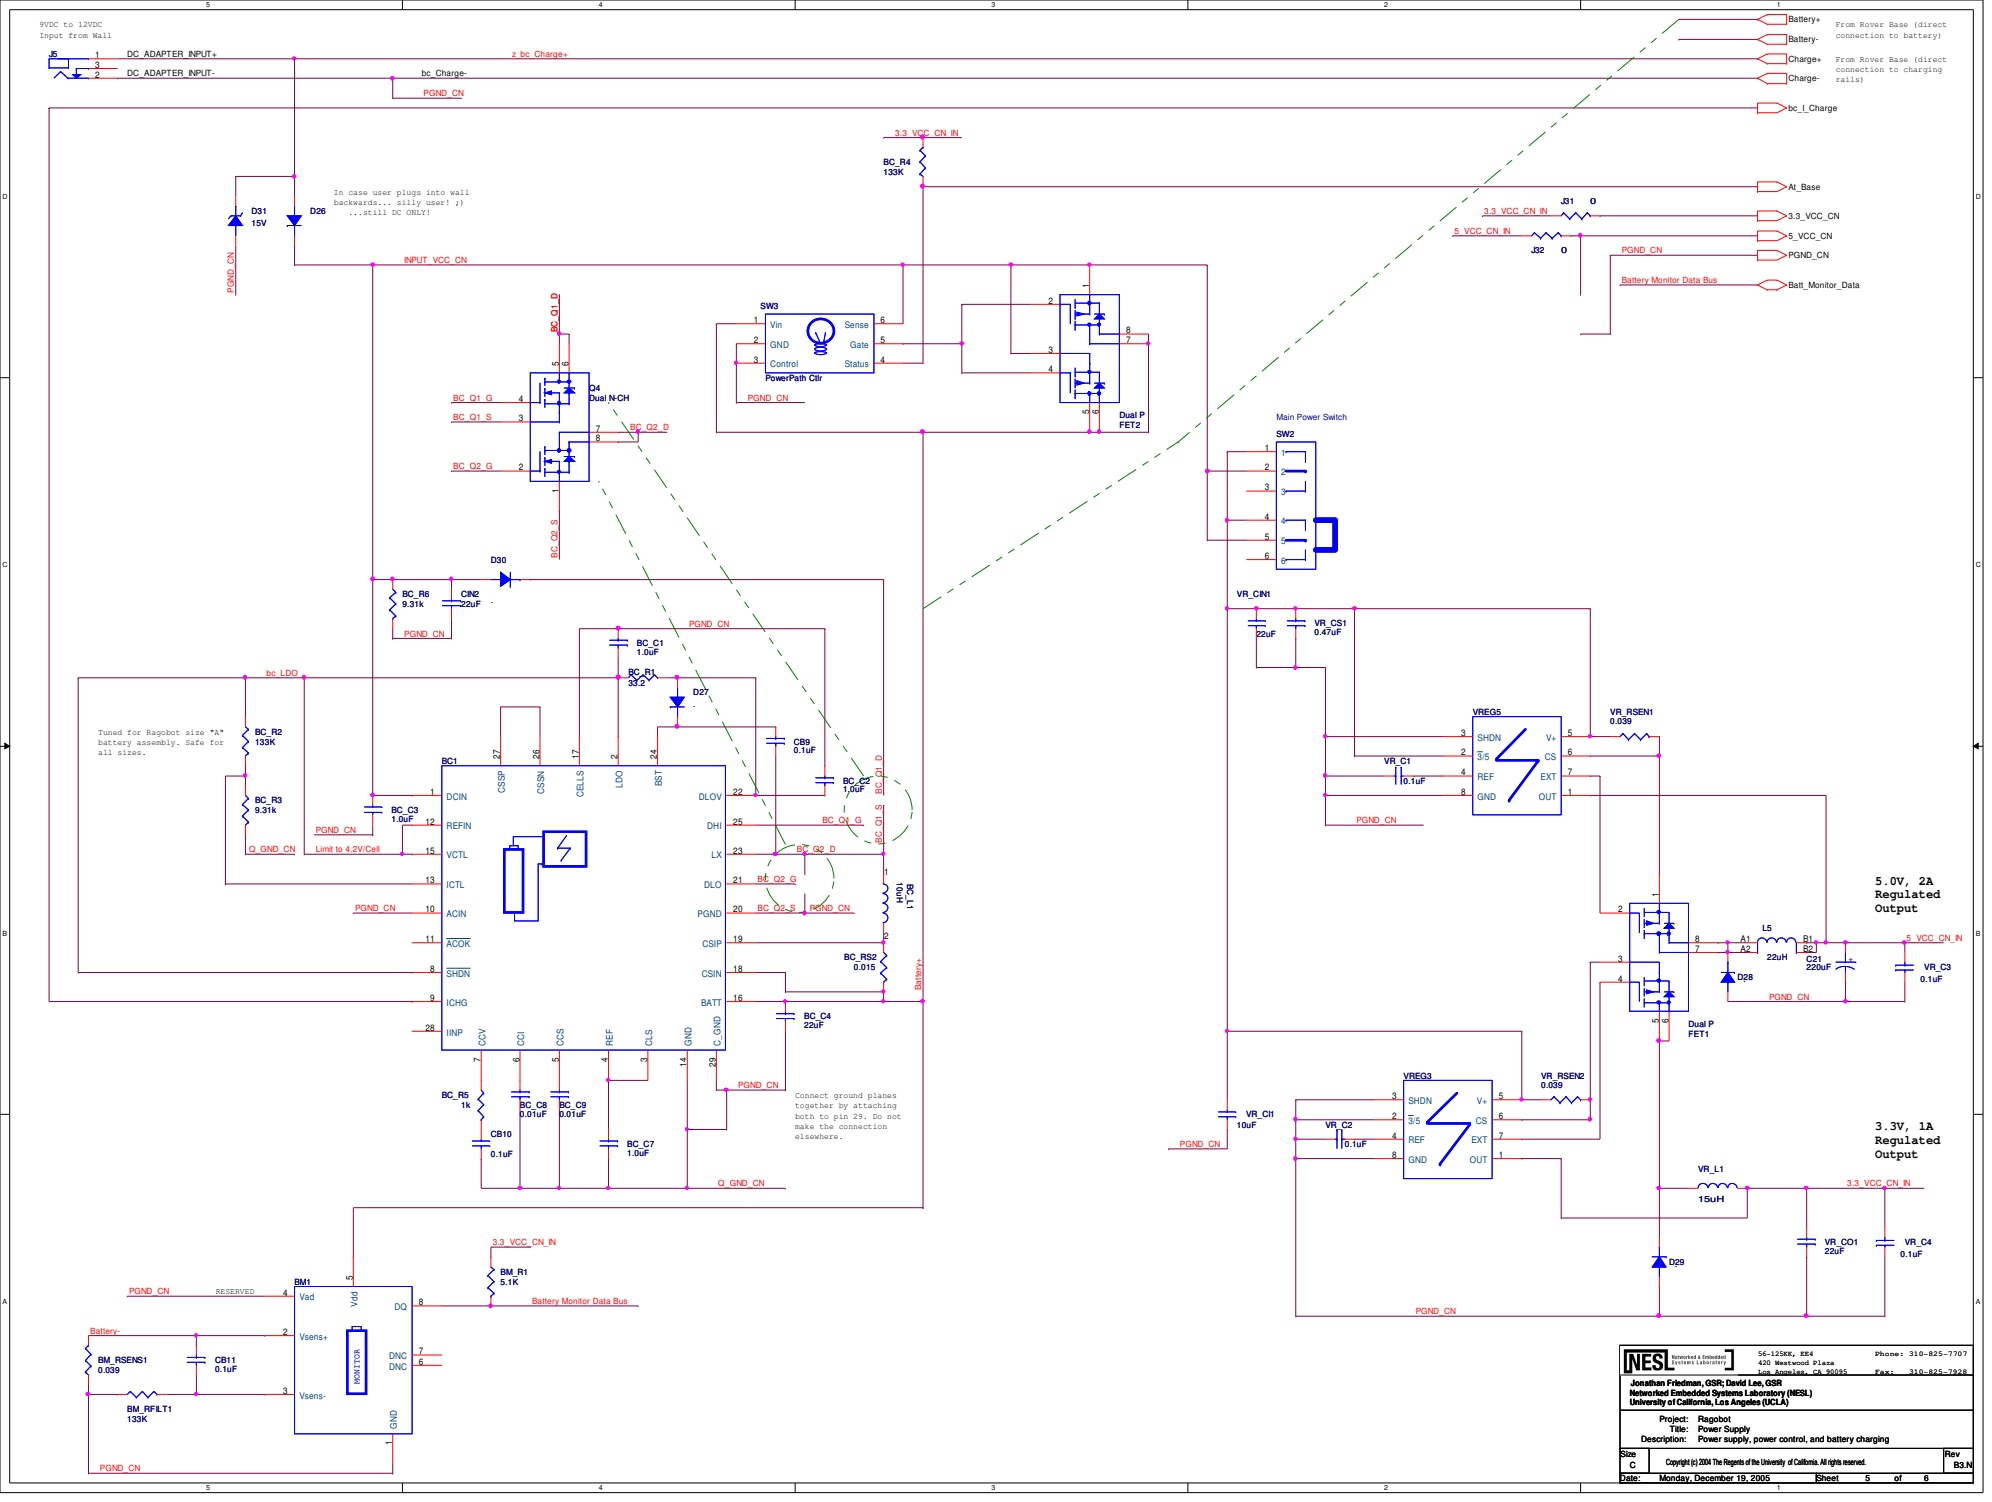
[picture p47: page 12]

From Rover Base (direct
connection to battery)

connection to charging
rails)

Main Power Switch In case user plugs into wall backwards... silly user! ;) ...still DC ONLY!

Battery Monitor Data Bus

Tuned for Ragobot size "A"
battery assembly. Safe for
all sizes.

Connect ground planes
together by attaching
both to pin 29. Do not
make the connection
elsewhere.

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

Ragobot
Power Supply
Power supply, power control, and battery charging

# Hierarchical Block IO

# Magnetometer

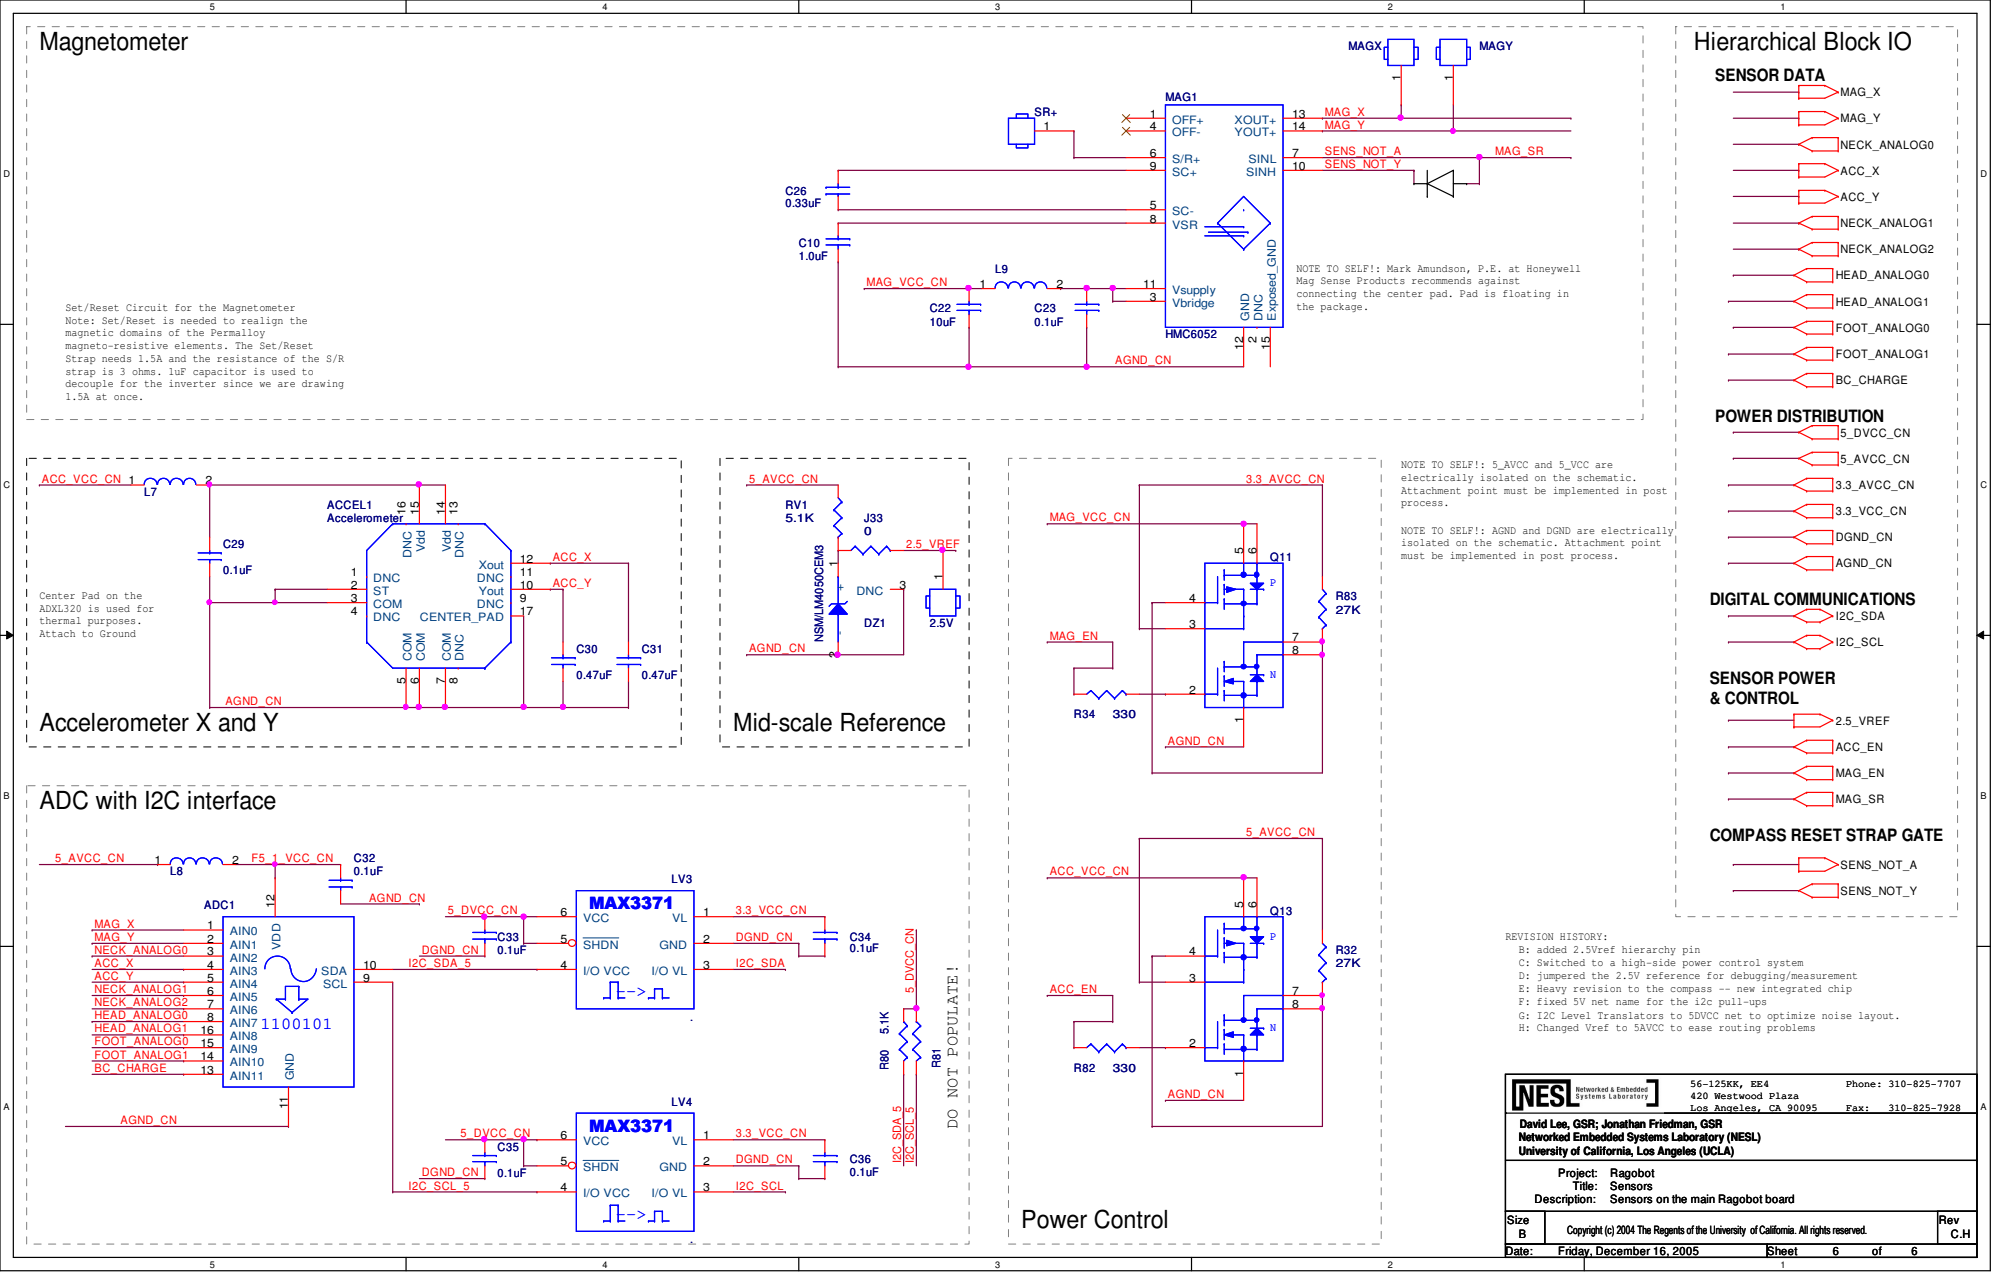
[picture p48: page 13]

NOTE TO SELF!: Mark Amundson, P.E. at Honeywell
Mag Sense Products recommends against
connecting the center pad. Pad is floating in
the package.

Set/Reset Circuit for the Magnetometer
Note: Set/Reset is needed to realign the
magnetic domains of the Permalloy
magneto-resistive elements. The Set/Reset
Strap needs 1.5A and the resistance of the S/R
strap is 3 ohms. 1uF capacitor is used to
decouple for the inverter since we are drawing
1.5A at once.

NOTE TO SELF!: 5_AVCC and 5_VCC are
electrically isolated on the schematic.
Attachment point must be implemented in post
process.

NOTE TO SELF!: AGND and DGND are electrically
isolated on the schematic. Attachment point
must be implemented in post process.

Center Pad on the
ADXL320 is used for
thermal purposes.
Attach to Ground

COMPASS RESET STRAP GATE

REVISION HISTORY:
B: added 2.5Vref hierarchy pin
C: Switched to a high-side power control system

DO NOT POPULATE!D: jumpered the 2.5V reference for debugging/measurement E: Heavy revision to the compass -- new integrated chip

F: fixed 5V net name for the i2c pull-ups
G: I2C Level Translators to 5DVCC net to optimize noise layout.
H: Changed Vref to 5AVCC to ease routing problems

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

Ragobot
Sensors
Sensors on the main Ragobot board

Copyright (c) 2004 The Regents of the University of California. All rights reserved.
