nesl/ragobots/robot/hw/overview/doc/Assembly_Instructions/UCG-TANK_ASSEMBLY.PDF

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

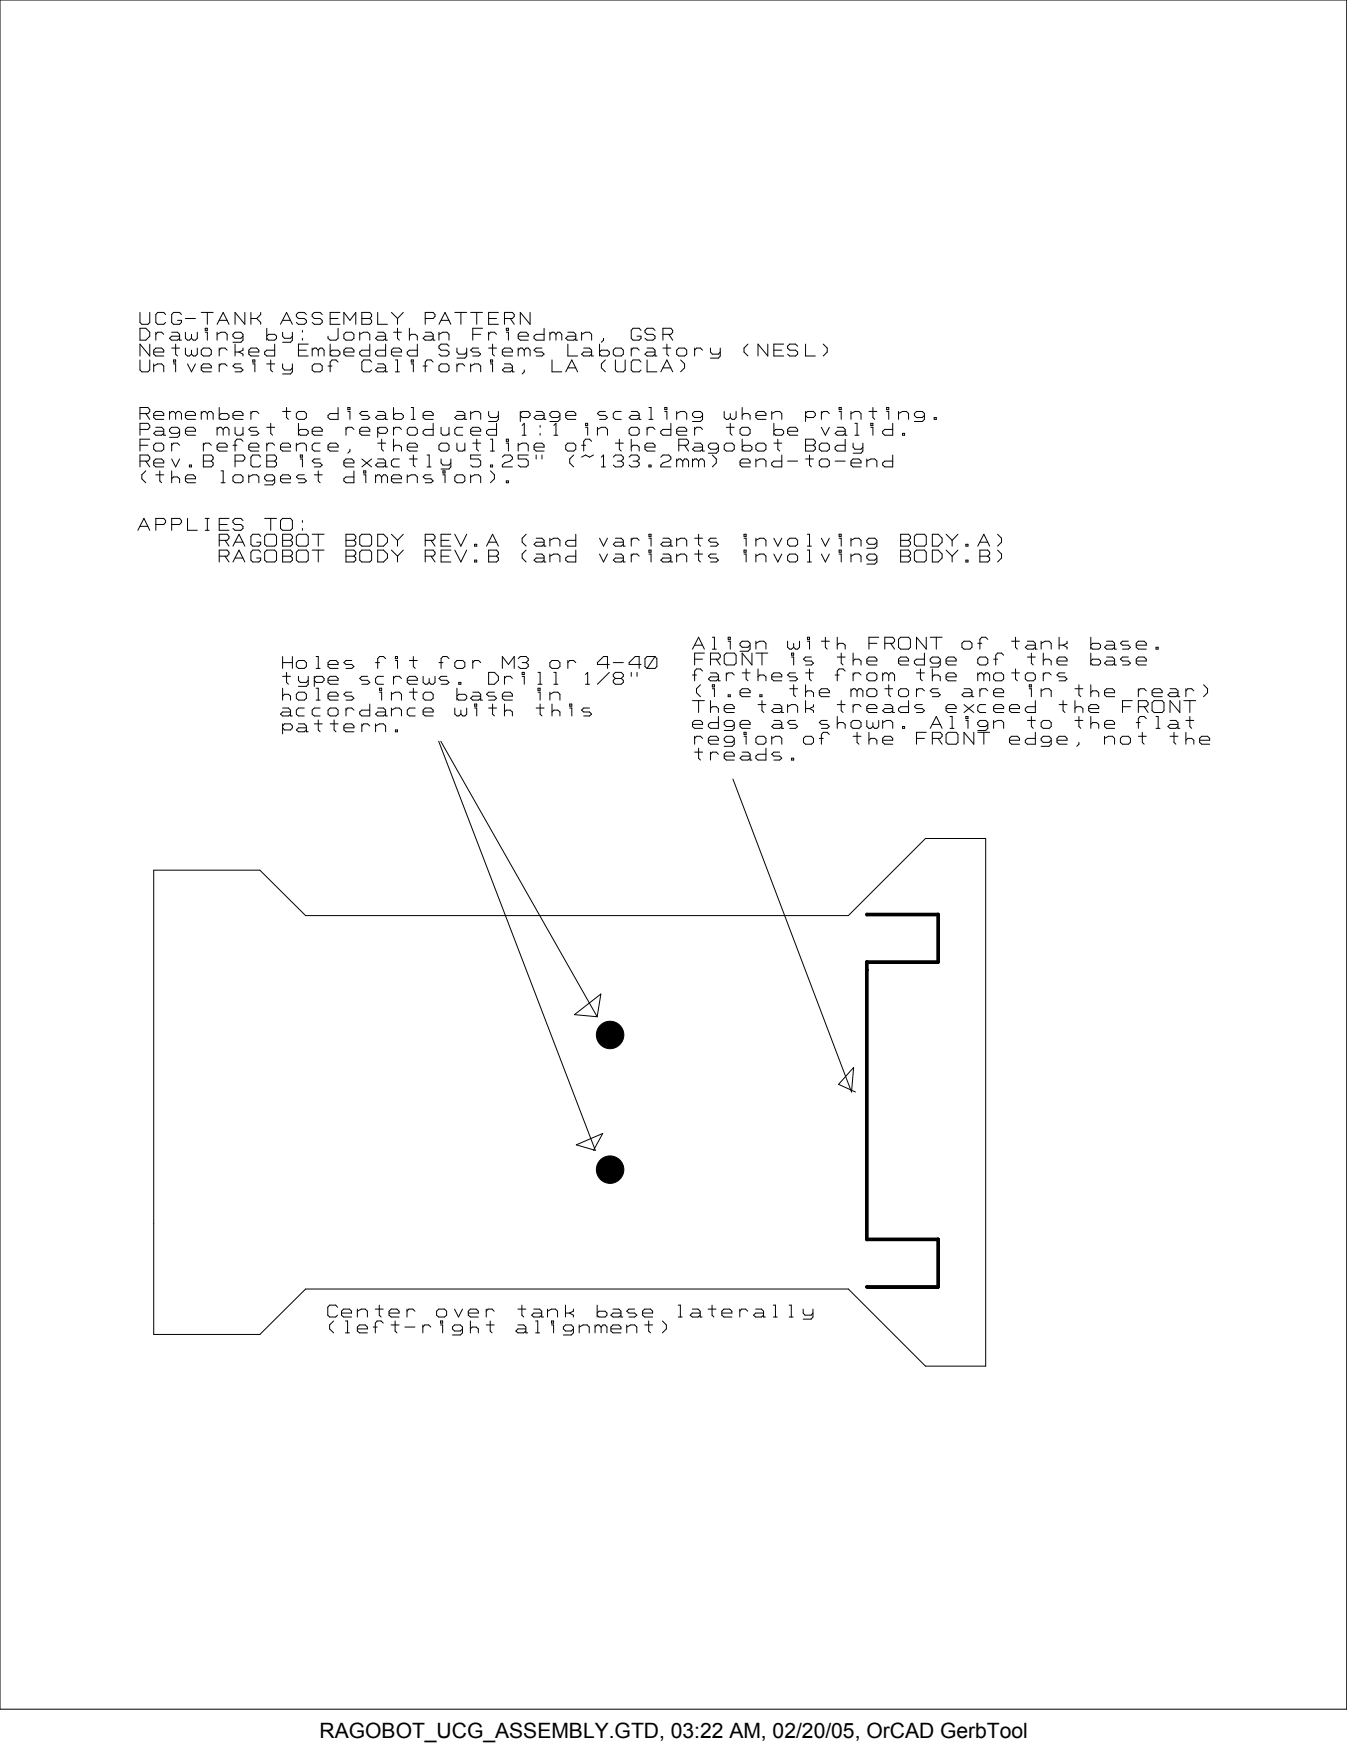
[picture p49: page 1]
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
