nesl/ragobots/(list of files, drawings)

Other design files:
robot/hw/ANT2/ANT2.DSN
robot/hw/ANT2/ANT2.opj
robot/hw/ANT2/Rev. A/ENG_DWG/ANT2.DSN
robot/hw/ant/ANT.DSN
robot/hw/ant/ANT.opj
robot/hw/body/design/ragobot.opj
robot/hw/body/design/REV.B2/RAGOBOT.DSN
robot/hw/body/design/REV.B2/RAGOBOT_B2.DSN
robot/hw/brain/XYZ_adapter/design/RGBT_XYZ_ADAPTER.DSN
robot/hw/brain/XYZ_adapter/design/rgbt_XYZ_Adapter.opj
robot/hw/expansion/portexp/design/PORTEXP.DSN
robot/hw/expansion/portexp/design/portexp.opj
robot/hw/head/design/RAGOBOT_HEAD.DSN
robot/hw/head/design/ragobot_head.opj
robot/hw/neck.display/design/NECK.DISPLAY.DSN
robot/hw/neck.display/design/neck.display.opj
robot/hw/neck.display/design/REV.A/eng_dwg/NECK.DISPLAY.DSN
robot/hw/neck.display/design/REV.A/eng_dwg/neck.display.opj
robot/hw/neck.rfid/design/NECK.DSN
robot/hw/neck.rfid/design/Neck.opj
robot/hw/neck/design/NECK.DSN
robot/hw/neck/design/Neck.opj
