nesl/ragobots/robot/sw/code/IRIS/LOWER/iris_l.asm

iris_l.elf:     file format elf32-avr

Sections:
Idx Name          Size      VMA       LMA       File off  Algn
  0 .data         00000002  00800100  00001e38  00001ecc  2**0
                  CONTENTS, ALLOC, LOAD, DATA
  1 .text         00001e38  00000000  00000000  00000094  2**0
                  CONTENTS, ALLOC, LOAD, READONLY, CODE
  2 .bss          0000012a  00800102  00800102  00001ece  2**0
                  ALLOC
  3 .noinit       00000000  0080022c  0080022c  00001ece  2**0
                  CONTENTS
  4 .eeprom       00000000  00810000  00810000  00001ece  2**0
                  CONTENTS
  5 .debug_aranges 00000064  00000000  00000000  00001ece  2**0
                  CONTENTS, READONLY, DEBUGGING
  6 .debug_pubnames 000003f1  00000000  00000000  00001f32  2**0
                  CONTENTS, READONLY, DEBUGGING
  7 .debug_info   0000196f  00000000  00000000  00002323  2**0
                  CONTENTS, READONLY, DEBUGGING
  8 .debug_abbrev 000005f3  00000000  00000000  00003c92  2**0
                  CONTENTS, READONLY, DEBUGGING
  9 .debug_line   00001371  00000000  00000000  00004285  2**0
                  CONTENTS, READONLY, DEBUGGING
 10 .debug_str    000003f8  00000000  00000000  000055f6  2**0
                  CONTENTS, READONLY, DEBUGGING
Disassembly of section .text:

00000000 <__vectors>:
       0:	0c 94 34 00 	jmp	0x68
       4:	0c 94 4f 00 	jmp	0x9e
       8:	0c 94 4f 00 	jmp	0x9e
       c:	0c 94 4f 00 	jmp	0x9e
      10:	0c 94 4f 00 	jmp	0x9e
      14:	0c 94 4f 00 	jmp	0x9e
      18:	0c 94 4f 00 	jmp	0x9e
      1c:	0c 94 4e 02 	jmp	0x49c
      20:	0c 94 4f 00 	jmp	0x9e
      24:	0c 94 4f 00 	jmp	0x9e
      28:	0c 94 4f 00 	jmp	0x9e
      2c:	0c 94 4f 00 	jmp	0x9e
      30:	0c 94 4f 00 	jmp	0x9e
      34:	0c 94 4f 00 	jmp	0x9e
      38:	0c 94 4f 00 	jmp	0x9e
      3c:	0c 94 4f 00 	jmp	0x9e
      40:	0c 94 4f 00 	jmp	0x9e
      44:	0c 94 4f 00 	jmp	0x9e
      48:	0c 94 e1 0e 	jmp	0x1dc2
      4c:	0c 94 4f 00 	jmp	0x9e
      50:	0c 94 4f 00 	jmp	0x9e
      54:	0c 94 4f 00 	jmp	0x9e
      58:	0c 94 4f 00 	jmp	0x9e
      5c:	0c 94 4f 00 	jmp	0x9e
      60:	0c 94 ee 05 	jmp	0xbdc
      64:	0c 94 4f 00 	jmp	0x9e

00000068 <__ctors_end>:
      68:	11 24       	eor	r1, r1
      6a:	1f be       	out	0x3f, r1	; 63
      6c:	cf ef       	ldi	r28, 0xFF	; 255
      6e:	d4 e0       	ldi	r29, 0x04	; 4
      70:	de bf       	out	0x3e, r29	; 62
      72:	cd bf       	out	0x3d, r28	; 61

00000074 <__do_copy_data>:
      74:	11 e0       	ldi	r17, 0x01	; 1
      76:	a0 e0       	ldi	r26, 0x00	; 0
      78:	b1 e0       	ldi	r27, 0x01	; 1
      7a:	e8 e3       	ldi	r30, 0x38	; 56
      7c:	fe e1       	ldi	r31, 0x1E	; 30
      7e:	02 c0       	rjmp	.+4      	; 0x84

00000080 <.do_copy_data_loop>:
      80:	05 90       	lpm	r0, Z+
      82:	0d 92       	st	X+, r0

00000084 <.do_copy_data_start>:
      84:	a2 30       	cpi	r26, 0x02	; 2
      86:	b1 07       	cpc	r27, r17
      88:	d9 f7       	brne	.-10     	; 0x80

0000008a <__do_clear_bss>:
      8a:	12 e0       	ldi	r17, 0x02	; 2
      8c:	a2 e0       	ldi	r26, 0x02	; 2
      8e:	b1 e0       	ldi	r27, 0x01	; 1
      90:	01 c0       	rjmp	.+2      	; 0x94

00000092 <.do_clear_bss_loop>:
      92:	1d 92       	st	X+, r1

00000094 <.do_clear_bss_start>:
      94:	ac 32       	cpi	r26, 0x2C	; 44
      96:	b1 07       	cpc	r27, r17
      98:	e1 f7       	brne	.-8      	; 0x92
      9a:	0c 94 68 00 	jmp	0xd0

0000009e <__bad_interrupt>:
      9e:	0c 94 00 00 	jmp	0x0

000000a2 <init_mcu>:
//----------------------------------------------------------------

inline void init_mcu(void) {
	// Input/Output Ports initialization
		cbi(PORTD, 2); //output 0 on IRIS_CNTRL to signal to IRISU that we are not ready	
      a2:	5a 98       	cbi	0x0b, 2	; 11
  		DDRD = B8(10101110); //UART, IRIS TX DATA, ALERT, CB2, IRIS VCC
      a4:	3e ea       	ldi	r19, 0xAE	; 174
      a6:	3a b9       	out	0x0a, r19	; 10
		
  		DDRC = B8(00001101); //Transmitter Power Level Control, I2C, Reset, TP6
      a8:	2d e0       	ldi	r18, 0x0D	; 13
      aa:	27 b9       	out	0x07, r18	; 7
  							//BUGFIX: PC1 is configured as an input to protect it because it is incorrectly shorted to PC2; all control in this code is done from PC2.  		
  		DDRB = B8(11101011); //debug LED, BLED, Clock-out, PGM I/F, XO
      ac:	8b ee       	ldi	r24, 0xEB	; 235
      ae:	84 b9       	out	0x04, r24	; 4
      b0:	08 95       	ret

000000b2 <stall>:
} //init_MCU


void stall(uint16_t limit){
  uint16_t blah, i, j;
  blah=0;
      b2:	40 e0       	ldi	r20, 0x00	; 0
      b4:	50 e0       	ldi	r21, 0x00	; 0
  for(i=0;i<0xFFFF;i++){
    for(j=0;j<limit;j++){
      b6:	00 97       	sbiw	r24, 0x00	; 0
      b8:	21 f0       	breq	.+8      	; 0xc2
      ba:	9c 01       	movw	r18, r24
      bc:	21 50       	subi	r18, 0x01	; 1
      be:	30 40       	sbci	r19, 0x00	; 0
      c0:	e9 f7       	brne	.-6      	; 0xbc
      c2:	4f 5f       	subi	r20, 0xFF	; 255
      c4:	5f 4f       	sbci	r21, 0xFF	; 255
      c6:	2f ef       	ldi	r18, 0xFF	; 255
      c8:	4f 3f       	cpi	r20, 0xFF	; 255
      ca:	52 07       	cpc	r21, r18
      cc:	a1 f7       	brne	.-24     	; 0xb6
      ce:	08 95       	ret

000000d0 <main>:
      blah++;
    }
  }	
}




//----------------------------------------------------------------
//- MAIN PROGRAM
//----------------------------------------------------------------

int main(void){
      d0:	cf ef       	ldi	r28, 0xFF	; 255
      d2:	d4 e0       	ldi	r29, 0x04	; 4
      d4:	de bf       	out	0x3e, r29	; 62
      d6:	cd bf       	out	0x3d, r28	; 61
	//VAR
		
	//INIT
		cli(); //disable interrupts (in case function is called multiple times)
      d8:	f8 94       	cli
      da:	5a 98       	cbi	0x0b, 2	; 11
      dc:	2e ea       	ldi	r18, 0xAE	; 174
      de:	2a b9       	out	0x0a, r18	; 10
      e0:	1d e0       	ldi	r17, 0x0D	; 13
      e2:	17 b9       	out	0x07, r17	; 7
      e4:	8b ee       	ldi	r24, 0xEB	; 235
      e6:	84 b9       	out	0x04, r24	; 4
		init_mcu();
		init_I2C();
      e8:	0e 94 4a 05 	call	0xa94
		init_serial(USRT);
      ec:	81 2f       	mov	r24, r17
      ee:	0e 94 31 07 	call	0xe62
		init_tp();
      f2:	0e 94 ca 00 	call	0x194
		init_iris();
      f6:	0e 94 1a 01 	call	0x234
		init_irtx(); //turn on tx encoder
      fa:	0e 94 41 01 	call	0x282
		iris_tx(HIGH); //turn on tx output
      fe:	82 e0       	ldi	r24, 0x02	; 2
     100:	0e 94 01 01 	call	0x202
		iris_rx(ON); //turn on receivers
     104:	81 e0       	ldi	r24, 0x01	; 1
     106:	0e 94 f5 00 	call	0x1ea
		tpl(OFF); //LED to OFF state
     10a:	83 e0       	ldi	r24, 0x03	; 3
     10c:	0e 94 9e 00 	call	0x13c
		tp6(LOW); //TP to LOW state
     110:	84 e0       	ldi	r24, 0x04	; 4
     112:	0e 94 b4 00 	call	0x168
		sei(); //enable interrupts (go live)
     116:	78 94       	sei
		sbi(PORTD, 2); //signal IRISU that we are ready to go!
     118:	5a 9a       	sbi	0x0b, 2	; 11

	//PGM	
	  	while(1)
		{
		  	tp6(TOGGLE);
     11a:	85 e0       	ldi	r24, 0x05	; 5
     11c:	0e 94 b4 00 	call	0x168
		  	if (i2c_count() > 0) {
     120:	0e 94 63 05 	call	0xac6
     124:	88 23       	and	r24, r24
     126:	c9 f3       	breq	.-14     	; 0x11a
			  	I2C_send();
     128:	0e 94 dd 05 	call	0xbba
     12c:	85 e0       	ldi	r24, 0x05	; 5
     12e:	0e 94 b4 00 	call	0x168
     132:	0e 94 63 05 	call	0xac6
     136:	88 23       	and	r24, r24
     138:	81 f3       	breq	.-32     	; 0x11a
     13a:	f6 cf       	rjmp	.-20     	; 0x128

0000013c <tpl>:
//----------------------------------------------------------------

//Test Point LED (D_IRISL)
inline void tpl(uint8_t cmd){
	switch(cmd){
     13c:	99 27       	eor	r25, r25
     13e:	83 30       	cpi	r24, 0x03	; 3
     140:	91 05       	cpc	r25, r1
     142:	69 f0       	breq	.+26     	; 0x15e
     144:	84 30       	cpi	r24, 0x04	; 4
     146:	91 05       	cpc	r25, r1
     148:	1c f4       	brge	.+6      	; 0x150
     14a:	01 97       	sbiw	r24, 0x01	; 1
     14c:	51 f0       	breq	.+20     	; 0x162
     14e:	08 95       	ret
     150:	05 97       	sbiw	r24, 0x05	; 5
     152:	e9 f7       	brne	.-6      	; 0x14e
		case ON:
			sbi(PORTB, 1);
			break;
		case OFF:
			cbi(PORTB, 1);
			break;
		case TOGGLE:
			tbi(PORTB, 1);
     154:	85 b1       	in	r24, 0x05	; 5
     156:	92 e0       	ldi	r25, 0x02	; 2
     158:	89 27       	eor	r24, r25
     15a:	85 b9       	out	0x05, r24	; 5
     15c:	08 95       	ret
     15e:	29 98       	cbi	0x05, 1	; 5
     160:	08 95       	ret
     162:	29 9a       	sbi	0x05, 1	; 5
     164:	08 95       	ret
     166:	08 95       	ret

00000168 <tp6>:
			break;
		default:
			break;
	}
}

//Test Point 6
inline void tp6(uint8_t cmd){
	switch(cmd){
     168:	99 27       	eor	r25, r25
     16a:	84 30       	cpi	r24, 0x04	; 4
     16c:	91 05       	cpc	r25, r1
     16e:	69 f0       	breq	.+26     	; 0x18a
     170:	85 30       	cpi	r24, 0x05	; 5
     172:	91 05       	cpc	r25, r1
     174:	1c f4       	brge	.+6      	; 0x17c
     176:	02 97       	sbiw	r24, 0x02	; 2
     178:	51 f0       	breq	.+20     	; 0x18e
     17a:	08 95       	ret
     17c:	05 97       	sbiw	r24, 0x05	; 5
     17e:	e9 f7       	brne	.-6      	; 0x17a
		case HIGH:
			sbi(PORTC, 3);
			break;
		case LOW:
			cbi(PORTC, 3);
			break;
		case TOGGLE:
			tbi(PORTC, 3);
     180:	88 b1       	in	r24, 0x08	; 8
     182:	98 e0       	ldi	r25, 0x08	; 8
     184:	89 27       	eor	r24, r25
     186:	88 b9       	out	0x08, r24	; 8
     188:	08 95       	ret
     18a:	43 98       	cbi	0x08, 3	; 8
     18c:	08 95       	ret
     18e:	43 9a       	sbi	0x08, 3	; 8
     190:	08 95       	ret
     192:	08 95       	ret

00000194 <init_tp>:
			break;
		default:
			break;
	}
}

//----------------------------------------------------------------
//- INIT ROUTINES
//----------------------------------------------------------------

inline void init_tp(){
	sbi(DDRB, 1); //LED
     194:	21 9a       	sbi	0x04, 1	; 4
	sbi(DDRC, 3); //TP6
     196:	3b 9a       	sbi	0x07, 3	; 7
     198:	29 98       	cbi	0x05, 1	; 5
     19a:	43 98       	cbi	0x08, 3	; 8
     19c:	08 95       	ret

0000019e <init_array>:
//----------------------------------------------------------------

void init_array(uint8_t* toinit, uint8_t size, uint8_t init_val){
	uint8_t i;
	for (i=0;i<size;i++){
     19e:	66 23       	and	r22, r22
     1a0:	21 f0       	breq	.+8      	; 0x1aa
     1a2:	fc 01       	movw	r30, r24
		toinit[i] = init_val;
     1a4:	41 93       	st	Z+, r20
     1a6:	61 50       	subi	r22, 0x01	; 1
     1a8:	e9 f7       	brne	.-6      	; 0x1a4
     1aa:	08 95       	ret

000001ac <init_iris_sm>:
	}
}

//reset the state machine logic that drives the byte assembly process
inline void init_iris_sm(void){
     1ac:	e3 e0       	ldi	r30, 0x03	; 3
     1ae:	f1 e0       	ldi	r31, 0x01	; 1
     1b0:	86 e0       	ldi	r24, 0x06	; 6
     1b2:	11 92       	st	Z+, r1
     1b4:	81 50       	subi	r24, 0x01	; 1
     1b6:	87 ff       	sbrs	r24, 7
     1b8:	fc cf       	rjmp	.-8      	; 0x1b2
     1ba:	ea e0       	ldi	r30, 0x0A	; 10
     1bc:	f1 e0       	ldi	r31, 0x01	; 1
     1be:	86 e0       	ldi	r24, 0x06	; 6
     1c0:	11 92       	st	Z+, r1
     1c2:	81 50       	subi	r24, 0x01	; 1
     1c4:	87 ff       	sbrs	r24, 7
     1c6:	fc cf       	rjmp	.-8      	; 0x1c0
     1c8:	e8 e1       	ldi	r30, 0x18	; 24
     1ca:	f1 e0       	ldi	r31, 0x01	; 1
     1cc:	86 e0       	ldi	r24, 0x06	; 6
     1ce:	11 92       	st	Z+, r1
     1d0:	81 50       	subi	r24, 0x01	; 1
     1d2:	87 ff       	sbrs	r24, 7
     1d4:	fc cf       	rjmp	.-8      	; 0x1ce
     1d6:	e1 e1       	ldi	r30, 0x11	; 17
     1d8:	f1 e0       	ldi	r31, 0x01	; 1
     1da:	86 e0       	ldi	r24, 0x06	; 6
     1dc:	11 92       	st	Z+, r1
     1de:	81 50       	subi	r24, 0x01	; 1
     1e0:	87 ff       	sbrs	r24, 7
     1e2:	fc cf       	rjmp	.-8      	; 0x1dc
	init_array(p_symbol, NUM__OF_CHANNELS, SYM_INVD_Q);
	init_array(p_state, NUM__OF_CHANNELS, S0);
	init_array(p_data, NUM__OF_CHANNELS, 0);
	init_array(p_count, NUM__OF_CHANNELS, 0);
	out_direction = 0x00;
     1e4:	10 92 1f 01 	sts	0x011F, r1
     1e8:	08 95       	ret

000001ea <iris_rx>:
}

//physical pin setup take care of in init_mcu();
inline void init_iris(){
	iris_rx(OFF);
	iris_tx(OFF);
	iris_weapon(OFF);	
	init_iris_sm();
}

//This init routine actually begins operation (as soon as interrupts get enabled)
//LED_ENCODE is OC2B
void init_irtx(){
	//TIMER 2: 40kHz 50% Square Wave Generator
		cbi(PORTD, 3); //so that disabled OCR2B = 0 on output
  		cbi(ASSR, 5); //clock from MCU mainline clock (16MHz)
  		enable_output_irclock();
  		TCCR2B = B8(00000001); //enable timer with no prescaler = 16MHz
  		OCR2A = 200; //toggle after 12.5mS -> 25mS period = 40kHz freq (16MHz clock)
  		TIMSK2 = B8(00000010); //OC2A match interrupt enabled
  		TIFR2; //Timer interrupt flag register
  		sbi(DDRD, 3); //OCR2B as output  		
}		

//----------------------------------------------------------------
//- IR TRANSMISSION POWER ROUTING
//----------------------------------------------------------------

//enable/disable power to the IR receivers
//usage: iris_rx(ON) / iris_rx(OFF)
extern void iris_rx(uint8_t cmd){
	switch(cmd){
     1ea:	99 27       	eor	r25, r25
     1ec:	81 30       	cpi	r24, 0x01	; 1
     1ee:	91 05       	cpc	r25, r1
     1f0:	29 f0       	breq	.+10     	; 0x1fc
     1f2:	03 97       	sbiw	r24, 0x03	; 3
     1f4:	09 f0       	breq	.+2      	; 0x1f8
     1f6:	08 95       	ret
	case ON:
		sbi(PORTD, 7);
		break;
	case OFF:
		cbi(PORTD, 7);
     1f8:	5f 98       	cbi	0x0b, 7	; 11
     1fa:	08 95       	ret
     1fc:	5f 9a       	sbi	0x0b, 7	; 11
     1fe:	08 95       	ret
     200:	08 95       	ret

00000202 <iris_tx>:
		break;
	default:
		break;	
	}	
}

//Due to a bug the two control lines are shorted together. This precludes any power setting except HIGH from functioning.
extern void iris_tx(uint8_t cmd){
	switch(cmd){
     202:	99 27       	eor	r25, r25
     204:	84 30       	cpi	r24, 0x04	; 4
     206:	91 05       	cpc	r25, r1
     208:	39 f0       	breq	.+14     	; 0x218
     20a:	85 30       	cpi	r24, 0x05	; 5
     20c:	91 05       	cpc	r25, r1
     20e:	2c f4       	brge	.+10     	; 0x21a
     210:	02 97       	sbiw	r24, 0x02	; 2
     212:	31 f0       	breq	.+12     	; 0x220
	case LOW:
		//for future use		
		break;
	case MED:
		//for future use
		break;
	case HIGH:
		sbi(PORTC, 2);
		break;
	case OFF:
		//fall through to default
	default:
		//OFF
		cbi(PORTC, 2);
     214:	42 98       	cbi	0x08, 2	; 8
		cbi(PORTC, 1);	
     216:	41 98       	cbi	0x08, 1	; 8
     218:	08 95       	ret
     21a:	06 97       	sbiw	r24, 0x06	; 6
     21c:	d9 f7       	brne	.-10     	; 0x214
     21e:	08 95       	ret
     220:	42 9a       	sbi	0x08, 2	; 8
     222:	08 95       	ret
     224:	08 95       	ret

00000226 <iris_weapon>:
	} //switch
}

extern void iris_weapon(uint8_t cmd){
	switch(cmd){
     226:	87 30       	cpi	r24, 0x07	; 7
     228:	11 f0       	breq	.+4      	; 0x22e
	case FIRE:
		sbi(PORTC, 0);
		break;
	case OFF:
		//fall through to default
	default:
		//OFF
		cbi(PORTC, 0);
     22a:	40 98       	cbi	0x08, 0	; 8
     22c:	08 95       	ret
     22e:	40 9a       	sbi	0x08, 0	; 8
     230:	08 95       	ret
     232:	08 95       	ret

00000234 <init_iris>:
     234:	5f 98       	cbi	0x0b, 7	; 11
     236:	42 98       	cbi	0x08, 2	; 8
     238:	41 98       	cbi	0x08, 1	; 8
     23a:	40 98       	cbi	0x08, 0	; 8
     23c:	e3 e0       	ldi	r30, 0x03	; 3
     23e:	f1 e0       	ldi	r31, 0x01	; 1
     240:	86 e0       	ldi	r24, 0x06	; 6
     242:	11 92       	st	Z+, r1
     244:	81 50       	subi	r24, 0x01	; 1
     246:	87 ff       	sbrs	r24, 7
     248:	fc cf       	rjmp	.-8      	; 0x242
     24a:	ea e0       	ldi	r30, 0x0A	; 10
     24c:	f1 e0       	ldi	r31, 0x01	; 1
     24e:	86 e0       	ldi	r24, 0x06	; 6
     250:	11 92       	st	Z+, r1
     252:	81 50       	subi	r24, 0x01	; 1
     254:	87 ff       	sbrs	r24, 7
     256:	fc cf       	rjmp	.-8      	; 0x250
     258:	e8 e1       	ldi	r30, 0x18	; 24
     25a:	f1 e0       	ldi	r31, 0x01	; 1
     25c:	86 e0       	ldi	r24, 0x06	; 6
     25e:	11 92       	st	Z+, r1
     260:	81 50       	subi	r24, 0x01	; 1
     262:	87 ff       	sbrs	r24, 7
     264:	fc cf       	rjmp	.-8      	; 0x25e
     266:	e1 e1       	ldi	r30, 0x11	; 17
     268:	f1 e0       	ldi	r31, 0x01	; 1
     26a:	86 e0       	ldi	r24, 0x06	; 6
     26c:	11 92       	st	Z+, r1
     26e:	81 50       	subi	r24, 0x01	; 1
     270:	87 ff       	sbrs	r24, 7
     272:	fc cf       	rjmp	.-8      	; 0x26c
     274:	10 92 1f 01 	sts	0x011F, r1
     278:	08 95       	ret

0000027a <enable_output_irclock>:
	} //switch
}


//----------------------------------------------------------------
//- IR TRANSMISSION CLOCKS
//----------------------------------------------------------------

inline void reset_irclock(){
	
}

//NEW: jonathan
inline void start_irclock(){
	//8MHz:: OCR0A = 120; //1/8e6MHz * 8 (prescale) * OCR0A = period in seconds (for these values 8/8=1, so OCR0A = period in uS)
	//OCR0A = 180; //for 16MHz clock; 180= 90uS period
	OCR0A = 140; //for 16MHz clock; 100 = 50uS period; 140 = 70uS period
	OCR0B = 0x00; //min out the compare registers so that the interrupt flag register is easier for GCC to read (bits will always be 1 so TIFR0 = B4(0110) if no overflow)
	TCNT0 = 0xFF; //start with overflow flag set to make GCC processing of byte easier
	TCCR0A = B8(00000010); //CTC MODE, NO I/O BEHAVIORS
	TCCR0B = B8(00000010); //8MHZ CLOCK / 8 = 256uS PER PERIOD
}

//NEW: jonathan
inline void stop_irclock(){
	TCCR0B = B8(00000000); //NO CLOCK SOURCE = STOPPED
}

inline void disable_output_irclock(){
  TCCR2A = B8(00100010); //OC2A=off,OC2B=clear on compare,Mode = CTC
}

inline void enable_output_irclock(){
  TCCR2A = B8(00010010); //OC2A=off,OC2B=toggle on compare,Mode = CTC
     27a:	82 e1       	ldi	r24, 0x12	; 18
     27c:	80 93 b0 00 	sts	0x00B0, r24
     280:	08 95       	ret

00000282 <init_irtx>:
     282:	5b 98       	cbi	0x0b, 3	; 11
     284:	50 91 b6 00 	lds	r21, 0x00B6
     288:	5f 7d       	andi	r21, 0xDF	; 223
     28a:	50 93 b6 00 	sts	0x00B6, r21
     28e:	42 e1       	ldi	r20, 0x12	; 18
     290:	40 93 b0 00 	sts	0x00B0, r20
     294:	31 e0       	ldi	r19, 0x01	; 1
     296:	30 93 b1 00 	sts	0x00B1, r19
     29a:	28 ec       	ldi	r18, 0xC8	; 200
     29c:	20 93 b3 00 	sts	0x00B3, r18
     2a0:	82 e0       	ldi	r24, 0x02	; 2
     2a2:	80 93 70 00 	sts	0x0070, r24
     2a6:	87 b3       	in	r24, 0x17	; 23
     2a8:	53 9a       	sbi	0x0a, 3	; 10
     2aa:	08 95       	ret

000002ac <reset_irclock>:
     2ac:	08 95       	ret

000002ae <start_irclock>:
     2ae:	3c e8       	ldi	r19, 0x8C	; 140
     2b0:	37 bd       	out	0x27, r19	; 39
     2b2:	18 bc       	out	0x28, r1	; 40
     2b4:	2f ef       	ldi	r18, 0xFF	; 255
     2b6:	26 bd       	out	0x26, r18	; 38
     2b8:	82 e0       	ldi	r24, 0x02	; 2
     2ba:	84 bd       	out	0x24, r24	; 36
     2bc:	85 bd       	out	0x25, r24	; 37
     2be:	08 95       	ret

000002c0 <stop_irclock>:
     2c0:	15 bc       	out	0x25, r1	; 37
     2c2:	08 95       	ret

000002c4 <disable_output_irclock>:
     2c4:	82 e2       	ldi	r24, 0x22	; 34
     2c6:	80 93 b0 00 	sts	0x00B0, r24
     2ca:	08 95       	ret

000002cc <iris_unpack>:
}



//----------------------------------------------------------------
//- IRIS BYTE ASSEMBLY
//----------------------------------------------------------------

//unpack the byte into a single channel
//position range is 0-3
inline uint8_t iris_unpack(uint8_t position, uint8_t datain){
	datain = datain >> position;
     2cc:	26 2f       	mov	r18, r22
     2ce:	33 27       	eor	r19, r19
     2d0:	02 c0       	rjmp	.+4      	; 0x2d6
     2d2:	35 95       	asr	r19
     2d4:	27 95       	ror	r18
     2d6:	8a 95       	dec	r24
     2d8:	e2 f7       	brpl	.-8      	; 0x2d2
     2da:	82 2f       	mov	r24, r18
	datain = datain & B8(00000011);
     2dc:	83 70       	andi	r24, 0x03	; 3
	return datain;
}
     2de:	99 27       	eor	r25, r25
     2e0:	08 95       	ret

000002e2 <iris_xfr_receive>:

//unpack; xfr0 was received first
inline void iris_xfr_receive(uint8_t sym_xfr0, uint8_t sym_xfr1){
     2e2:	e6 2f       	mov	r30, r22
     2e4:	28 2f       	mov	r18, r24
     2e6:	33 27       	eor	r19, r19
     2e8:	62 e0       	ldi	r22, 0x02	; 2
     2ea:	70 e0       	ldi	r23, 0x00	; 0
     2ec:	c9 01       	movw	r24, r18
     2ee:	06 2e       	mov	r0, r22
     2f0:	02 c0       	rjmp	.+4      	; 0x2f6
     2f2:	95 95       	asr	r25
     2f4:	87 95       	ror	r24
     2f6:	0a 94       	dec	r0
     2f8:	e2 f7       	brpl	.-8      	; 0x2f2
     2fa:	83 70       	andi	r24, 0x03	; 3
     2fc:	80 93 09 01 	sts	0x0109, r24
     300:	41 e0       	ldi	r20, 0x01	; 1
     302:	50 e0       	ldi	r21, 0x00	; 0
     304:	c9 01       	movw	r24, r18
     306:	04 2e       	mov	r0, r20
     308:	02 c0       	rjmp	.+4      	; 0x30e
     30a:	95 95       	asr	r25
     30c:	87 95       	ror	r24
     30e:	0a 94       	dec	r0
     310:	e2 f7       	brpl	.-8      	; 0x30a
     312:	83 70       	andi	r24, 0x03	; 3
     314:	80 93 08 01 	sts	0x0108, r24
     318:	32 2f       	mov	r19, r18
     31a:	33 70       	andi	r19, 0x03	; 3
     31c:	30 93 07 01 	sts	0x0107, r19
     320:	2e 2f       	mov	r18, r30
     322:	33 27       	eor	r19, r19
     324:	c9 01       	movw	r24, r18
     326:	96 95       	lsr	r25
     328:	87 95       	ror	r24
     32a:	96 95       	lsr	r25
     32c:	87 95       	ror	r24
     32e:	96 95       	lsr	r25
     330:	87 95       	ror	r24
     332:	83 70       	andi	r24, 0x03	; 3
     334:	80 93 06 01 	sts	0x0106, r24
     338:	c9 01       	movw	r24, r18
     33a:	02 c0       	rjmp	.+4      	; 0x340
     33c:	95 95       	asr	r25
     33e:	87 95       	ror	r24
     340:	6a 95       	dec	r22
     342:	e2 f7       	brpl	.-8      	; 0x33c
     344:	83 70       	andi	r24, 0x03	; 3
     346:	80 93 05 01 	sts	0x0105, r24
     34a:	c9 01       	movw	r24, r18
     34c:	02 c0       	rjmp	.+4      	; 0x352
     34e:	95 95       	asr	r25
     350:	87 95       	ror	r24
     352:	4a 95       	dec	r20
     354:	e2 f7       	brpl	.-8      	; 0x34e
     356:	83 70       	andi	r24, 0x03	; 3
     358:	80 93 04 01 	sts	0x0104, r24
     35c:	82 2f       	mov	r24, r18
     35e:	83 70       	andi	r24, 0x03	; 3
     360:	80 93 03 01 	sts	0x0103, r24
     364:	08 95       	ret

00000366 <S1>:
	p_symbol[6] = iris_unpack(2, sym_xfr0);
	p_symbol[5] = iris_unpack(1, sym_xfr0);
	p_symbol[4] = iris_unpack(0, sym_xfr0);
	p_symbol[3] = iris_unpack(3, sym_xfr1);
	p_symbol[2] = iris_unpack(2, sym_xfr1);
	p_symbol[1] = iris_unpack(1, sym_xfr1);
	p_symbol[0] = iris_unpack(0, sym_xfr1);
}

//the missing virtual state 1 from the diagram
inline void S1(uint8_t channel_num){
	//This code in here is the function of State S1 from the 
			//	diagram in my thesis (not a real state, but made 
			//	diagram easier to read)
			p_state[channel_num] = S2;
     366:	a8 2f       	mov	r26, r24
     368:	bb 27       	eor	r27, r27
     36a:	fd 01       	movw	r30, r26
     36c:	e6 5f       	subi	r30, 0xF6	; 246
     36e:	fe 4f       	sbci	r31, 0xFE	; 254
     370:	82 e0       	ldi	r24, 0x02	; 2
     372:	80 83       	st	Z, r24
			p_count[channel_num] = 0;
     374:	fd 01       	movw	r30, r26
     376:	ef 5e       	subi	r30, 0xEF	; 239
     378:	fe 4f       	sbci	r31, 0xFE	; 254
     37a:	10 82       	st	Z, r1
			p_data[channel_num] = 0x00;
     37c:	a8 5e       	subi	r26, 0xE8	; 232
     37e:	be 4f       	sbci	r27, 0xFE	; 254
     380:	1c 92       	st	X, r1
     382:	08 95       	ret

00000384 <S3>:
}

inline void S3(uint8_t channel_num){
	//This code in here is the function of State S3 from the diagram
			//	in my thesis.
			//COMPRESS AND REPORT!
			//mark direction
			sbi(out_direction, channel_num);
     384:	e8 2f       	mov	r30, r24
     386:	ff 27       	eor	r31, r31
     388:	81 e0       	ldi	r24, 0x01	; 1
     38a:	90 e0       	ldi	r25, 0x00	; 0
     38c:	0e 2e       	mov	r0, r30
     38e:	02 c0       	rjmp	.+4      	; 0x394
     390:	88 0f       	add	r24, r24
     392:	99 1f       	adc	r25, r25
     394:	0a 94       	dec	r0
     396:	e2 f7       	brpl	.-8      	; 0x390
     398:	20 91 1f 01 	lds	r18, 0x011F
     39c:	28 2b       	or	r18, r24
     39e:	20 93 1f 01 	sts	0x011F, r18
			p_state[channel_num] = S0; //reset for next byte
     3a2:	e6 5f       	subi	r30, 0xF6	; 246
     3a4:	fe 4f       	sbci	r31, 0xFE	; 254
     3a6:	10 82       	st	Z, r1
     3a8:	08 95       	ret

000003aa <iris_byte_assembly>:
}

//process each channel
inline void iris_byte_assembly(uint8_t channel_num){
     3aa:	cf 93       	push	r28
     3ac:	df 93       	push	r29
	switch(p_state[channel_num]){
     3ae:	c8 2f       	mov	r28, r24
     3b0:	dd 27       	eor	r29, r29
     3b2:	ae 01       	movw	r20, r28
     3b4:	46 5f       	subi	r20, 0xF6	; 246
     3b6:	5e 4f       	sbci	r21, 0xFE	; 254
     3b8:	fa 01       	movw	r30, r20
     3ba:	80 81       	ld	r24, Z
     3bc:	99 27       	eor	r25, r25
     3be:	00 97       	sbiw	r24, 0x00	; 0
     3c0:	29 f0       	breq	.+10     	; 0x3cc
     3c2:	02 97       	sbiw	r24, 0x02	; 2
     3c4:	a9 f0       	breq	.+42     	; 0x3f0
	case S0:
		//LOOK FOR START SYMBOL
		if (p_symbol[channel_num] == SYM_START_Q){
			S1(channel_num);
		}
		break;
	
//	case S1: implemented as a function call above
	
	case S2:
		//COLLECT DATA BITS
		switch(p_symbol[channel_num]){
		
			case SYM_0_Q:
				//p_data[channel_num] is wiped to 0x00 during START detection
				//	this allows us to make the optimization of not testing or 
				//	writing the data byte now (since the bit position is already 0)
				//	just increase the bit pointer to indicate that we have seen 
				//	this valid bit already
				p_count[channel_num]++;	
				
				//END DETECTION (found valid data byte)
				if (p_count[channel_num] >= 8){
					S3(channel_num);
				}
				break;
			
			case SYM_1_Q:
				//write a 1 to the current bit position
				//remember that bits arrive MSb first, but count goes up
				//i.e. bit position 7 arrives first, when p_count = 0
				//so we need a bit of inversion logic here
				p_data[channel_num] |= (0x80 >> p_count[channel_num]);
				p_count[channel_num]++;	
				
				//END DETECTION (found valid data byte)
				if (p_count[channel_num] >= 8){
					S3(channel_num);
				}
				break;
			
			case SYM_START_Q:
				S1(channel_num);
				break;
			
			default: //SYM_INVALID_Q
				p_state[channel_num] = S0;
				break;
		}
		break;
		
	default:
		p_state[channel_num] = S0; //error recovery	
     3c6:	ea 01       	movw	r28, r20
     3c8:	18 82       	st	Y, r1
     3ca:	65 c0       	rjmp	.+202    	; 0x496
     3cc:	fe 01       	movw	r30, r28
     3ce:	ed 5f       	subi	r30, 0xFD	; 253
     3d0:	fe 4f       	sbci	r31, 0xFE	; 254
     3d2:	80 81       	ld	r24, Z
     3d4:	83 30       	cpi	r24, 0x03	; 3
     3d6:	09 f0       	breq	.+2      	; 0x3da
     3d8:	5e c0       	rjmp	.+188    	; 0x496
     3da:	82 e0       	ldi	r24, 0x02	; 2
     3dc:	fa 01       	movw	r30, r20
     3de:	80 83       	st	Z, r24
     3e0:	fe 01       	movw	r30, r28
     3e2:	ef 5e       	subi	r30, 0xEF	; 239
     3e4:	fe 4f       	sbci	r31, 0xFE	; 254
     3e6:	10 82       	st	Z, r1
     3e8:	c8 5e       	subi	r28, 0xE8	; 232
     3ea:	de 4f       	sbci	r29, 0xFE	; 254
     3ec:	18 82       	st	Y, r1
     3ee:	53 c0       	rjmp	.+166    	; 0x496
     3f0:	fe 01       	movw	r30, r28
     3f2:	ed 5f       	subi	r30, 0xFD	; 253
     3f4:	fe 4f       	sbci	r31, 0xFE	; 254
     3f6:	60 81       	ld	r22, Z
     3f8:	26 2f       	mov	r18, r22
     3fa:	33 27       	eor	r19, r19
     3fc:	22 30       	cpi	r18, 0x02	; 2
     3fe:	31 05       	cpc	r19, r1
     400:	29 f1       	breq	.+74     	; 0x44c
     402:	23 30       	cpi	r18, 0x03	; 3
     404:	31 05       	cpc	r19, r1
     406:	3c f4       	brge	.+14     	; 0x416
     408:	21 30       	cpi	r18, 0x01	; 1
     40a:	31 05       	cpc	r19, r1
     40c:	51 f0       	breq	.+20     	; 0x422
     40e:	c6 5f       	subi	r28, 0xF6	; 246
     410:	de 4f       	sbci	r29, 0xFE	; 254
     412:	18 82       	st	Y, r1
     414:	40 c0       	rjmp	.+128    	; 0x496
     416:	23 30       	cpi	r18, 0x03	; 3
     418:	31 05       	cpc	r19, r1
     41a:	f9 f2       	breq	.-66     	; 0x3da
     41c:	c6 5f       	subi	r28, 0xF6	; 246
     41e:	de 4f       	sbci	r29, 0xFE	; 254
     420:	f8 cf       	rjmp	.-16     	; 0x412
     422:	fe 01       	movw	r30, r28
     424:	ef 5e       	subi	r30, 0xEF	; 239
     426:	fe 4f       	sbci	r31, 0xFE	; 254
     428:	70 81       	ld	r23, Z
     42a:	7f 5f       	subi	r23, 0xFF	; 255
     42c:	70 83       	st	Z, r23
     42e:	78 30       	cpi	r23, 0x08	; 8
     430:	90 f1       	brcs	.+100    	; 0x496
     432:	02 c0       	rjmp	.+4      	; 0x438
     434:	22 0f       	add	r18, r18
     436:	33 1f       	adc	r19, r19
     438:	ca 95       	dec	r28
     43a:	e2 f7       	brpl	.-8      	; 0x434
     43c:	30 91 1f 01 	lds	r19, 0x011F
     440:	32 2b       	or	r19, r18
     442:	30 93 1f 01 	sts	0x011F, r19
     446:	ea 01       	movw	r28, r20
     448:	18 82       	st	Y, r1
     44a:	25 c0       	rjmp	.+74     	; 0x496
     44c:	fe 01       	movw	r30, r28
     44e:	e8 5e       	subi	r30, 0xE8	; 232
     450:	fe 4f       	sbci	r31, 0xFE	; 254
     452:	de 01       	movw	r26, r28
     454:	af 5e       	subi	r26, 0xEF	; 239
     456:	be 4f       	sbci	r27, 0xFE	; 254
     458:	6c 91       	ld	r22, X
     45a:	80 e8       	ldi	r24, 0x80	; 128
     45c:	90 e0       	ldi	r25, 0x00	; 0
     45e:	06 2e       	mov	r0, r22
     460:	02 c0       	rjmp	.+4      	; 0x466
     462:	95 95       	asr	r25
     464:	87 95       	ror	r24
     466:	0a 94       	dec	r0
     468:	e2 f7       	brpl	.-8      	; 0x462
     46a:	90 81       	ld	r25, Z
     46c:	98 2b       	or	r25, r24
     46e:	90 83       	st	Z, r25
     470:	26 2f       	mov	r18, r22
     472:	2f 5f       	subi	r18, 0xFF	; 255
     474:	2c 93       	st	X, r18
     476:	28 30       	cpi	r18, 0x08	; 8
     478:	70 f0       	brcs	.+28     	; 0x496
     47a:	81 e0       	ldi	r24, 0x01	; 1
     47c:	90 e0       	ldi	r25, 0x00	; 0
     47e:	02 c0       	rjmp	.+4      	; 0x484
     480:	88 0f       	add	r24, r24
     482:	99 1f       	adc	r25, r25
     484:	ca 95       	dec	r28
     486:	e2 f7       	brpl	.-8      	; 0x480
     488:	b0 91 1f 01 	lds	r27, 0x011F
     48c:	b8 2b       	or	r27, r24
     48e:	b0 93 1f 01 	sts	0x011F, r27
     492:	ea 01       	movw	r28, r20
     494:	18 82       	st	Y, r1
     496:	df 91       	pop	r29
     498:	cf 91       	pop	r28
     49a:	08 95       	ret

0000049c <__vector_7>:
		break;
	}	
}


//----------------------------------------------------------------
//- INTERRUPT SERVICE ROUTINES
//----------------------------------------------------------------

//30 = 350uS

#define t400us 15   //40 //actually 336us
#define t200us 23 //actually 232us
#define t150us 14 //16 //actually 156us

//#define t350us 32 //actually 336us


SIGNAL(SIG_OUTPUT_COMPARE2A){
     49c:	1f 92       	push	r1
     49e:	0f 92       	push	r0
     4a0:	0f b6       	in	r0, 0x3f	; 63
     4a2:	0f 92       	push	r0
     4a4:	11 24       	eor	r1, r1
     4a6:	2f 93       	push	r18
     4a8:	3f 93       	push	r19
     4aa:	4f 93       	push	r20
     4ac:	5f 93       	push	r21
     4ae:	6f 93       	push	r22
     4b0:	7f 93       	push	r23
     4b2:	8f 93       	push	r24
     4b4:	9f 93       	push	r25
  static volatile uint8_t	cpp=0;
  static volatile uint8_t	active=t400us; 
  
  cpp++;
     4b6:	20 91 02 01 	lds	r18, 0x0102
     4ba:	2f 5f       	subi	r18, 0xFF	; 255
     4bc:	20 93 02 01 	sts	0x0102, r18
  if (cpp == active){
     4c0:	90 91 02 01 	lds	r25, 0x0102
     4c4:	80 91 00 01 	lds	r24, 0x0100
     4c8:	98 17       	cp	r25, r24
     4ca:	c9 f0       	breq	.+50     	; 0x4fe
    disable_output_irclock();	
  }
  else if (cpp >= 80){  //should be 80
     4cc:	30 91 02 01 	lds	r19, 0x0102
     4d0:	30 35       	cpi	r19, 0x50	; 80
     4d2:	28 f1       	brcs	.+74     	; 0x51e
    cpp = 0;
     4d4:	10 92 02 01 	sts	0x0102, r1
    if (active == t400us) active=t150us;
     4d8:	40 91 00 01 	lds	r20, 0x0100
     4dc:	4f 30       	cpi	r20, 0x0F	; 15
     4de:	b9 f0       	breq	.+46     	; 0x50e
    else if (active == t150us) active=t200us;
     4e0:	50 91 00 01 	lds	r21, 0x0100
     4e4:	5e 30       	cpi	r21, 0x0E	; 14
     4e6:	79 f0       	breq	.+30     	; 0x506
    else if (active == t200us) active=t400us; 
     4e8:	60 91 00 01 	lds	r22, 0x0100
     4ec:	67 31       	cpi	r22, 0x17	; 23
     4ee:	99 f0       	breq	.+38     	; 0x516
    active = t400us; //xxx
     4f0:	7f e0       	ldi	r23, 0x0F	; 15
     4f2:	70 93 00 01 	sts	0x0100, r23
     4f6:	82 e1       	ldi	r24, 0x12	; 18
     4f8:	80 93 b0 00 	sts	0x00B0, r24
     4fc:	10 c0       	rjmp	.+32     	; 0x51e
     4fe:	82 e2       	ldi	r24, 0x22	; 34
     500:	80 93 b0 00 	sts	0x00B0, r24
     504:	0c c0       	rjmp	.+24     	; 0x51e
     506:	87 e1       	ldi	r24, 0x17	; 23
     508:	80 93 00 01 	sts	0x0100, r24
     50c:	f1 cf       	rjmp	.-30     	; 0x4f0
     50e:	8e e0       	ldi	r24, 0x0E	; 14
     510:	80 93 00 01 	sts	0x0100, r24
     514:	ed cf       	rjmp	.-38     	; 0x4f0
     516:	8f e0       	ldi	r24, 0x0F	; 15
     518:	80 93 00 01 	sts	0x0100, r24
     51c:	e9 cf       	rjmp	.-46     	; 0x4f0
     51e:	9f 91       	pop	r25
     520:	8f 91       	pop	r24
     522:	7f 91       	pop	r23
     524:	6f 91       	pop	r22
     526:	5f 91       	pop	r21
     528:	4f 91       	pop	r20
     52a:	3f 91       	pop	r19
     52c:	2f 91       	pop	r18
     52e:	0f 90       	pop	r0
     530:	0f be       	out	0x3f, r0	; 63
     532:	0f 90       	pop	r0
     534:	1f 90       	pop	r1
     536:	18 95       	reti

00000538 <USRT_DATA_RX_ISR>:
    enable_output_irclock();
    //tpl(TOGGLE);
    //disable_output_irclock();//xxx	
  }
}

//make sure that this interrupt is interruptable
//data0 was received first
inline void USRT_DATA_RX_ISR(uint8_t data0, uint8_t data1){
     538:	ef 92       	push	r14
     53a:	ff 92       	push	r15
     53c:	1f 93       	push	r17
     53e:	cf 93       	push	r28
     540:	52 e0       	ldi	r21, 0x02	; 2
     542:	28 2f       	mov	r18, r24
     544:	33 27       	eor	r19, r19
     546:	c9 01       	movw	r24, r18
     548:	05 2e       	mov	r0, r21
     54a:	02 c0       	rjmp	.+4      	; 0x550
     54c:	95 95       	asr	r25
     54e:	87 95       	ror	r24
     550:	0a 94       	dec	r0
     552:	e2 f7       	brpl	.-8      	; 0x54c
     554:	83 70       	andi	r24, 0x03	; 3
     556:	80 93 09 01 	sts	0x0109, r24
     55a:	c9 01       	movw	r24, r18
     55c:	95 95       	asr	r25
     55e:	87 95       	ror	r24
     560:	83 70       	andi	r24, 0x03	; 3
     562:	80 93 08 01 	sts	0x0108, r24
     566:	12 2f       	mov	r17, r18
     568:	13 70       	andi	r17, 0x03	; 3
     56a:	10 93 07 01 	sts	0x0107, r17
     56e:	26 2f       	mov	r18, r22
     570:	33 27       	eor	r19, r19
     572:	c9 01       	movw	r24, r18
     574:	95 95       	asr	r25
     576:	87 95       	ror	r24
     578:	95 95       	asr	r25
     57a:	87 95       	ror	r24
     57c:	95 95       	asr	r25
     57e:	87 95       	ror	r24
     580:	83 70       	andi	r24, 0x03	; 3
     582:	80 93 06 01 	sts	0x0106, r24
     586:	c9 01       	movw	r24, r18
     588:	05 2e       	mov	r0, r21
     58a:	02 c0       	rjmp	.+4      	; 0x590
     58c:	95 95       	asr	r25
     58e:	87 95       	ror	r24
     590:	0a 94       	dec	r0
     592:	e2 f7       	brpl	.-8      	; 0x58c
     594:	83 70       	andi	r24, 0x03	; 3
     596:	80 93 05 01 	sts	0x0105, r24
     59a:	c9 01       	movw	r24, r18
     59c:	95 95       	asr	r25
     59e:	87 95       	ror	r24
     5a0:	83 70       	andi	r24, 0x03	; 3
     5a2:	80 93 04 01 	sts	0x0104, r24
     5a6:	82 2f       	mov	r24, r18
     5a8:	83 70       	andi	r24, 0x03	; 3
     5aa:	28 2f       	mov	r18, r24
     5ac:	33 27       	eor	r19, r19
     5ae:	20 93 03 01 	sts	0x0103, r18
     5b2:	80 91 0a 01 	lds	r24, 0x010A
     5b6:	99 27       	eor	r25, r25
     5b8:	00 97       	sbiw	r24, 0x00	; 0
     5ba:	09 f4       	brne	.+2      	; 0x5be
     5bc:	8b c0       	rjmp	.+278    	; 0x6d4
     5be:	02 97       	sbiw	r24, 0x02	; 2
     5c0:	09 f4       	brne	.+2      	; 0x5c4
     5c2:	fe c0       	rjmp	.+508    	; 0x7c0
     5c4:	10 92 0a 01 	sts	0x010A, r1
     5c8:	80 91 0b 01 	lds	r24, 0x010B
     5cc:	99 27       	eor	r25, r25
     5ce:	00 97       	sbiw	r24, 0x00	; 0
     5d0:	09 f4       	brne	.+2      	; 0x5d4
     5d2:	8f c0       	rjmp	.+286    	; 0x6f2
     5d4:	02 97       	sbiw	r24, 0x02	; 2
     5d6:	09 f4       	brne	.+2      	; 0x5da
     5d8:	9c c1       	rjmp	.+824    	; 0x912
     5da:	10 92 0b 01 	sts	0x010B, r1
     5de:	22 e0       	ldi	r18, 0x02	; 2
     5e0:	80 91 0c 01 	lds	r24, 0x010C
     5e4:	99 27       	eor	r25, r25
     5e6:	00 97       	sbiw	r24, 0x00	; 0
     5e8:	09 f4       	brne	.+2      	; 0x5ec
     5ea:	96 c0       	rjmp	.+300    	; 0x718
     5ec:	02 97       	sbiw	r24, 0x02	; 2
     5ee:	09 f4       	brne	.+2      	; 0x5f2
     5f0:	58 c1       	rjmp	.+688    	; 0x8a2
     5f2:	10 92 0c 01 	sts	0x010C, r1
     5f6:	80 91 0d 01 	lds	r24, 0x010D
     5fa:	99 27       	eor	r25, r25
     5fc:	00 97       	sbiw	r24, 0x00	; 0
     5fe:	09 f4       	brne	.+2      	; 0x602
     600:	9c c0       	rjmp	.+312    	; 0x73a
     602:	02 97       	sbiw	r24, 0x02	; 2
     604:	09 f4       	brne	.+2      	; 0x608
     606:	69 c1       	rjmp	.+722    	; 0x8da
     608:	10 92 0d 01 	sts	0x010D, r1
     60c:	80 91 0e 01 	lds	r24, 0x010E
     610:	99 27       	eor	r25, r25
     612:	00 97       	sbiw	r24, 0x00	; 0
     614:	09 f4       	brne	.+2      	; 0x618
     616:	a3 c0       	rjmp	.+326    	; 0x75e
     618:	02 97       	sbiw	r24, 0x02	; 2
     61a:	09 f4       	brne	.+2      	; 0x61e
     61c:	26 c1       	rjmp	.+588    	; 0x86a
     61e:	10 92 0e 01 	sts	0x010E, r1
     622:	80 91 0f 01 	lds	r24, 0x010F
     626:	99 27       	eor	r25, r25
     628:	00 97       	sbiw	r24, 0x00	; 0
     62a:	09 f4       	brne	.+2      	; 0x62e
     62c:	aa c0       	rjmp	.+340    	; 0x782
     62e:	02 97       	sbiw	r24, 0x02	; 2
     630:	09 f4       	brne	.+2      	; 0x634
     632:	ff c0       	rjmp	.+510    	; 0x832
     634:	10 92 0f 01 	sts	0x010F, r1
     638:	80 91 10 01 	lds	r24, 0x0110
     63c:	99 27       	eor	r25, r25
     63e:	00 97       	sbiw	r24, 0x00	; 0
     640:	09 f4       	brne	.+2      	; 0x644
     642:	b1 c0       	rjmp	.+354    	; 0x7a6
     644:	02 97       	sbiw	r24, 0x02	; 2
     646:	09 f4       	brne	.+2      	; 0x64a
     648:	d8 c0       	rjmp	.+432    	; 0x7fa
     64a:	10 92 10 01 	sts	0x0110, r1
	uint8_t j;
	uint8_t processed;
	uint8_t matched;
	uint8_t k;

	//Receive & Unpack
		iris_xfr_receive(data0, data1);
	//Process Channels
		iris_byte_assembly(0);
		iris_byte_assembly(1);
		iris_byte_assembly(2);
		iris_byte_assembly(3);
		iris_byte_assembly(4);
		iris_byte_assembly(5);
		iris_byte_assembly(6);
		//iris_byte_assembly(7); //enable if you ever add the 7th channel
	//Check if any channels finished
i2c_enqueue(0x90); //xxx
     64e:	80 e9       	ldi	r24, 0x90	; 144
     650:	0e 94 79 05 	call	0xaf2
i2c_enqueue(out_direction); //xxx
     654:	80 91 1f 01 	lds	r24, 0x011F
     658:	0e 94 79 05 	call	0xaf2
		
		processed = out_direction;
     65c:	c0 91 1f 01 	lds	r28, 0x011F
		while (processed != 0x00){
tpl(ON); //xxx
			matched = 0x00;
			k = NUM__OF_CHANNELS+1;
			//somebody finished
			for(j=0;j<NUM__OF_CHANNELS;j++){
				if ((processed & _BV(j)) > 0){
					//channel j finished collecting data this cycle
					//check if other channels carry this data
					if (k > NUM__OF_CHANNELS){
						k = j; //lock data target
						matched |= _BV(k); //set bit for this channel in DIRECTION output
					}
					else {
						//found second or additional channel with the same data at the same time
						matched |= _BV(j); //set bit for this channel in DIRECTION output
					}
					processed &= ~(_BV(j)); //clear this channels bit to mark as seen
				}	
			}
			//enqueue matched data
			cli(); 	// CRITICAL SECTION!
					//		We mark this critical because it weighs on our analysis of the i2c
					//		outgoing data queue; Outgoing data is always two-byte aligned so we
					//		can use a mod2 function over the remaining bytes to be sent to infer
					//		that we are still in alignment.
				i2c_enqueue(matched);
				i2c_enqueue(p_data[k]);
			sei(); //END CRITICAL SECTION!
     660:	cc 23       	and	r28, r28
     662:	09 f4       	brne	.+2      	; 0x666
     664:	06 c2       	rjmp	.+1036   	; 0xa72
     666:	61 e0       	ldi	r22, 0x01	; 1
     668:	e6 2e       	mov	r14, r22
     66a:	f1 2c       	mov	r15, r1
     66c:	81 e0       	ldi	r24, 0x01	; 1
     66e:	0e 94 9e 00 	call	0x13c
     672:	70 e0       	ldi	r23, 0x00	; 0
     674:	18 e0       	ldi	r17, 0x08	; 8
     676:	67 2f       	mov	r22, r23
     678:	ac 2f       	mov	r26, r28
     67a:	bb 27       	eor	r27, r27
     67c:	46 2f       	mov	r20, r22
     67e:	55 27       	eor	r21, r21
     680:	97 01       	movw	r18, r14
     682:	04 2e       	mov	r0, r20
     684:	02 c0       	rjmp	.+4      	; 0x68a
     686:	22 0f       	add	r18, r18
     688:	33 1f       	adc	r19, r19
     68a:	0a 94       	dec	r0
     68c:	e2 f7       	brpl	.-8      	; 0x686
     68e:	a2 23       	and	r26, r18
     690:	b3 23       	and	r27, r19
     692:	1a 16       	cp	r1, r26
     694:	1b 06       	cpc	r1, r27
     696:	64 f4       	brge	.+24     	; 0x6b0
     698:	18 30       	cpi	r17, 0x08	; 8
     69a:	08 f0       	brcs	.+2      	; 0x69e
     69c:	16 2f       	mov	r17, r22
     69e:	72 2b       	or	r23, r18
     6a0:	c7 01       	movw	r24, r14
     6a2:	02 c0       	rjmp	.+4      	; 0x6a8
     6a4:	88 0f       	add	r24, r24
     6a6:	99 1f       	adc	r25, r25
     6a8:	4a 95       	dec	r20
     6aa:	e2 f7       	brpl	.-8      	; 0x6a4
     6ac:	80 95       	com	r24
     6ae:	c8 23       	and	r28, r24
     6b0:	6f 5f       	subi	r22, 0xFF	; 255
     6b2:	67 30       	cpi	r22, 0x07	; 7
     6b4:	08 f3       	brcs	.-62     	; 0x678
     6b6:	f8 94       	cli
     6b8:	87 2f       	mov	r24, r23
     6ba:	0e 94 79 05 	call	0xaf2
     6be:	e1 2f       	mov	r30, r17
     6c0:	ff 27       	eor	r31, r31
     6c2:	e8 5e       	subi	r30, 0xE8	; 232
     6c4:	fe 4f       	sbci	r31, 0xFE	; 254
     6c6:	80 81       	ld	r24, Z
     6c8:	0e 94 79 05 	call	0xaf2
     6cc:	78 94       	sei
     6ce:	cc 23       	and	r28, r28
     6d0:	69 f6       	brne	.-102    	; 0x66c
     6d2:	cf c1       	rjmp	.+926    	; 0xa72
     6d4:	23 30       	cpi	r18, 0x03	; 3
     6d6:	09 f0       	breq	.+2      	; 0x6da
     6d8:	77 cf       	rjmp	.-274    	; 0x5c8
     6da:	50 93 0a 01 	sts	0x010A, r21
     6de:	10 92 11 01 	sts	0x0111, r1
     6e2:	10 92 18 01 	sts	0x0118, r1
     6e6:	80 91 0b 01 	lds	r24, 0x010B
     6ea:	99 27       	eor	r25, r25
     6ec:	00 97       	sbiw	r24, 0x00	; 0
     6ee:	09 f0       	breq	.+2      	; 0x6f2
     6f0:	71 cf       	rjmp	.-286    	; 0x5d4
     6f2:	60 91 04 01 	lds	r22, 0x0104
     6f6:	63 30       	cpi	r22, 0x03	; 3
     6f8:	09 f0       	breq	.+2      	; 0x6fc
     6fa:	71 cf       	rjmp	.-286    	; 0x5de
     6fc:	a2 e0       	ldi	r26, 0x02	; 2
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
     a12:	90 e0       	ldi	r25, 0x00	; 0
     a14:	04 2e       	mov	r0, r20
     a16:	02 c0       	rjmp	.+4      	; 0xa1c
     a18:	95 95       	asr	r25
     a1a:	87 95       	ror	r24
     a1c:	0a 94       	dec	r0
     a1e:	e2 f7       	brpl	.-8      	; 0xa18
     a20:	10 91 1b 01 	lds	r17, 0x011B
     a24:	18 2b       	or	r17, r24
     a26:	10 93 1b 01 	sts	0x011B, r17
     a2a:	84 2f       	mov	r24, r20
     a2c:	66 cf       	rjmp	.-308    	; 0x8fa
     a2e:	c0 91 13 01 	lds	r28, 0x0113
     a32:	80 e8       	ldi	r24, 0x80	; 128
     a34:	90 e0       	ldi	r25, 0x00	; 0
     a36:	0c 2e       	mov	r0, r28
     a38:	02 c0       	rjmp	.+4      	; 0xa3e
     a3a:	95 95       	asr	r25
     a3c:	87 95       	ror	r24
     a3e:	0a 94       	dec	r0
     a40:	e2 f7       	brpl	.-8      	; 0xa3a
     a42:	e0 91 1a 01 	lds	r30, 0x011A
     a46:	e8 2b       	or	r30, r24
     a48:	e0 93 1a 01 	sts	0x011A, r30
     a4c:	8c 2f       	mov	r24, r28
     a4e:	39 cf       	rjmp	.-398    	; 0x8c2
     a50:	e0 90 15 01 	lds	r14, 0x0115
     a54:	80 e8       	ldi	r24, 0x80	; 128
     a56:	90 e0       	ldi	r25, 0x00	; 0
     a58:	0e 2c       	mov	r0, r14
     a5a:	02 c0       	rjmp	.+4      	; 0xa60
     a5c:	95 95       	asr	r25
     a5e:	87 95       	ror	r24
     a60:	0a 94       	dec	r0
     a62:	e2 f7       	brpl	.-8      	; 0xa5c
     a64:	60 91 1c 01 	lds	r22, 0x011C
     a68:	68 2b       	or	r22, r24
     a6a:	60 93 1c 01 	sts	0x011C, r22
     a6e:	8e 2d       	mov	r24, r14
     a70:	0c cf       	rjmp	.-488    	; 0x88a
		}
	//Cleanup and Reset
		out_direction = 0x00;			
     a72:	10 92 1f 01 	sts	0x011F, r1
     a76:	cf 91       	pop	r28
     a78:	1f 91       	pop	r17
     a7a:	ff 90       	pop	r15
     a7c:	ef 90       	pop	r14
     a7e:	08 95       	ret

00000a80 <init_i2c_buffer>:
//no protection is provided for buffer overflow! Be carefull!


void init_i2c_buffer(void){
	i2c_head = 0;
     a80:	10 92 2e 01 	sts	0x012E, r1
	i2c_tail = 0;
     a84:	10 92 2d 01 	sts	0x012D, r1
     a88:	08 95       	ret

00000a8a <init_i2c_ibuffer>:
}

inline uint8_t i2c_count(void){
	if (i2c_head >= i2c_tail){	
		return (i2c_head - i2c_tail);
	}
	else {
		return ((MAX_BUFFER_LEN-i2c_tail)+i2c_head);
	}
}

inline void i2c_enqueue(uint8_t datain){
	i2c_buffer[i2c_head] = datain;
	i2c_head++;
	if (i2c_head >= MAX_BUFFER_LEN){
		i2c_head = 0;
	}
}

inline uint8_t i2c_dequeue(void){
	uint8_t oldtail;
	oldtail = i2c_tail;
	i2c_tail++;
	if (i2c_tail >= MAX_BUFFER_LEN){
		i2c_tail = 0;
	}
	return i2c_buffer[oldtail];
}

//----------------------------------------------------------------
//- I2C INCOMING DATA QUEUE
//----------------------------------------------------------------

//insert from head
//read from tail
//the goal is to be fast (very fast) and light
//no protection is provided for buffer overflow! Be carefull!


void init_i2c_ibuffer(void){
	i2c_ihead = 0;
     a8a:	10 92 2c 01 	sts	0x012C, r1
	i2c_itail = 0;
     a8e:	10 92 20 01 	sts	0x0120, r1
     a92:	08 95       	ret

00000a94 <init_I2C>:
     a94:	40 e2       	ldi	r20, 0x20	; 32
     a96:	40 93 b8 00 	sts	0x00B8, r20
     a9a:	35 e4       	ldi	r19, 0x45	; 69
     a9c:	30 93 bc 00 	sts	0x00BC, r19
     aa0:	22 e5       	ldi	r18, 0x52	; 82
     aa2:	20 93 ba 00 	sts	0x00BA, r18
     aa6:	10 92 bd 00 	sts	0x00BD, r1
     aaa:	44 98       	cbi	0x08, 4	; 8
     aac:	45 98       	cbi	0x08, 5	; 8
     aae:	10 92 2e 01 	sts	0x012E, r1
     ab2:	10 92 2d 01 	sts	0x012D, r1
     ab6:	10 92 2c 01 	sts	0x012C, r1
     aba:	10 92 20 01 	sts	0x0120, r1
     abe:	81 e0       	ldi	r24, 0x01	; 1
     ac0:	80 93 21 01 	sts	0x0121, r24
     ac4:	08 95       	ret

00000ac6 <i2c_count>:
     ac6:	90 91 2e 01 	lds	r25, 0x012E
     aca:	80 91 2d 01 	lds	r24, 0x012D
     ace:	98 17       	cp	r25, r24
     ad0:	38 f0       	brcs	.+14     	; 0xae0
     ad2:	80 91 2e 01 	lds	r24, 0x012E
     ad6:	20 91 2d 01 	lds	r18, 0x012D
     ada:	82 1b       	sub	r24, r18
     adc:	99 27       	eor	r25, r25
     ade:	08 95       	ret
     ae0:	80 91 2e 01 	lds	r24, 0x012E
     ae4:	30 91 2d 01 	lds	r19, 0x012D
     ae8:	83 1b       	sub	r24, r19
     aea:	86 50       	subi	r24, 0x06	; 6
     aec:	99 27       	eor	r25, r25
     aee:	08 95       	ret
     af0:	08 95       	ret

00000af2 <i2c_enqueue>:
     af2:	30 91 2e 01 	lds	r19, 0x012E
     af6:	e3 2f       	mov	r30, r19
     af8:	ff 27       	eor	r31, r31
     afa:	e1 5d       	subi	r30, 0xD1	; 209
     afc:	fe 4f       	sbci	r31, 0xFE	; 254
     afe:	80 83       	st	Z, r24
     b00:	20 91 2e 01 	lds	r18, 0x012E
     b04:	2f 5f       	subi	r18, 0xFF	; 255
     b06:	20 93 2e 01 	sts	0x012E, r18
     b0a:	80 91 2e 01 	lds	r24, 0x012E
     b0e:	8a 3f       	cpi	r24, 0xFA	; 250
     b10:	10 f0       	brcs	.+4      	; 0xb16
     b12:	10 92 2e 01 	sts	0x012E, r1
     b16:	08 95       	ret
     b18:	08 95       	ret

00000b1a <i2c_dequeue>:
     b1a:	e0 91 2d 01 	lds	r30, 0x012D
     b1e:	20 91 2d 01 	lds	r18, 0x012D
     b22:	2f 5f       	subi	r18, 0xFF	; 255
     b24:	20 93 2d 01 	sts	0x012D, r18
     b28:	80 91 2d 01 	lds	r24, 0x012D
     b2c:	8a 3f       	cpi	r24, 0xFA	; 250
     b2e:	10 f0       	brcs	.+4      	; 0xb34
     b30:	10 92 2d 01 	sts	0x012D, r1
     b34:	ff 27       	eor	r31, r31
     b36:	e1 5d       	subi	r30, 0xD1	; 209
     b38:	fe 4f       	sbci	r31, 0xFE	; 254
     b3a:	80 81       	ld	r24, Z
     b3c:	99 27       	eor	r25, r25
     b3e:	08 95       	ret

00000b40 <i2c_icount>:
}

inline uint8_t i2c_icount(void){
	if (i2c_ihead >= i2c_itail){	
     b40:	90 91 2c 01 	lds	r25, 0x012C
     b44:	80 91 20 01 	lds	r24, 0x0120
     b48:	98 17       	cp	r25, r24
     b4a:	38 f0       	brcs	.+14     	; 0xb5a
		return (i2c_ihead - i2c_itail);
     b4c:	80 91 2c 01 	lds	r24, 0x012C
     b50:	20 91 20 01 	lds	r18, 0x0120
     b54:	82 1b       	sub	r24, r18
     b56:	99 27       	eor	r25, r25
     b58:	08 95       	ret
	}
	else {
		return ((MAX_IBUFFER_LEN-i2c_itail)+i2c_ihead);
     b5a:	80 91 2c 01 	lds	r24, 0x012C
     b5e:	30 91 20 01 	lds	r19, 0x0120
     b62:	83 1b       	sub	r24, r19
     b64:	86 5f       	subi	r24, 0xF6	; 246
     b66:	99 27       	eor	r25, r25
	}
}
     b68:	08 95       	ret
     b6a:	08 95       	ret

00000b6c <i2c_ienqueue>:

inline void i2c_ienqueue(uint8_t datain){
	i2c_ibuffer[i2c_ihead] = datain;
     b6c:	30 91 2c 01 	lds	r19, 0x012C
     b70:	e3 2f       	mov	r30, r19
     b72:	ff 27       	eor	r31, r31
     b74:	ee 5d       	subi	r30, 0xDE	; 222
     b76:	fe 4f       	sbci	r31, 0xFE	; 254
     b78:	80 83       	st	Z, r24
	i2c_ihead++;
     b7a:	20 91 2c 01 	lds	r18, 0x012C
     b7e:	2f 5f       	subi	r18, 0xFF	; 255
     b80:	20 93 2c 01 	sts	0x012C, r18
	if (i2c_ihead >= MAX_IBUFFER_LEN){
     b84:	80 91 2c 01 	lds	r24, 0x012C
     b88:	8a 30       	cpi	r24, 0x0A	; 10
     b8a:	10 f0       	brcs	.+4      	; 0xb90
		i2c_ihead = 0;
     b8c:	10 92 2c 01 	sts	0x012C, r1
     b90:	08 95       	ret
     b92:	08 95       	ret

00000b94 <i2c_idequeue>:
	}
}

inline uint8_t i2c_idequeue(void){
	uint8_t oldtail;
	oldtail = i2c_itail;
     b94:	e0 91 20 01 	lds	r30, 0x0120
	i2c_itail++;
     b98:	20 91 20 01 	lds	r18, 0x0120
     b9c:	2f 5f       	subi	r18, 0xFF	; 255
     b9e:	20 93 20 01 	sts	0x0120, r18
	if (i2c_itail >= MAX_IBUFFER_LEN){
     ba2:	80 91 20 01 	lds	r24, 0x0120
     ba6:	8a 30       	cpi	r24, 0x0A	; 10
     ba8:	10 f0       	brcs	.+4      	; 0xbae
		i2c_itail = 0;
     baa:	10 92 20 01 	sts	0x0120, r1
	}
	return i2c_ibuffer[oldtail];
     bae:	ff 27       	eor	r31, r31
     bb0:	ee 5d       	subi	r30, 0xDE	; 222
     bb2:	fe 4f       	sbci	r31, 0xFE	; 254
     bb4:	80 81       	ld	r24, Z
}
     bb6:	99 27       	eor	r25, r25
     bb8:	08 95       	ret

00000bba <I2C_send>:


//----------------------------------------------------------------
//- USER ROUTINES
//----------------------------------------------------------------

//sent in this order: ADDR, datain, datain2
inline void I2C_send(){
	//check for logical state is IDLE and stop condition from last attempt has completed transmission
	if (i2c_state == IDLE && ((TWCR & _BV(4)) == 0x00)){ 
     bba:	80 91 21 01 	lds	r24, 0x0121
     bbe:	81 30       	cpi	r24, 0x01	; 1
     bc0:	09 f0       	breq	.+2      	; 0xbc4
     bc2:	08 95       	ret
     bc4:	20 91 bc 00 	lds	r18, 0x00BC
     bc8:	24 fd       	sbrc	r18, 4
     bca:	fb cf       	rjmp	.-10     	; 0xbc2
		//TAKE CONTROL OF BUS	
			i2c_state = BUSY;
     bcc:	42 e0       	ldi	r20, 0x02	; 2
     bce:	40 93 21 01 	sts	0x0121, r20
			TWCR = B8(11100101); //send START on bus
     bd2:	35 ee       	ldi	r19, 0xE5	; 229
     bd4:	30 93 bc 00 	sts	0x00BC, r19
     bd8:	08 95       	ret
     bda:	08 95       	ret

00000bdc <__vector_24>:
	}	
}

//----------------------------------------------------------------
//- INTERRUPT SERVICE ROUTINES
//----------------------------------------------------------------

// we respond to general call and specific address call the same way
// we only make 1 attempt to receive the intended receiver 
//		located at (IRIS_REPORTING_ADDRESS).
SIGNAL(SIG_TWI){
     bdc:	1f 92       	push	r1
     bde:	0f 92       	push	r0
     be0:	0f b6       	in	r0, 0x3f	; 63
     be2:	0f 92       	push	r0
     be4:	11 24       	eor	r1, r1
     be6:	2f 93       	push	r18
     be8:	3f 93       	push	r19
     bea:	4f 93       	push	r20
     bec:	5f 93       	push	r21
     bee:	6f 93       	push	r22
     bf0:	7f 93       	push	r23
     bf2:	8f 93       	push	r24
     bf4:	9f 93       	push	r25
     bf6:	af 93       	push	r26
     bf8:	bf 93       	push	r27
     bfa:	ef 93       	push	r30
     bfc:	ff 93       	push	r31
	tp6(HIGH); //xxx
     bfe:	82 e0       	ldi	r24, 0x02	; 2
     c00:	0e 94 b4 00 	call	0x168
	/*
	//DEBUG!!!
		send_byte_serial('R');
		UART_send_HEX8(TWSR);
		send_byte_serial(10);
		send_byte_serial(13);
	//END DEBUG!!!
	*/
	
	
	
	//-------------------------
	//- I2C MASTER TRANSMIT
	//-------------------------
	
	if (TWSR == 0x08){
     c04:	80 91 b9 00 	lds	r24, 0x00B9
     c08:	88 30       	cpi	r24, 0x08	; 8
     c0a:	09 f4       	brne	.+2      	; 0xc0e
     c0c:	6e c0       	rjmp	.+220    	; 0xcea
		//finished transmitting a START condition; I am now master of the bus
		//write ADDR+W
		TWDR = ((IRIS_REPORTING_ADDRESS<<1) + WRITE);
		TWCR = B8(11000101);
	}
	
	else if (TWSR == 0x18 || TWSR == 0x28){
     c0e:	20 91 b9 00 	lds	r18, 0x00B9
     c12:	28 31       	cpi	r18, 0x18	; 24
     c14:	09 f4       	brne	.+2      	; 0xc18
     c16:	45 c0       	rjmp	.+138    	; 0xca2
     c18:	30 91 b9 00 	lds	r19, 0x00B9
     c1c:	38 32       	cpi	r19, 0x28	; 40
     c1e:	09 f4       	brne	.+2      	; 0xc22
     c20:	40 c0       	rjmp	.+128    	; 0xca2
		//address or data sent, received ACK
		if (i2c_count() > 0){
			TWDR = i2c_dequeue();
			TWCR = B8(11000101); //transmit the data
		}
		else {
			//although we received ACK we have nothing left to send!
			i2c_state = IDLE;
			TWCR = B8(11010101); //transmit the STOP condition (to release bus)
		}
	}
	
	else if (TWSR == 0x20){
     c22:	b0 91 b9 00 	lds	r27, 0x00B9
     c26:	b0 32       	cpi	r27, 0x20	; 32
     c28:	09 f4       	brne	.+2      	; 0xc2c
     c2a:	a1 c0       	rjmp	.+322    	; 0xd6e
		//address sent, received NACK
		//Throw data away (it will get old)
		if (i2c_count() >= 2){
			if (i2c_count() %2	== 1){
				i2c_dequeue();
			}
			else {
				i2c_dequeue();
				i2c_dequeue();
			}
		}
		//Transmit the STOP condition and release bus
			i2c_state = IDLE;
			TWCR = B8(11010101);			
	}
	else if (TWSR == 0x30){
     c2c:	a0 91 b9 00 	lds	r26, 0x00B9
     c30:	a0 33       	cpi	r26, 0x30	; 48
     c32:	09 f4       	brne	.+2      	; 0xc36
     c34:	6b c0       	rjmp	.+214    	; 0xd0c
		//data sent, received NACK
		
		//Are we finished? Then this is correct!
		if (i2c_count() == 0){
			//Transmit the STOP condition and release bus
			i2c_state = IDLE;
			TWCR = B8(11010101);	
		}
		
		//Error: NACK received, but we still have data to send!
		else {
			if (i2c_count() %2 == 1){
				//error! drop 1 byte to restore alignment
					i2c_dequeue();
			}
			//Transmit the STOP condition and release bus
				i2c_state = IDLE;
				TWCR = B8(11010101);	
		}
	}

	else if (TWSR == 0x38){
     c36:	70 91 b9 00 	lds	r23, 0x00B9
     c3a:	78 33       	cpi	r23, 0x38	; 56
     c3c:	09 f4       	brne	.+2      	; 0xc40
     c3e:	c7 c0       	rjmp	.+398    	; 0xdce
		//lost arbitration, give up!
		i2c_state = IDLE;
		TWCR = B8(11000101);
		
		//******************
		//* WRITE ME SOON!!!
		//******************
		//handle state = 0x68; lost arbitration because other master is talking to ME!!!
	}
	
	
	
	//-------------------------
	//- I2C SLAVE RECEIVE
	//-------------------------
	
	else if (TWSR == 0x60 || TWSR == 0x70){
     c40:	b0 91 b9 00 	lds	r27, 0x00B9
     c44:	b0 36       	cpi	r27, 0x60	; 96
     c46:	59 f1       	breq	.+86     	; 0xc9e
     c48:	e0 91 b9 00 	lds	r30, 0x00B9
     c4c:	e0 37       	cpi	r30, 0x70	; 112
     c4e:	39 f1       	breq	.+78     	; 0xc9e
		//general call or I'm specifically being addressed	
		TWCR = B8(11000101); //receive and ACK (commands are always 2-bytes fixed)
	}
	else if (TWSR == 0x80 || TWSR == 0x90){
     c50:	f0 91 b9 00 	lds	r31, 0x00B9
     c54:	f0 38       	cpi	r31, 0x80	; 128
     c56:	09 f4       	brne	.+2      	; 0xc5a
     c58:	d1 c0       	rjmp	.+418    	; 0xdfc
     c5a:	20 91 b9 00 	lds	r18, 0x00B9
     c5e:	20 39       	cpi	r18, 0x90	; 144
     c60:	09 f4       	brne	.+2      	; 0xc64
     c62:	cc c0       	rjmp	.+408    	; 0xdfc
		//received first byte	
		i2c_ienqueue(TWDR);
		//NACK incoming second byte to signal end of command
		TWCR = B8(10000101); //receive and NACK (commands are always 2-bytes fixed)
	}
	else if (TWSR == 0x88 || TWSR == 0x98){
     c64:	50 91 b9 00 	lds	r21, 0x00B9
     c68:	58 38       	cpi	r21, 0x88	; 136
     c6a:	29 f0       	breq	.+10     	; 0xc76
     c6c:	60 91 b9 00 	lds	r22, 0x00B9
     c70:	68 39       	cpi	r22, 0x98	; 152
     c72:	09 f0       	breq	.+2      	; 0xc76
     c74:	46 c0       	rjmp	.+140    	; 0xd02
     c76:	b0 91 bb 00 	lds	r27, 0x00BB
     c7a:	20 91 2c 01 	lds	r18, 0x012C
     c7e:	e2 2f       	mov	r30, r18
     c80:	ff 27       	eor	r31, r31
     c82:	ee 5d       	subi	r30, 0xDE	; 222
     c84:	fe 4f       	sbci	r31, 0xFE	; 254
     c86:	b0 83       	st	Z, r27
     c88:	a0 91 2c 01 	lds	r26, 0x012C
     c8c:	af 5f       	subi	r26, 0xFF	; 255
     c8e:	a0 93 2c 01 	sts	0x012C, r26
     c92:	70 91 2c 01 	lds	r23, 0x012C
     c96:	7a 30       	cpi	r23, 0x0A	; 10
     c98:	10 f0       	brcs	.+4      	; 0xc9e
     c9a:	10 92 2c 01 	sts	0x012C, r1
     c9e:	85 ec       	ldi	r24, 0xC5	; 197
     ca0:	ca c0       	rjmp	.+404    	; 0xe36
     ca2:	90 91 2e 01 	lds	r25, 0x012E
     ca6:	40 91 2d 01 	lds	r20, 0x012D
     caa:	94 17       	cp	r25, r20
     cac:	10 f5       	brcc	.+68     	; 0xcf2
     cae:	80 91 2e 01 	lds	r24, 0x012E
     cb2:	60 91 2d 01 	lds	r22, 0x012D
     cb6:	86 1b       	sub	r24, r22
     cb8:	86 50       	subi	r24, 0x06	; 6
     cba:	99 27       	eor	r25, r25
     cbc:	88 23       	and	r24, r24
     cbe:	09 f1       	breq	.+66     	; 0xd02
     cc0:	e0 91 2d 01 	lds	r30, 0x012D
     cc4:	a0 91 2d 01 	lds	r26, 0x012D
     cc8:	af 5f       	subi	r26, 0xFF	; 255
     cca:	a0 93 2d 01 	sts	0x012D, r26
     cce:	70 91 2d 01 	lds	r23, 0x012D
     cd2:	7a 3f       	cpi	r23, 0xFA	; 250
     cd4:	10 f0       	brcs	.+4      	; 0xcda
     cd6:	10 92 2d 01 	sts	0x012D, r1
     cda:	ff 27       	eor	r31, r31
     cdc:	e1 5d       	subi	r30, 0xD1	; 209
     cde:	fe 4f       	sbci	r31, 0xFE	; 254
     ce0:	80 81       	ld	r24, Z
     ce2:	99 27       	eor	r25, r25
     ce4:	80 93 bb 00 	sts	0x00BB, r24
     ce8:	da cf       	rjmp	.-76     	; 0xc9e
     cea:	80 e6       	ldi	r24, 0x60	; 96
     cec:	80 93 bb 00 	sts	0x00BB, r24
     cf0:	d6 cf       	rjmp	.-84     	; 0xc9e
     cf2:	80 91 2e 01 	lds	r24, 0x012E
     cf6:	50 91 2d 01 	lds	r21, 0x012D
     cfa:	85 1b       	sub	r24, r21
     cfc:	99 27       	eor	r25, r25
     cfe:	88 23       	and	r24, r24
     d00:	f9 f6       	brne	.-66     	; 0xcc0
		//receive second byte
		i2c_ienqueue(TWDR);
		//switch to the no-longer addressed slave mode (waiting on new bus transfer to address me)
		TWCR = B8(11000101);
	}
	else {
		//if error or unrecognized bus condition, abort current transfer and await next packet
		//switch to the no-longer addressed slave mode (waiting on new bus transfer to address me)
		i2c_state = IDLE;
     d02:	f1 e0       	ldi	r31, 0x01	; 1
     d04:	f0 93 21 01 	sts	0x0121, r31
		TWCR = B8(11010101);
     d08:	85 ed       	ldi	r24, 0xD5	; 213
     d0a:	95 c0       	rjmp	.+298    	; 0xe36
     d0c:	e0 91 2e 01 	lds	r30, 0x012E
     d10:	b0 91 2d 01 	lds	r27, 0x012D
     d14:	eb 17       	cp	r30, r27
     d16:	08 f0       	brcs	.+2      	; 0xd1a
     d18:	65 c0       	rjmp	.+202    	; 0xde4
     d1a:	80 91 2e 01 	lds	r24, 0x012E
     d1e:	20 91 2d 01 	lds	r18, 0x012D
     d22:	82 1b       	sub	r24, r18
     d24:	86 50       	subi	r24, 0x06	; 6
     d26:	99 27       	eor	r25, r25
     d28:	88 23       	and	r24, r24
     d2a:	59 f3       	breq	.-42     	; 0xd02
     d2c:	80 91 2e 01 	lds	r24, 0x012E
     d30:	30 91 2d 01 	lds	r19, 0x012D
     d34:	83 17       	cp	r24, r19
     d36:	08 f4       	brcc	.+2      	; 0xd3a
     d38:	77 c0       	rjmp	.+238    	; 0xe28
     d3a:	80 91 2e 01 	lds	r24, 0x012E
     d3e:	40 91 2d 01 	lds	r20, 0x012D
     d42:	84 1b       	sub	r24, r20
     d44:	99 27       	eor	r25, r25
     d46:	80 ff       	sbrs	r24, 0
     d48:	dc cf       	rjmp	.-72     	; 0xd02
     d4a:	e0 91 2d 01 	lds	r30, 0x012D
     d4e:	60 91 2d 01 	lds	r22, 0x012D
     d52:	6f 5f       	subi	r22, 0xFF	; 255
     d54:	60 93 2d 01 	sts	0x012D, r22
     d58:	50 91 2d 01 	lds	r21, 0x012D
     d5c:	5a 3f       	cpi	r21, 0xFA	; 250
     d5e:	10 f0       	brcs	.+4      	; 0xd64
     d60:	10 92 2d 01 	sts	0x012D, r1
     d64:	ff 27       	eor	r31, r31
     d66:	e1 5d       	subi	r30, 0xD1	; 209
     d68:	fe 4f       	sbci	r31, 0xFE	; 254
     d6a:	80 81       	ld	r24, Z
     d6c:	ca cf       	rjmp	.-108    	; 0xd02
     d6e:	f0 91 2e 01 	lds	r31, 0x012E
     d72:	e0 91 2d 01 	lds	r30, 0x012D
     d76:	fe 17       	cp	r31, r30
     d78:	70 f1       	brcs	.+92     	; 0xdd6
     d7a:	80 91 2e 01 	lds	r24, 0x012E
     d7e:	20 91 2d 01 	lds	r18, 0x012D
     d82:	82 1b       	sub	r24, r18
     d84:	99 27       	eor	r25, r25
     d86:	82 30       	cpi	r24, 0x02	; 2
     d88:	08 f4       	brcc	.+2      	; 0xd8c
     d8a:	bb cf       	rjmp	.-138    	; 0xd02
     d8c:	40 91 2e 01 	lds	r20, 0x012E
     d90:	80 91 2d 01 	lds	r24, 0x012D
     d94:	48 17       	cp	r20, r24
     d96:	60 f5       	brcc	.+88     	; 0xdf0
     d98:	80 91 2e 01 	lds	r24, 0x012E
     d9c:	50 91 2d 01 	lds	r21, 0x012D
     da0:	85 1b       	sub	r24, r21
     da2:	86 50       	subi	r24, 0x06	; 6
     da4:	99 27       	eor	r25, r25
     da6:	80 fd       	sbrc	r24, 0
     da8:	d0 cf       	rjmp	.-96     	; 0xd4a
     daa:	e0 91 2d 01 	lds	r30, 0x012D
     dae:	70 91 2d 01 	lds	r23, 0x012D
     db2:	7f 5f       	subi	r23, 0xFF	; 255
     db4:	70 93 2d 01 	sts	0x012D, r23
     db8:	60 91 2d 01 	lds	r22, 0x012D
     dbc:	6a 3f       	cpi	r22, 0xFA	; 250
     dbe:	10 f0       	brcs	.+4      	; 0xdc4
     dc0:	10 92 2d 01 	sts	0x012D, r1
     dc4:	ff 27       	eor	r31, r31
     dc6:	e1 5d       	subi	r30, 0xD1	; 209
     dc8:	fe 4f       	sbci	r31, 0xFE	; 254
     dca:	80 81       	ld	r24, Z
     dcc:	be cf       	rjmp	.-132    	; 0xd4a
     dce:	a1 e0       	ldi	r26, 0x01	; 1
     dd0:	a0 93 21 01 	sts	0x0121, r26
     dd4:	64 cf       	rjmp	.-312    	; 0xc9e
     dd6:	80 91 2e 01 	lds	r24, 0x012E
     dda:	30 91 2d 01 	lds	r19, 0x012D
     dde:	83 1b       	sub	r24, r19
     de0:	86 50       	subi	r24, 0x06	; 6
     de2:	d0 cf       	rjmp	.-96     	; 0xd84
     de4:	80 91 2e 01 	lds	r24, 0x012E
     de8:	f0 91 2d 01 	lds	r31, 0x012D
     dec:	8f 1b       	sub	r24, r31
     dee:	9b cf       	rjmp	.-202    	; 0xd26
     df0:	80 91 2e 01 	lds	r24, 0x012E
     df4:	90 91 2d 01 	lds	r25, 0x012D
     df8:	89 1b       	sub	r24, r25
     dfa:	d4 cf       	rjmp	.-88     	; 0xda4
     dfc:	40 91 bb 00 	lds	r20, 0x00BB
     e00:	90 91 2c 01 	lds	r25, 0x012C
     e04:	e9 2f       	mov	r30, r25
     e06:	ff 27       	eor	r31, r31
     e08:	ee 5d       	subi	r30, 0xDE	; 222
     e0a:	fe 4f       	sbci	r31, 0xFE	; 254
     e0c:	40 83       	st	Z, r20
     e0e:	80 91 2c 01 	lds	r24, 0x012C
     e12:	8f 5f       	subi	r24, 0xFF	; 255
     e14:	80 93 2c 01 	sts	0x012C, r24
     e18:	30 91 2c 01 	lds	r19, 0x012C
     e1c:	3a 30       	cpi	r19, 0x0A	; 10
     e1e:	10 f0       	brcs	.+4      	; 0xe24
     e20:	10 92 2c 01 	sts	0x012C, r1
     e24:	85 e8       	ldi	r24, 0x85	; 133
     e26:	07 c0       	rjmp	.+14     	; 0xe36
     e28:	80 91 2e 01 	lds	r24, 0x012E
     e2c:	90 91 2d 01 	lds	r25, 0x012D
     e30:	89 1b       	sub	r24, r25
     e32:	86 50       	subi	r24, 0x06	; 6
     e34:	87 cf       	rjmp	.-242    	; 0xd44
     e36:	80 93 bc 00 	sts	0x00BC, r24
	}	
	
	tp6(LOW); //xxx
     e3a:	84 e0       	ldi	r24, 0x04	; 4
     e3c:	0e 94 b4 00 	call	0x168
     e40:	ff 91       	pop	r31
     e42:	ef 91       	pop	r30
     e44:	bf 91       	pop	r27
     e46:	af 91       	pop	r26
     e48:	9f 91       	pop	r25
     e4a:	8f 91       	pop	r24
     e4c:	7f 91       	pop	r23
     e4e:	6f 91       	pop	r22
     e50:	5f 91       	pop	r21
     e52:	4f 91       	pop	r20
     e54:	3f 91       	pop	r19
     e56:	2f 91       	pop	r18
     e58:	0f 90       	pop	r0
     e5a:	0f be       	out	0x3f, r0	; 63
     e5c:	0f 90       	pop	r0
     e5e:	1f 90       	pop	r1
     e60:	18 95       	reti

00000e62 <init_serial>:
//= IRIS LOWER PROCESSOR
//==================================

void init_serial(uint8_t mode){
	switch (mode){
     e62:	8d 30       	cpi	r24, 0x0D	; 13
     e64:	89 f0       	breq	.+34     	; 0xe88
		case(RUN_MODE):
			// USRT initialization (RX ONLY)
			UCSR0A=0x02;//just flags in this register; Double-speed mode ON!
			UCSR0C=B8(00000110);//ASYNCHRONOUS; N,8-bit data,1 frame format; Clock polarity = data delta on rising, sample on falling edge
			UBRR0H=0x00;
			UBRR0L=0; //ignored since we are synchronous receiver (use clock rate from master)
			sbi(DDRD,1); //TXD is output pin (data line)
			cbi(DDRD,0); //RXD is input pin (data line)
			cbi(DDRD,4); //XCK is INPUT pin (USRT clock line)
			usrt_rx_count = 0;
			UCSR0B=B8(10010000);//Rx enabled; interrupt on RX enabled; no TX  - last line because operation begins on this flag		
			break;
		case(DEBUG_MODE):	
		default:
			// UART initialization (TX ONLY)
			UCSR0A=0x00;//just flags in this register
     e66:	10 92 c0 00 	sts	0x00C0, r1
			UCSR0C=B8(01000110);//SYNCHRONOUS (but ignore clock line because less error at BRG); N,8-bit data,1 frame format
     e6a:	46 e4       	ldi	r20, 0x46	; 70
     e6c:	40 93 c2 00 	sts	0x00C2, r20
			UBRR0H = 0;
     e70:	10 92 c5 00 	sts	0x00C5, r1
			UBRR0L = 68; //115.2k bps from 16MHz clock
     e74:	34 e4       	ldi	r19, 0x44	; 68
     e76:	30 93 c4 00 	sts	0x00C4, r19
			sbi(DDRD,1); //TXD is output pin (data line)
     e7a:	51 9a       	sbi	0x0a, 1	; 10
			cbi(DDRD,4); //XCK is not used so make input (with pull-up) for safety (USRT clock line)
     e7c:	54 98       	cbi	0x0a, 4	; 10
			sbi(PORTD, 4);
     e7e:	5c 9a       	sbi	0x0b, 4	; 11
			UCSR0B=0x08;//No Rx; TX enabled - last line because operation begins on this flag
     e80:	88 e0       	ldi	r24, 0x08	; 8
     e82:	80 93 c1 00 	sts	0x00C1, r24
     e86:	08 95       	ret
     e88:	22 e0       	ldi	r18, 0x02	; 2
     e8a:	20 93 c0 00 	sts	0x00C0, r18
     e8e:	86 e0       	ldi	r24, 0x06	; 6
     e90:	80 93 c2 00 	sts	0x00C2, r24
     e94:	10 92 c5 00 	sts	0x00C5, r1
     e98:	10 92 c4 00 	sts	0x00C4, r1
     e9c:	51 9a       	sbi	0x0a, 1	; 10
     e9e:	50 98       	cbi	0x0a, 0	; 10
     ea0:	54 98       	cbi	0x0a, 4	; 10
     ea2:	10 92 29 02 	sts	0x0229, r1
     ea6:	80 e9       	ldi	r24, 0x90	; 144
     ea8:	80 93 c1 00 	sts	0x00C1, r24
     eac:	08 95       	ret
     eae:	08 95       	ret

00000eb0 <USRT_send_2bytes>:
			break;
	}
}

//dataA is sent first
//this function built for speed, no safety checking. UART shift and buffer registers should be empty.
//The first write falls through to the actual output register freeing the buffer for byte 2.
void inline USRT_send_2bytes(unsigned char dataA, unsigned char dataB){
	// XXX
	UDR0 = dataA;
     eb0:	80 93 c6 00 	sts	0x00C6, r24
	UDR0 = dataB;
     eb4:	60 93 c6 00 	sts	0x00C6, r22
     eb8:	08 95       	ret

00000eba <send_byte_serial>:
	/*
	//DEBUG code to test the buffer ready for new data flag
	if(UCSR0A & B8(00100000)){ //true != 0, freeze on buffer avail
		stk_ledon(0xAA);
		while(1);
	}
	*/
}

void inline send_byte_serial(unsigned char dataB){
     eba:	48 2f       	mov	r20, r24
     ebc:	21 e0       	ldi	r18, 0x01	; 1
     ebe:	30 e0       	ldi	r19, 0x00	; 0
	while ((UCSR0A & _BV(5)) != B8(00100000));
     ec0:	80 91 c0 00 	lds	r24, 0x00C0
     ec4:	99 27       	eor	r25, r25
     ec6:	96 95       	lsr	r25
     ec8:	87 95       	ror	r24
     eca:	92 95       	swap	r25
     ecc:	82 95       	swap	r24
     ece:	8f 70       	andi	r24, 0x0F	; 15
     ed0:	89 27       	eor	r24, r25
     ed2:	9f 70       	andi	r25, 0x0F	; 15
     ed4:	89 27       	eor	r24, r25
     ed6:	81 70       	andi	r24, 0x01	; 1
     ed8:	90 70       	andi	r25, 0x00	; 0
     eda:	82 17       	cp	r24, r18
     edc:	93 07       	cpc	r25, r19
     ede:	81 f7       	brne	.-32     	; 0xec0
	UDR0 = dataB;
     ee0:	40 93 c6 00 	sts	0x00C6, r20
     ee4:	08 95       	ret

00000ee6 <uart0_force_byte>:
}

void inline uart0_force_byte(unsigned char dataB){
	UDR0 = dataB;
     ee6:	80 93 c6 00 	sts	0x00C6, r24
     eea:	08 95       	ret

00000eec <UART_send_BIN4>:
}
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
