nesl/ragobots/robot/sw/code/IRMAN/motor.c

/*
  #################################################################################
  # RAGOBOT:IRMAN MOTOR CONTROLLER PROGRAM
  # ------------------------------------------------------------------------------
  # Controls motor drive and direction
  # 
  # APPLIES TO (Ragobot Part Numbers):
  # ------------------------------------------------------------------------------
  # RBTBDYB
  #
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
  # DEVELOPED BY
  # ------------------------------------------------------------------------------
  # Jonathan Friedman, GSR
  # Networked and Embedded Systems Laboratory (NESL)
  # University of California, Los Angeles (UCLA)
  #
  # REVISION HISTORY
  # ------------------------------------------------------------------------------
  # <see CVS for additional comments and dates of revisions> 
  # Original by Jonathan Friedman, UCLA (jf@ee.ucla.edu)
  #################################################################################
*/

#include <inttypes.h>
#include <avr/io.h>
#include <avr/interrupt.h>
#include <avr/signal.h>
#include "irman.h"
#include "i2c.h"
#include "utilities.h"
#include "motor.h"
#include "ircomm.h"

// Declare your global variables here

void init_motor(){
  //  sbi(DDRD,5); //PWM
  //  sbi(DDRD,6);	
  //  sbi(DDRB,0); //DIR
  //  sbi(DDRB,1);	
  //set for phase correct mode
  cbi(TCCR0A, 1);
  sbi(TCCR0A, 0);
}

void i2c_parse()
{
  uint8_t pkt;
  uint8_t command;
  HAS_CRITICAL_SECTION;

  ENTER_CRITICAL_SECTION();
  pkt = i2c_buffer;
  i2c_buffer = 0xFF; //reset the i2c buffer.
  LEAVE_CRITICAL_SECTION();
  command = pkt & 0xC0; //extract the command from the i2c packet
  // if the i2c packet is 0xFF, then it is not valid and do nothing
  
  if (pkt == 0xFF)
    {
      return;
    }
  switch (command)
    {
    case 0x00: //motor command type
      {
	move ( ((pkt & B8(00111000))>>3), (pkt & B8(00000111)) );
	break;
      }
    case 0x40: //blue led command 
      {
	if ((pkt & 0x01) == 0x00) //turn off blue led
	  {
	    //blue_led_off();
	    testled_off();
	  }
	else //turn on blue led
	  {
	    //blue_led_on();
	    testled_on();
	  }
	if ((pkt & 0x20) == 0x00) //turn off IRED
	  {
	    //ired_led_off();
	  }
	else //turn on IRED 
	  {
	    //ired_led_on();
	  }
	break;
      }
    case 0x80: //ir system command
      {
	/* To be added */
	if((pkt & 0x01) == 0x01) //calibrate ircliff
	  {
	    ircliff_calibrate();
	  }
	break;
      }
  } 
}

void move(uint8_t left, uint8_t right)
{ 
  switch (left)
    {  //for LEFT case
    case (M_FWD1):
      //set direction
      sbi(M_DIR_PORT, M_DIR0);
      //set PWM rate
      OCR0A = set_speed(M_SPD1);
      //enable PWM output
      M_PWM_OUTL_ENABLE;
      break;	
    case (M_FWD2):
      //set direction
      sbi(M_DIR_PORT, M_DIR0);
      //set PWM rate
      OCR0A = set_speed(M_SPD2);
      //enable PWM output
      M_PWM_OUTL_ENABLE;
      break;
    case (M_FWD3):
      //set direction
      sbi(M_DIR_PORT, M_DIR0);
      //set PWM rate
      OCR0A = set_speed(M_SPD3);
      //enable PWM output
      M_PWM_OUTL_ENABLE;
      break;
    case (M_FWD4):
      //set direction
      sbi(M_DIR_PORT, M_DIR0);
      //set PWM rate
      OCR0A = set_speed(M_SPD4);
      //enable PWM output
      M_PWM_OUTL_ENABLE;
      break;
    case (M_REV1):
      //set direction
      cbi(M_DIR_PORT, M_DIR0);
      //set PWM rate
      OCR0A = set_speed(M_SPD1);
      //enable PWM output
      M_PWM_OUTL_ENABLE;
      break;	
    case (M_REV3):
      //set direction
      cbi(M_DIR_PORT, M_DIR0);
      //set PWM rate
      OCR0A = set_speed(M_SPD3);
      //enable PWM output
      M_PWM_OUTL_ENABLE;
      break;	
    case (M_REV4):
      //set direction
      cbi(M_DIR_PORT, M_DIR0);
      //set PWM rate
      OCR0A = set_speed(M_SPD4);
      //enable PWM output
      M_PWM_OUTL_ENABLE;
      break;
    case (M_STOP):
      //disable PWM output
      M_PWM_OUTL_DISABLE;
      //force pin to stop
      sbi(M_PWM_PORT, M_PWM0);
      break;	
    }		
  //in RIGHT case for movement ones add:
  // TCCR0B = M_PWM_EN;
  switch (right)
    {  //for RIGHT case
    case (M_FWD1):
      //set direction
      sbi(M_DIR_PORT, M_DIR1);
      //set PWM rate
      OCR0B = set_speed(M_SPD1);
      //enable PWM output
      M_PWM_OUTR_ENABLE;
      break;	
    case (M_FWD2):
      //set direction
      sbi(M_DIR_PORT, M_DIR1);
      //set PWM rate
      OCR0B = set_speed(M_SPD2);
      //enable PWM output
      M_PWM_OUTR_ENABLE;
      break;
    case (M_FWD3):
      //set direction
      sbi(M_DIR_PORT, M_DIR1);
      //set PWM rate
      OCR0B = set_speed(M_SPD3);
      //enable PWM output
      M_PWM_OUTR_ENABLE;
      break;
    case (M_FWD4):
      //set direction
      sbi(M_DIR_PORT, M_DIR1);
      //set PWM rate
      OCR0B = set_speed(M_SPD4);
      //enable PWM output
      M_PWM_OUTR_ENABLE;
      break;
    case (M_REV1):
      //set direction
      cbi(M_DIR_PORT, M_DIR1);
      //set PWM rate
      OCR0B = set_speed(M_SPD1);
      //enable PWM output
      M_PWM_OUTR_ENABLE;
      break;	
    case (M_REV3):
      //set direction
      cbi(M_DIR_PORT, M_DIR1);
      //set PWM rate
      OCR0B = set_speed(M_SPD3);
      //enable PWM output
      M_PWM_OUTR_ENABLE;
      break;	
    case (M_REV4):
      //set direction
      cbi(M_DIR_PORT, M_DIR1);
      //set PWM rate
      OCR0B = set_speed(M_SPD4);
      //enable PWM output
      M_PWM_OUTR_ENABLE;
      break;	
    case (M_STOP):
      //disable PWM output
      M_PWM_OUTR_DISABLE;
      if (bit_is_clear(TCCR0A, 7)) 
	{
	  M_PWM_DISABLE;
	}						
      //force pin to stop
      sbi(M_PWM_PORT, M_PWM1);
      break;
    }

  if ((left == M_STOP) && (right == M_STOP))
    {
      robot_state = ROBOT_STOP;
      ircliff_off();
    }
  else 
    {
      robot_state = ROBOT_MOVE;
      ircliff_medium();
    }
}
