nesl/ragobots/robot/sw/code/IRIS/UPPER/iris_u.asm

iris_u.elf:     file format elf32-avr

Sections:
Idx Name          Size      VMA       LMA       File off  Algn
  0 .data         00000000  00800100  0000145a  000014ee  2**0
                  CONTENTS, ALLOC, LOAD, DATA
  1 .text         0000145a  00000000  00000000  00000094  2**0
                  CONTENTS, ALLOC, LOAD, READONLY, CODE
  2 .bss          00000013  00800100  00800100  000014ee  2**0
                  ALLOC
  3 .noinit       00000000  00800113  00800113  000014ee  2**0
                  CONTENTS
  4 .eeprom       00000000  00810000  00810000  000014ee  2**0
                  CONTENTS
  5 .debug_aranges 00000050  00000000  00000000  000014ee  2**0
                  CONTENTS, READONLY, DEBUGGING
  6 .debug_pubnames 00000226  00000000  00000000  0000153e  2**0
                  CONTENTS, READONLY, DEBUGGING
  7 .debug_info   00000ecb  00000000  00000000  00001764  2**0
                  CONTENTS, READONLY, DEBUGGING
  8 .debug_abbrev 000003cc  00000000  00000000  0000262f  2**0
                  CONTENTS, READONLY, DEBUGGING
  9 .debug_line   00000b20  00000000  00000000  000029fb  2**0
                  CONTENTS, READONLY, DEBUGGING
 10 .debug_str    0000028c  00000000  00000000  0000351b  2**0
                  CONTENTS, READONLY, DEBUGGING
Disassembly of section .text:

00000000 <__vectors>:
       0:	0c 94 34 00 	jmp	0x68
       4:	0c 94 4f 00 	jmp	0x9e
       8:	0c 94 4f 00 	jmp	0x9e
       c:	0c 94 4f 00 	jmp	0x9e
      10:	0c 94 4f 00 	jmp	0x9e
      14:	0c 94 4f 00 	jmp	0x9e
      18:	0c 94 4f 00 	jmp	0x9e
      1c:	0c 94 4f 00 	jmp	0x9e
      20:	0c 94 4f 00 	jmp	0x9e
      24:	0c 94 4f 00 	jmp	0x9e
      28:	0c 94 4f 00 	jmp	0x9e
      2c:	0c 94 4f 00 	jmp	0x9e
      30:	0c 94 4f 00 	jmp	0x9e
      34:	0c 94 4f 00 	jmp	0x9e
      38:	0c 94 4f 00 	jmp	0x9e
      3c:	0c 94 4f 00 	jmp	0x9e
      40:	0c 94 4f 00 	jmp	0x9e
      44:	0c 94 4f 00 	jmp	0x9e
      48:	0c 94 4f 00 	jmp	0x9e
      4c:	0c 94 4f 00 	jmp	0x9e
      50:	0c 94 4f 00 	jmp	0x9e
      54:	0c 94 4f 00 	jmp	0x9e
      58:	0c 94 4f 00 	jmp	0x9e
      5c:	0c 94 4f 00 	jmp	0x9e
      60:	0c 94 4f 00 	jmp	0x9e
      64:	0c 94 4f 00 	jmp	0x9e

00000068 <__ctors_end>:
      68:	11 24       	eor	r1, r1
      6a:	1f be       	out	0x3f, r1	; 63
      6c:	cf ef       	ldi	r28, 0xFF	; 255
      6e:	d4 e0       	ldi	r29, 0x04	; 4
      70:	de bf       	out	0x3e, r29	; 62
      72:	cd bf       	out	0x3d, r28	; 61

00000074 <__do_copy_data>:
      74:	11 e0       	ldi	r17, 0x01	; 1
      76:	a0 e0       	ldi	r26, 0x00	; 0
      78:	b1 e0       	ldi	r27, 0x01	; 1
      7a:	ea e5       	ldi	r30, 0x5A	; 90
      7c:	f4 e1       	ldi	r31, 0x14	; 20
      7e:	02 c0       	rjmp	.+4      	; 0x84

00000080 <.do_copy_data_loop>:
      80:	05 90       	lpm	r0, Z+
      82:	0d 92       	st	X+, r0

00000084 <.do_copy_data_start>:
      84:	a0 30       	cpi	r26, 0x00	; 0
      86:	b1 07       	cpc	r27, r17
      88:	d9 f7       	brne	.-10     	; 0x80

0000008a <__do_clear_bss>:
      8a:	11 e0       	ldi	r17, 0x01	; 1
      8c:	a0 e0       	ldi	r26, 0x00	; 0
      8e:	b1 e0       	ldi	r27, 0x01	; 1
      90:	01 c0       	rjmp	.+2      	; 0x94

00000092 <.do_clear_bss_loop>:
      92:	1d 92       	st	X+, r1

00000094 <.do_clear_bss_start>:
      94:	a3 31       	cpi	r26, 0x13	; 19
      96:	b1 07       	cpc	r27, r17
      98:	e1 f7       	brne	.-8      	; 0x92
      9a:	0c 94 76 00 	jmp	0xec

0000009e <__bad_interrupt>:
      9e:	0c 94 00 00 	jmp	0x0

000000a2 <init_mcu>:
//----------------------------------------------------------------

void init_mcu(void) {
	// Input/Output Ports initialization
  		sbi(DDRB, 1); //IRIS_LED1 as ouput
      a2:	21 9a       	sbi	0x04, 1	; 4
		DDRB = B8(10010110); //DNC pins are outputs; 
      a4:	26 e9       	ldi	r18, 0x96	; 150
      a6:	24 b9       	out	0x04, r18	; 4
		sbi(PORTB, 5); //enable pull-up resistor on PGM_CLK input
      a8:	2d 9a       	sbi	0x05, 5	; 5
						//xxx check if there is a master pull-up enable or something that needs to be turned on
		//PORTC init is controlled by iris_init() in ircomm.c
		DDRD = B8(11111010); //DNC pins are outputs; TP are outputs; IRIS_CTRL is input
      aa:	8a ef       	ldi	r24, 0xFA	; 250
      ac:	8a b9       	out	0x0a, r24	; 10
		sbi(PORTD, 2); //enable pull-up resistor on IRIS_CTRL
      ae:	5a 9a       	sbi	0x0b, 2	; 11
      b0:	08 95       	ret

000000b2 <init_clock>:
		
} //init_MCU

//Configures 16-bit timer and starts it running; non-interrupt mode of operation
void init_clock(void){
	TCCR1A = B8(00000000);	
      b2:	10 92 80 00 	sts	0x0080, r1
	TCCR1B = B8(00001001);
      b6:	39 e0       	ldi	r19, 0x09	; 9
      b8:	30 93 81 00 	sts	0x0081, r19
	TCCR1C = B8(00000000);
      bc:	10 92 82 00 	sts	0x0082, r1
	OCR1AH = 0x03; //number of 16MHz cycles to run the timer for before interrupt flag is set
      c0:	23 e0       	ldi	r18, 0x03	; 3
      c2:	20 93 89 00 	sts	0x0089, r18
	OCR1AL = 0x80; //d640 = 40uS period
      c6:	80 e8       	ldi	r24, 0x80	; 128
      c8:	80 93 88 00 	sts	0x0088, r24
      cc:	08 95       	ret

000000ce <stall>:
}

void stall(uint16_t limit){
  uint16_t blah, i, j;
  blah=0;
      ce:	40 e0       	ldi	r20, 0x00	; 0
      d0:	50 e0       	ldi	r21, 0x00	; 0
  for(i=0;i<0xFFFF;i++){
    for(j=0;j<limit;j++){
      d2:	00 97       	sbiw	r24, 0x00	; 0
      d4:	21 f0       	breq	.+8      	; 0xde
      d6:	9c 01       	movw	r18, r24
      d8:	21 50       	subi	r18, 0x01	; 1
      da:	30 40       	sbci	r19, 0x00	; 0
      dc:	e9 f7       	brne	.-6      	; 0xd8
      de:	4f 5f       	subi	r20, 0xFF	; 255
      e0:	5f 4f       	sbci	r21, 0xFF	; 255
      e2:	2f ef       	ldi	r18, 0xFF	; 255
      e4:	4f 3f       	cpi	r20, 0xFF	; 255
      e6:	52 07       	cpc	r21, r18
      e8:	a1 f7       	brne	.-24     	; 0xd2
      ea:	08 95       	ret

000000ec <main>:
      blah++;
    }
  }	
}



//----------------------------------------------------------------
//- MAIN PROGRAM
//----------------------------------------------------------------

int main(void){
      ec:	cf ef       	ldi	r28, 0xFF	; 255
      ee:	d4 e0       	ldi	r29, 0x04	; 4
      f0:	de bf       	out	0x3e, r29	; 62
      f2:	cd bf       	out	0x3d, r28	; 61
	//VAR
		uint8_t xfr_timer;
	//INIT
		cli(); //disable interrupts (in case function is called multiple times)
      f4:	f8 94       	cli
		init_tp();
      f6:	0e 94 e7 09 	call	0x13ce
      fa:	21 9a       	sbi	0x04, 1	; 4
      fc:	56 e9       	ldi	r21, 0x96	; 150
      fe:	54 b9       	out	0x04, r21	; 4
     100:	2d 9a       	sbi	0x05, 5	; 5
     102:	4a ef       	ldi	r20, 0xFA	; 250
     104:	4a b9       	out	0x0a, r20	; 10
     106:	5a 9a       	sbi	0x0b, 2	; 11
		init_mcu();
		init_air();
     108:	0e 94 e6 00 	call	0x1cc
		init_iris();
     10c:	0e 94 f4 00 	call	0x1e8
		init_serial(USRT);
     110:	8d e0       	ldi	r24, 0x0D	; 13
     112:	0e 94 4c 02 	call	0x498
     116:	10 92 80 00 	sts	0x0080, r1
     11a:	39 e0       	ldi	r19, 0x09	; 9
     11c:	30 93 81 00 	sts	0x0081, r19
     120:	10 92 82 00 	sts	0x0082, r1
     124:	23 e0       	ldi	r18, 0x03	; 3
     126:	20 93 89 00 	sts	0x0089, r18
     12a:	80 e8       	ldi	r24, 0x80	; 128
     12c:	80 93 88 00 	sts	0x0088, r24
		init_clock();
		tpl(OFF); //debug led off		
     130:	82 e0       	ldi	r24, 0x02	; 2
     132:	0e 94 eb 09 	call	0x13d6
		sbi(TIFR1, 1); //reset clock interrupt
     136:	b1 9a       	sbi	0x16, 1	; 22
		xfr_timer = 0;
     138:	c0 e0       	ldi	r28, 0x00	; 0
     13a:	80 e0       	ldi	r24, 0x00	; 0
     13c:	90 e0       	ldi	r25, 0x00	; 0
     13e:	01 96       	adiw	r24, 0x01	; 1
     140:	2f ef       	ldi	r18, 0xFF	; 255
     142:	8f 3f       	cpi	r24, 0xFF	; 255
     144:	92 07       	cpc	r25, r18
     146:	d9 f7       	brne	.-10     	; 0x13e

	//WAIT FOR IRISL TO BOOT
		stall(3); //let pull-up resistor have some time to charge the input
		while(PIND & _BV(2) == 0x00); //wait for IRISL to boot up
     148:	89 b1       	in	r24, 0x09	; 9
		
	//PGM	
	  	while(1){ 	
		  	//Timing loop indicator
		  		tp5(HIGH); //RTOS timing indicator xxx
     14a:	81 e0       	ldi	r24, 0x01	; 1
     14c:	0e 94 17 0a 	call	0x142e
			//Wait for arriving bytes
		  		air_get_channels();
     150:	0e 94 f7 00 	call	0x1ee
		  		/*
		  		if (get_air_capture() != 0x00) {
			  		UART_send_BIN8(get_air_capture());
					send_byte_serial(10);
			  		send_byte_serial(13);
		  		}
		  		*/
		  		//DEBUG: CLONE CHANNEL TO EXTRAPOLATE WORST CASE PROCESSING SCENARIO
		  		/*
		  		if ((get_air_capture() & B8(00100000)) == 0x00){
			  		set_air_capture(0x00);	
		  		}
		  		else {
			  		set_air_capture(0xFF);
		  		}
		  		*/
		  		set_air_capture(0x00);
     154:	80 e0       	ldi	r24, 0x00	; 0
     156:	0e 94 0b 01 	call	0x216
		  		
		  	//Process each new symbol through its channel machine
				air_proc_channel(0);//0
     15a:	80 e0       	ldi	r24, 0x00	; 0
     15c:	0e 94 36 01 	call	0x26c
				air_proc_channel(1);//1
     160:	81 e0       	ldi	r24, 0x01	; 1
     162:	0e 94 36 01 	call	0x26c
				air_proc_channel(2);//2
     166:	82 e0       	ldi	r24, 0x02	; 2
     168:	0e 94 36 01 	call	0x26c
				air_proc_channel(3);//3
     16c:	83 e0       	ldi	r24, 0x03	; 3
     16e:	0e 94 36 01 	call	0x26c
				air_proc_channel(4);//4
     172:	84 e0       	ldi	r24, 0x04	; 4
     174:	0e 94 36 01 	call	0x26c
				air_proc_channel(5);//5
     178:	85 e0       	ldi	r24, 0x05	; 5
     17a:	0e 94 36 01 	call	0x26c
				air_proc_channel(6);//6
     17e:	86 e0       	ldi	r24, 0x06	; 6
     180:	0e 94 36 01 	call	0x26c
			
			//Manage the XFR queue (to IRISL)
				xfr_timer++;
     184:	cf 5f       	subi	r28, 0xFF	; 255
				//1000uS period over 56uS interval = 17 (952uS)
				//PIND.2 is a control line from IRISL effectively implementing flow control.
				if (xfr_timer >= 17 && ((PIND & _BV(2)) > 0)){ 
     186:	c1 31       	cpi	r28, 0x11	; 17
     188:	28 f0       	brcs	.+10     	; 0x194
     18a:	4a 9b       	sbis	0x09, 2	; 9
     18c:	03 c0       	rjmp	.+6      	; 0x194
					xfr_timer = 0;
     18e:	c0 e0       	ldi	r28, 0x00	; 0
					//transfer_sym();	
					transfer_sym_debug();	
     190:	0e 94 f9 01 	call	0x3f2
				}
				
				//debug_transfer_sym();
				//tpl(TOGGLE);	
				
			//Close timing loop
				tp5(LOW); //RTOS timing indicator xxx
     194:	82 e0       	ldi	r24, 0x02	; 2
     196:	0e 94 17 0a 	call	0x142e
     19a:	21 e0       	ldi	r18, 0x01	; 1
     19c:	30 e0       	ldi	r19, 0x00	; 0
				
			//Constant sample time
				while((TIFR1 & 2) == 0x00);
     19e:	86 b3       	in	r24, 0x16	; 22
     1a0:	99 27       	eor	r25, r25
     1a2:	96 95       	lsr	r25
     1a4:	87 95       	ror	r24
     1a6:	81 70       	andi	r24, 0x01	; 1
     1a8:	90 70       	andi	r25, 0x00	; 0
     1aa:	82 17       	cp	r24, r18
     1ac:	93 07       	cpc	r25, r19
     1ae:	b9 f7       	brne	.-18     	; 0x19e
				sbi(TIFR1, 1);
     1b0:	b1 9a       	sbi	0x16, 1	; 22
     1b2:	cb cf       	rjmp	.-106    	; 0x14a

000001b4 <init_array>:
//----------------------------------------------------------------

void init_array(uint8_t* toinit, uint8_t size, uint8_t init_val){
	uint8_t i;
	for (i=0;i<size;i++){
     1b4:	66 23       	and	r22, r22
     1b6:	21 f0       	breq	.+8      	; 0x1c0
     1b8:	fc 01       	movw	r30, r24
		toinit[i] = init_val;
     1ba:	41 93       	st	Z+, r20
     1bc:	61 50       	subi	r22, 0x01	; 1
     1be:	e9 f7       	brne	.-6      	; 0x1ba
     1c0:	08 95       	ret

000001c2 <reset_sym_xfr>:
	}
}

//logical state setup
inline void init_air(){
	init_array(p_state, NUM__OF_CHANNELS, S0);
	reset_sym_xfr();
	q_level = 0x00; //all enqueue-ing begins at level 0
}

//physical pin setup
inline void init_iris(){
	cbi(DDRB,0); //IR_RX_CHNL6 as input
	DDRC = 0x00; //IR_RX_CHNL[0-5] as inputs
}


//----------------------------------------------------------------
//- IRIS SIGNAL-TO-SYMBOL DECODER
//----------------------------------------------------------------

inline void air_get_channels(){
	air_capture = PINC | (PINB << 6); //This works because..
	//..PC6 will read as zero because fused to be reset line (i.e. GPIO is disabled); 
	//..PB0 is the 6th channel so left shift by 6 get is from 0 bit position to 6th position;
	//..PC7 is potentially corrupted, but we'll never analyze that bit so we don't care!
}

//return the air_Capture data for debugging
inline uint8_t get_air_capture(void){
	return air_capture;	
}

inline void set_air_capture(uint8_t newval){
	air_capture = newval;	
}
		
inline void air_proc_channel(uint8_t channel_num){
	uint8_t new_bit;
	new_bit = air_capture & _BV(channel_num);
	switch (p_state[channel_num]){
		
		//Look for rising edge (assuming inverter)
		case S0: 
			if (new_bit != 0x00){
				z_count[channel_num] = 1; //found the first one (assumes inverter)
				p_state[channel_num] = S1;	
			}
			break;	
		
		//Count the ones (assuming inverter)
		case S1: 
			if (new_bit != 0x00){
				if (z_count[channel_num] != 0xFF){ //error case of channel noise producing extended "white-out", do not roll-over count!
					z_count[channel_num]++;
				}
			}
			else {
				p_state[channel_num] = S2;	//if detected falling edge, counting is done (next state) (assumes inverter)
			}	
			break;
		
		//Counted ones --> symbols; interpret symbols (assuming inverter)
		case S2: 
			if ((z_count[channel_num] >= SYM_1) && (z_count[channel_num] <= SYM_1+SYM_1_MARGIN)){
				//FOUND LOGIC ONE
				load_sym_xfr(channel_num, QSYM_1);
			}
			else if ((z_count[channel_num] >= SYM_0) && (z_count[channel_num] <= SYM_0+SYM_0_MARGIN)){
				//FOUND LOGIC ZERO
				load_sym_xfr(channel_num, QSYM_0);
			}
			else if ((z_count[channel_num] >= SYM_START) && (z_count[channel_num] <= SYM_START+SYM_START_MARGIN)){
				//FOUND START
				load_sym_xfr(channel_num, QSYM_START);
			}
			p_state[channel_num] = S0;
			break;
			
		default:
			p_state[channel_num] = S0;
			break;
	}
}


//----------------------------------------------------------------
//- IRIS SYMBOL TRANSFER SYSTEM (IRISU-to-IRISL)
//----------------------------------------------------------------

//symbol is one of the QSYM values
void load_sym_xfr(uint8_t channel_num, uint8_t symbol){
	if 	(channel_num < 4){
		sym_xfr[0] = sym_xfr[0] | (symbol<<(channel_num*2));
	}
	else if (channel_num < NUM__OF_CHANNELS){
		sym_xfr[1] = sym_xfr[1] | (symbol<<((channel_num-4)*2));
	}
	//else do nothing
}

//transfer the sym_xfr queue to IRISL
//uses forced transfers which means that the UART buffer is assumed to be empty
//no safety checking is performed.
void transfer_sym(void){
	uart0_force_byte(sym_xfr[1]);	
	uart0_force_byte(sym_xfr[0]);	
	reset_sym_xfr();
}

void transfer_sym_debug(void){
	static uint8_t vector_counter = 0;
	vector_counter++;
	
	//vector_counter = 2; //xxx
	
	switch (vector_counter){
	case 1:
		//START
		send_byte_serial(0xFF);	
		send_byte_serial(0xFF);	
		break;
	case 2:
		//D0
		send_byte_serial(0x55);	
		send_byte_serial(0x55);	
		break;
	case 3:
		//D1
		send_byte_serial(0xAA);	
		send_byte_serial(0xAA);	
		break;
	case 4:
		//D1
		send_byte_serial(0xAA);	
		send_byte_serial(0xAA);	
		break;
	case 5:
		//D0
		send_byte_serial(0x55);	
		send_byte_serial(0x55);	
		break;
	case 6:
		//D1
		send_byte_serial(0xAA);	
		send_byte_serial(0xAA);	
		break;
	case 7:
		//D0
		send_byte_serial(0x55);	
		send_byte_serial(0x55);	
		break;
	case 8:
		//D1
		send_byte_serial(0xAA);	
		send_byte_serial(0xAA);	
		break;
	case 9:
		//D0
		send_byte_serial(0x55);	
		send_byte_serial(0x55);	
tpl(ON); //xxx
		break;
	default:
		if (vector_counter > 250) {
			vector_counter = 200;	
		}
	}
	reset_sym_xfr();
}
/*
void debug_transfer_sym(void){
	if ((sym_xfr[1] != 0x00) || (sym_xfr[0] != 0x00)){
		send_byte_serial('r');
		UART_send_BIN8(sym_xfr[1]);	
		send_byte_serial('-');
		UART_send_BIN8(sym_xfr[0]);	
		send_byte_serial(10);
		send_byte_serial(13);
	}
	reset_sym_xfr();
}
*/
//reset sym_xfr queue
inline void reset_sym_xfr(void){
	sym_xfr[1]=0x00;
     1c2:	10 92 04 01 	sts	0x0104, r1
	sym_xfr[0]=0x00;
     1c6:	10 92 03 01 	sts	0x0103, r1
     1ca:	08 95       	ret

000001cc <init_air>:
     1cc:	e5 e0       	ldi	r30, 0x05	; 5
     1ce:	f1 e0       	ldi	r31, 0x01	; 1
     1d0:	86 e0       	ldi	r24, 0x06	; 6
     1d2:	11 92       	st	Z+, r1
     1d4:	81 50       	subi	r24, 0x01	; 1
     1d6:	87 ff       	sbrs	r24, 7
     1d8:	fc cf       	rjmp	.-8      	; 0x1d2
     1da:	10 92 04 01 	sts	0x0104, r1
     1de:	10 92 03 01 	sts	0x0103, r1
     1e2:	10 92 02 01 	sts	0x0102, r1
     1e6:	08 95       	ret

000001e8 <init_iris>:
     1e8:	20 98       	cbi	0x04, 0	; 4
     1ea:	17 b8       	out	0x07, r1	; 7
     1ec:	08 95       	ret

000001ee <air_get_channels>:
     1ee:	83 b1       	in	r24, 0x03	; 3
     1f0:	99 27       	eor	r25, r25
     1f2:	00 24       	eor	r0, r0
     1f4:	96 95       	lsr	r25
     1f6:	87 95       	ror	r24
     1f8:	07 94       	ror	r0
     1fa:	96 95       	lsr	r25
     1fc:	87 95       	ror	r24
     1fe:	07 94       	ror	r0
     200:	98 2f       	mov	r25, r24
     202:	80 2d       	mov	r24, r0
     204:	26 b1       	in	r18, 0x06	; 6
     206:	28 2b       	or	r18, r24
     208:	20 93 01 01 	sts	0x0101, r18
     20c:	08 95       	ret

0000020e <get_air_capture>:
     20e:	80 91 01 01 	lds	r24, 0x0101
     212:	99 27       	eor	r25, r25
     214:	08 95       	ret

00000216 <set_air_capture>:
     216:	80 93 01 01 	sts	0x0101, r24
     21a:	08 95       	ret

0000021c <load_sym_xfr>:
     21c:	28 2f       	mov	r18, r24
     21e:	84 30       	cpi	r24, 0x04	; 4
     220:	80 f4       	brcc	.+32     	; 0x242
     222:	86 2f       	mov	r24, r22
     224:	99 27       	eor	r25, r25
     226:	33 27       	eor	r19, r19
     228:	22 0f       	add	r18, r18
     22a:	33 1f       	adc	r19, r19
     22c:	02 c0       	rjmp	.+4      	; 0x232
     22e:	88 0f       	add	r24, r24
     230:	99 1f       	adc	r25, r25
     232:	2a 95       	dec	r18
     234:	e2 f7       	brpl	.-8      	; 0x22e
     236:	20 91 03 01 	lds	r18, 0x0103
     23a:	28 2b       	or	r18, r24
     23c:	20 93 03 01 	sts	0x0103, r18
     240:	08 95       	ret
     242:	87 30       	cpi	r24, 0x07	; 7
     244:	88 f4       	brcc	.+34     	; 0x268
     246:	86 2f       	mov	r24, r22
     248:	99 27       	eor	r25, r25
     24a:	33 27       	eor	r19, r19
     24c:	22 0f       	add	r18, r18
     24e:	33 1f       	adc	r19, r19
     250:	28 50       	subi	r18, 0x08	; 8
     252:	30 40       	sbci	r19, 0x00	; 0
     254:	02 c0       	rjmp	.+4      	; 0x25a
     256:	88 0f       	add	r24, r24
     258:	99 1f       	adc	r25, r25
     25a:	2a 95       	dec	r18
     25c:	e2 f7       	brpl	.-8      	; 0x256
     25e:	30 91 04 01 	lds	r19, 0x0104
     262:	38 2b       	or	r19, r24
     264:	30 93 04 01 	sts	0x0104, r19
     268:	08 95       	ret
     26a:	08 95       	ret

0000026c <air_proc_channel>:
     26c:	58 2f       	mov	r21, r24
     26e:	a8 2f       	mov	r26, r24
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
     484:	0e 94 74 02 	call	0x4e8
     488:	81 e0       	ldi	r24, 0x01	; 1
     48a:	0e 94 eb 09 	call	0x13d6
     48e:	10 92 04 01 	sts	0x0104, r1
     492:	10 92 03 01 	sts	0x0103, r1
     496:	08 95       	ret

00000498 <init_serial>:
//==================================

//USRT MODE! MASTER
void init_serial(uint8_t mode){
	switch (mode){
     498:	8d 30       	cpi	r24, 0x0D	; 13
     49a:	81 f0       	breq	.+32     	; 0x4bc
		case(USRT):
			// USRT initialization
			UCSR0A=0x02;//just flags in this register; DOUBLE SPEED MODE ON!
			UCSR0C=B8(00000110);//ASYNCHRONOUS; N,8-bit data,1 frame format; Clock polarity = data delta on rising, sample on falling edge
			UBRR0H=0x00;
			UBRR0L=0; //3 = 2.67 Mbps (megabits per second) from 16MHz clock
			sbi(DDRD,1); //TXD is output pin (data line)
			sbi(DDRD,4); //XCK is output pin (USRT clock line)
			UCSR0B=0x08;//No Rx; TX enabled - last line because operation begins on this flag
			break;
		case(UART):	
		default:
			// UART initialization
			UCSR0A=0x00;//just flags in this register
     49c:	10 92 c0 00 	sts	0x00C0, r1
			UCSR0C=B8(01000110);//SYNCHRONOUS (but ignore clock line because less error at BRG); N,8-bit data,1 frame format
     4a0:	46 e4       	ldi	r20, 0x46	; 70
     4a2:	40 93 c2 00 	sts	0x00C2, r20
			UBRR0H = 0;
     4a6:	10 92 c5 00 	sts	0x00C5, r1
			UBRR0L = 68; //115.2k bps from 16MHz clock
     4aa:	34 e4       	ldi	r19, 0x44	; 68
     4ac:	30 93 c4 00 	sts	0x00C4, r19
			sbi(DDRD,1); //TXD is output pin (data line)
     4b0:	51 9a       	sbi	0x0a, 1	; 10
			sbi(DDRD,4); //XCK is output pin (USRT clock line)
     4b2:	54 9a       	sbi	0x0a, 4	; 10
			UCSR0B=0x08;//No Rx; TX enabled - last line because operation begins on this flag		
     4b4:	58 e0       	ldi	r21, 0x08	; 8
     4b6:	50 93 c1 00 	sts	0x00C1, r21
     4ba:	08 95       	ret
     4bc:	22 e0       	ldi	r18, 0x02	; 2
     4be:	20 93 c0 00 	sts	0x00C0, r18
     4c2:	86 e0       	ldi	r24, 0x06	; 6
     4c4:	80 93 c2 00 	sts	0x00C2, r24
     4c8:	10 92 c5 00 	sts	0x00C5, r1
     4cc:	10 92 c4 00 	sts	0x00C4, r1
     4d0:	51 9a       	sbi	0x0a, 1	; 10
     4d2:	54 9a       	sbi	0x0a, 4	; 10
     4d4:	58 e0       	ldi	r21, 0x08	; 8
     4d6:	50 93 c1 00 	sts	0x00C1, r21
     4da:	08 95       	ret
     4dc:	08 95       	ret

000004de <USRT_send_2bytes>:
			break;
	}
}

//dataA is sent first
//this function built for speed, no safety checking. UART shift and buffer registers should be empty.
//The first write falls through to the actual output register freeing the buffer for byte 2.
void inline USRT_send_2bytes(unsigned char dataA, unsigned char dataB){
	// XXX
	UDR0 = dataA;
     4de:	80 93 c6 00 	sts	0x00C6, r24
	UDR0 = dataB;
     4e2:	60 93 c6 00 	sts	0x00C6, r22
     4e6:	08 95       	ret

000004e8 <send_byte_serial>:
	/*
	//DEBUG code to test the buffer ready for new data flag
	if(UCSR0A & B8(00100000)){ //true != 0, freeze on buffer avail
		stk_ledon(0xAA);
		while(1);
	}
	*/
}

void inline send_byte_serial(unsigned char dataB){
     4e8:	48 2f       	mov	r20, r24
     4ea:	21 e0       	ldi	r18, 0x01	; 1
     4ec:	30 e0       	ldi	r19, 0x00	; 0
	while ((UCSR0A & _BV(5)) != B8(00100000));
     4ee:	80 91 c0 00 	lds	r24, 0x00C0
     4f2:	99 27       	eor	r25, r25
     4f4:	96 95       	lsr	r25
     4f6:	87 95       	ror	r24
     4f8:	92 95       	swap	r25
     4fa:	82 95       	swap	r24
     4fc:	8f 70       	andi	r24, 0x0F	; 15
     4fe:	89 27       	eor	r24, r25
     500:	9f 70       	andi	r25, 0x0F	; 15
     502:	89 27       	eor	r24, r25
     504:	81 70       	andi	r24, 0x01	; 1
     506:	90 70       	andi	r25, 0x00	; 0
     508:	82 17       	cp	r24, r18
     50a:	93 07       	cpc	r25, r19
     50c:	81 f7       	brne	.-32     	; 0x4ee
	UDR0 = dataB;
     50e:	40 93 c6 00 	sts	0x00C6, r20
     512:	08 95       	ret

00000514 <uart0_force_byte>:
}

void inline uart0_force_byte(unsigned char dataB){
	UDR0 = dataB;
     514:	80 93 c6 00 	sts	0x00C6, r24
     518:	08 95       	ret

0000051a <UART_send_BIN4>:
}

//Most Significant Bit first
void UART_send_BIN4(uint8_t lowb){
	switch(lowb){
     51a:	99 27       	eor	r25, r25
     51c:	87 30       	cpi	r24, 0x07	; 7
     51e:	91 05       	cpc	r25, r1
     520:	09 f4       	brne	.+2      	; 0x524
     522:	cb c0       	rjmp	.+406    	; 0x6ba
     524:	88 30       	cpi	r24, 0x08	; 8
     526:	91 05       	cpc	r25, r1
     528:	0c f0       	brlt	.+2      	; 0x52c
     52a:	65 c0       	rjmp	.+202    	; 0x5f6
     52c:	83 30       	cpi	r24, 0x03	; 3
     52e:	91 05       	cpc	r25, r1
     530:	09 f4       	brne	.+2      	; 0x534
     532:	d4 c1       	rjmp	.+936    	; 0x8dc
     534:	84 30       	cpi	r24, 0x04	; 4
     536:	91 05       	cpc	r25, r1
     538:	0c f0       	brlt	.+2      	; 0x53c
     53a:	14 c1       	rjmp	.+552    	; 0x764
     53c:	81 30       	cpi	r24, 0x01	; 1
     53e:	91 05       	cpc	r25, r1
     540:	09 f4       	brne	.+2      	; 0x544
     542:	6c c3       	rjmp	.+1752   	; 0xc1c
     544:	82 30       	cpi	r24, 0x02	; 2
     546:	91 05       	cpc	r25, r1
     548:	0c f4       	brge	.+2      	; 0x54c
     54a:	ae c4       	rjmp	.+2396   	; 0xea8
     54c:	21 e0       	ldi	r18, 0x01	; 1
     54e:	30 e0       	ldi	r19, 0x00	; 0
     550:	80 91 c0 00 	lds	r24, 0x00C0
     554:	99 27       	eor	r25, r25
     556:	96 95       	lsr	r25
     558:	87 95       	ror	r24
     55a:	92 95       	swap	r25
     55c:	82 95       	swap	r24
     55e:	8f 70       	andi	r24, 0x0F	; 15
     560:	89 27       	eor	r24, r25
     562:	9f 70       	andi	r25, 0x0F	; 15
     564:	89 27       	eor	r24, r25
     566:	81 70       	andi	r24, 0x01	; 1
     568:	90 70       	andi	r25, 0x00	; 0
     56a:	82 17       	cp	r24, r18
     56c:	93 07       	cpc	r25, r19
     56e:	81 f7       	brne	.-32     	; 0x550
     570:	70 e3       	ldi	r23, 0x30	; 48
     572:	70 93 c6 00 	sts	0x00C6, r23
     576:	21 e0       	ldi	r18, 0x01	; 1
     578:	30 e0       	ldi	r19, 0x00	; 0
     57a:	80 91 c0 00 	lds	r24, 0x00C0
     57e:	99 27       	eor	r25, r25
     580:	96 95       	lsr	r25
     582:	87 95       	ror	r24
     584:	92 95       	swap	r25
     586:	82 95       	swap	r24
     588:	8f 70       	andi	r24, 0x0F	; 15
     58a:	89 27       	eor	r24, r25
     58c:	9f 70       	andi	r25, 0x0F	; 15
     58e:	89 27       	eor	r24, r25
     590:	81 70       	andi	r24, 0x01	; 1
     592:	90 70       	andi	r25, 0x00	; 0
     594:	82 17       	cp	r24, r18
     596:	93 07       	cpc	r25, r19
     598:	81 f7       	brne	.-32     	; 0x57a
     59a:	90 e3       	ldi	r25, 0x30	; 48
     59c:	90 93 c6 00 	sts	0x00C6, r25
     5a0:	21 e0       	ldi	r18, 0x01	; 1
     5a2:	30 e0       	ldi	r19, 0x00	; 0
     5a4:	80 91 c0 00 	lds	r24, 0x00C0
     5a8:	99 27       	eor	r25, r25
     5aa:	96 95       	lsr	r25
     5ac:	87 95       	ror	r24
     5ae:	92 95       	swap	r25
     5b0:	82 95       	swap	r24
     5b2:	8f 70       	andi	r24, 0x0F	; 15
     5b4:	89 27       	eor	r24, r25
     5b6:	9f 70       	andi	r25, 0x0F	; 15
     5b8:	89 27       	eor	r24, r25
     5ba:	81 70       	andi	r24, 0x01	; 1
     5bc:	90 70       	andi	r25, 0x00	; 0
     5be:	82 17       	cp	r24, r18
     5c0:	93 07       	cpc	r25, r19
     5c2:	81 f7       	brne	.-32     	; 0x5a4
     5c4:	a1 e3       	ldi	r26, 0x31	; 49
     5c6:	a0 93 c6 00 	sts	0x00C6, r26
     5ca:	21 e0       	ldi	r18, 0x01	; 1
     5cc:	30 e0       	ldi	r19, 0x00	; 0
     5ce:	80 91 c0 00 	lds	r24, 0x00C0
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
     f66:	82 95       	swap	r24
     f68:	8f 70       	andi	r24, 0x0F	; 15
     f6a:	89 27       	eor	r24, r25
     f6c:	9f 70       	andi	r25, 0x0F	; 15
     f6e:	89 27       	eor	r24, r25
     f70:	81 70       	andi	r24, 0x01	; 1
     f72:	90 70       	andi	r25, 0x00	; 0
     f74:	82 17       	cp	r24, r18
     f76:	93 07       	cpc	r25, r19
     f78:	81 f7       	brne	.-32     	; 0xf5a
     f7a:	80 e3       	ldi	r24, 0x30	; 48
     f7c:	80 93 c6 00 	sts	0x00C6, r24
     f80:	21 e0       	ldi	r18, 0x01	; 1
     f82:	30 e0       	ldi	r19, 0x00	; 0
     f84:	80 91 c0 00 	lds	r24, 0x00C0
     f88:	99 27       	eor	r25, r25
     f8a:	96 95       	lsr	r25
     f8c:	87 95       	ror	r24
     f8e:	92 95       	swap	r25
     f90:	82 95       	swap	r24
     f92:	8f 70       	andi	r24, 0x0F	; 15
     f94:	89 27       	eor	r24, r25
     f96:	9f 70       	andi	r25, 0x0F	; 15
     f98:	89 27       	eor	r24, r25
     f9a:	81 70       	andi	r24, 0x01	; 1
     f9c:	90 70       	andi	r25, 0x00	; 0
     f9e:	82 17       	cp	r24, r18
     fa0:	93 07       	cpc	r25, r19
     fa2:	81 f7       	brne	.-32     	; 0xf84
     fa4:	20 e3       	ldi	r18, 0x30	; 48
     fa6:	20 93 c6 00 	sts	0x00C6, r18
     faa:	21 e0       	ldi	r18, 0x01	; 1
     fac:	30 e0       	ldi	r19, 0x00	; 0
     fae:	80 91 c0 00 	lds	r24, 0x00C0
     fb2:	99 27       	eor	r25, r25
     fb4:	96 95       	lsr	r25
     fb6:	87 95       	ror	r24
     fb8:	92 95       	swap	r25
     fba:	82 95       	swap	r24
     fbc:	8f 70       	andi	r24, 0x0F	; 15
     fbe:	89 27       	eor	r24, r25
     fc0:	9f 70       	andi	r25, 0x0F	; 15
     fc2:	89 27       	eor	r24, r25
     fc4:	81 70       	andi	r24, 0x01	; 1
     fc6:	90 70       	andi	r25, 0x00	; 0
     fc8:	82 17       	cp	r24, r18
     fca:	93 07       	cpc	r25, r19
     fcc:	81 f7       	brne	.-32     	; 0xfae
     fce:	30 e3       	ldi	r19, 0x30	; 48
     fd0:	30 93 c6 00 	sts	0x00C6, r19
     fd4:	21 e0       	ldi	r18, 0x01	; 1
     fd6:	30 e0       	ldi	r19, 0x00	; 0
     fd8:	80 91 c0 00 	lds	r24, 0x00C0
     fdc:	99 27       	eor	r25, r25
     fde:	96 95       	lsr	r25
     fe0:	87 95       	ror	r24
     fe2:	92 95       	swap	r25
     fe4:	82 95       	swap	r24
     fe6:	8f 70       	andi	r24, 0x0F	; 15
     fe8:	89 27       	eor	r24, r25
     fea:	9f 70       	andi	r25, 0x0F	; 15
     fec:	89 27       	eor	r24, r25
     fee:	81 70       	andi	r24, 0x01	; 1
     ff0:	90 70       	andi	r25, 0x00	; 0
     ff2:	82 17       	cp	r24, r18
     ff4:	93 07       	cpc	r25, r19
     ff6:	81 f7       	brne	.-32     	; 0xfd8
     ff8:	80 e3       	ldi	r24, 0x30	; 48
     ffa:	fa ca       	rjmp	.-2572   	; 0x5f0

00000ffc <UART_send_BIN8>:
	case(0):
		send_byte_serial('0');
		send_byte_serial('0');
		send_byte_serial('0');
		send_byte_serial('0');
		break;
	case(1):
		send_byte_serial('0');
		send_byte_serial('0');
		send_byte_serial('0');
		send_byte_serial('1');
		break;
	case(2):
		send_byte_serial('0');
		send_byte_serial('0');
		send_byte_serial('1');
		send_byte_serial('0');
		break;
	case(3):
		send_byte_serial('0');
		send_byte_serial('0');
		send_byte_serial('1');
		send_byte_serial('1');
		break;
	case(4):
		send_byte_serial('0');
		send_byte_serial('1');
		send_byte_serial('0');
		send_byte_serial('0');
		break;
	case(5):
		send_byte_serial('0');
		send_byte_serial('1');
		send_byte_serial('0');
		send_byte_serial('1');
		break;
	case(6):
		send_byte_serial('0');
		send_byte_serial('1');
		send_byte_serial('1');
		send_byte_serial('0');
		break;
	case(7):
		send_byte_serial('0');
		send_byte_serial('1');
		send_byte_serial('1');
		send_byte_serial('1');
		break;
	case(8):
		send_byte_serial('1');
		send_byte_serial('0');
		send_byte_serial('0');
		send_byte_serial('0');
		break;
	case(9):
		send_byte_serial('1');
		send_byte_serial('0');
		send_byte_serial('0');
		send_byte_serial('1');
		break;
	case(10):
		send_byte_serial('1');
		send_byte_serial('0');
		send_byte_serial('1');
		send_byte_serial('0');
		break;
	case(11):
		send_byte_serial('1');
		send_byte_serial('0');
		send_byte_serial('1');
		send_byte_serial('1');
		break;
	case(12):
		send_byte_serial('1');
		send_byte_serial('1');
		send_byte_serial('0');
		send_byte_serial('0');
		break;
	case(13):
		send_byte_serial('1');
		send_byte_serial('1');
		send_byte_serial('0');
		send_byte_serial('1');
		break;
	case(14):
		send_byte_serial('1');
		send_byte_serial('1');
		send_byte_serial('1');
		send_byte_serial('0');
		break;
	case(15):
		send_byte_serial('1');
		send_byte_serial('1');
		send_byte_serial('1');
		send_byte_serial('1');
		break;
	}	
}

//Sends out tosend as ASCII text in 'b01101010' format
void UART_send_BIN8(uint8_t lowb){
     ffc:	cf 93       	push	r28
     ffe:	c8 2f       	mov	r28, r24
    1000:	21 e0       	ldi	r18, 0x01	; 1
    1002:	30 e0       	ldi	r19, 0x00	; 0
    1004:	80 91 c0 00 	lds	r24, 0x00C0
    1008:	99 27       	eor	r25, r25
    100a:	96 95       	lsr	r25
    100c:	87 95       	ror	r24
    100e:	92 95       	swap	r25
    1010:	82 95       	swap	r24
    1012:	8f 70       	andi	r24, 0x0F	; 15
    1014:	89 27       	eor	r24, r25
    1016:	9f 70       	andi	r25, 0x0F	; 15
    1018:	89 27       	eor	r24, r25
    101a:	81 70       	andi	r24, 0x01	; 1
    101c:	90 70       	andi	r25, 0x00	; 0
    101e:	82 17       	cp	r24, r18
    1020:	93 07       	cpc	r25, r19
    1022:	81 f7       	brne	.-32     	; 0x1004
    1024:	82 e6       	ldi	r24, 0x62	; 98
    1026:	80 93 c6 00 	sts	0x00C6, r24
	send_byte_serial('b');
	UART_send_BIN4(lowb>>4);
    102a:	8c 2f       	mov	r24, r28
    102c:	82 95       	swap	r24
    102e:	8f 70       	andi	r24, 0x0F	; 15
    1030:	0e 94 8d 02 	call	0x51a
	UART_send_BIN4(lowb & 0x0F);
    1034:	8c 2f       	mov	r24, r28
    1036:	8f 70       	andi	r24, 0x0F	; 15
    1038:	0e 94 8d 02 	call	0x51a
    103c:	cf 91       	pop	r28
    103e:	08 95       	ret

00001040 <UART_send_HEX4>:
}
	
void UART_send_HEX4(uint8_t lowb){
	switch(lowb){
    1040:	99 27       	eor	r25, r25
    1042:	87 30       	cpi	r24, 0x07	; 7
    1044:	91 05       	cpc	r25, r1
    1046:	09 f4       	brne	.+2      	; 0x104a
    1048:	4a c0       	rjmp	.+148    	; 0x10de
    104a:	88 30       	cpi	r24, 0x08	; 8
    104c:	91 05       	cpc	r25, r1
    104e:	24 f5       	brge	.+72     	; 0x1098
    1050:	83 30       	cpi	r24, 0x03	; 3
    1052:	91 05       	cpc	r25, r1
    1054:	09 f4       	brne	.+2      	; 0x1058
    1056:	9a c0       	rjmp	.+308    	; 0x118c
    1058:	84 30       	cpi	r24, 0x04	; 4
    105a:	91 05       	cpc	r25, r1
    105c:	0c f0       	brlt	.+2      	; 0x1060
    105e:	55 c0       	rjmp	.+170    	; 0x110a
    1060:	81 30       	cpi	r24, 0x01	; 1
    1062:	91 05       	cpc	r25, r1
    1064:	09 f4       	brne	.+2      	; 0x1068
    1066:	fa c0       	rjmp	.+500    	; 0x125c
    1068:	82 30       	cpi	r24, 0x02	; 2
    106a:	91 05       	cpc	r25, r1
    106c:	0c f4       	brge	.+2      	; 0x1070
    106e:	44 c1       	rjmp	.+648    	; 0x12f8
    1070:	21 e0       	ldi	r18, 0x01	; 1
    1072:	30 e0       	ldi	r19, 0x00	; 0
    1074:	80 91 c0 00 	lds	r24, 0x00C0
    1078:	99 27       	eor	r25, r25
    107a:	96 95       	lsr	r25
    107c:	87 95       	ror	r24
    107e:	92 95       	swap	r25
    1080:	82 95       	swap	r24
    1082:	8f 70       	andi	r24, 0x0F	; 15
    1084:	89 27       	eor	r24, r25
    1086:	9f 70       	andi	r25, 0x0F	; 15
    1088:	89 27       	eor	r24, r25
    108a:	81 70       	andi	r24, 0x01	; 1
    108c:	90 70       	andi	r25, 0x00	; 0
    108e:	82 17       	cp	r24, r18
    1090:	93 07       	cpc	r25, r19
    1092:	81 f7       	brne	.-32     	; 0x1074
    1094:	82 e3       	ldi	r24, 0x32	; 50
    1096:	36 c0       	rjmp	.+108    	; 0x1104
    1098:	8b 30       	cpi	r24, 0x0B	; 11
    109a:	91 05       	cpc	r25, r1
    109c:	09 f4       	brne	.+2      	; 0x10a0
    109e:	60 c0       	rjmp	.+192    	; 0x1160
    10a0:	8c 30       	cpi	r24, 0x0C	; 12
    10a2:	91 05       	cpc	r25, r1
    10a4:	0c f0       	brlt	.+2      	; 0x10a8
    10a6:	4c c0       	rjmp	.+152    	; 0x1140
    10a8:	89 30       	cpi	r24, 0x09	; 9
    10aa:	91 05       	cpc	r25, r1
    10ac:	09 f4       	brne	.+2      	; 0x10b0
    10ae:	e8 c0       	rjmp	.+464    	; 0x1280
    10b0:	0a 97       	sbiw	r24, 0x0a	; 10
    10b2:	0c f0       	brlt	.+2      	; 0x10b6
    10b4:	81 c0       	rjmp	.+258    	; 0x11b8
    10b6:	21 e0       	ldi	r18, 0x01	; 1
    10b8:	30 e0       	ldi	r19, 0x00	; 0
    10ba:	80 91 c0 00 	lds	r24, 0x00C0
    10be:	99 27       	eor	r25, r25
    10c0:	96 95       	lsr	r25
    10c2:	87 95       	ror	r24
    10c4:	92 95       	swap	r25
    10c6:	82 95       	swap	r24
    10c8:	8f 70       	andi	r24, 0x0F	; 15
    10ca:	89 27       	eor	r24, r25
    10cc:	9f 70       	andi	r25, 0x0F	; 15
    10ce:	89 27       	eor	r24, r25
    10d0:	81 70       	andi	r24, 0x01	; 1
    10d2:	90 70       	andi	r25, 0x00	; 0
    10d4:	82 17       	cp	r24, r18
    10d6:	93 07       	cpc	r25, r19
    10d8:	81 f7       	brne	.-32     	; 0x10ba
    10da:	88 e3       	ldi	r24, 0x38	; 56
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
    130e:	82 95       	swap	r24
    1310:	8f 70       	andi	r24, 0x0F	; 15
    1312:	89 27       	eor	r24, r25
    1314:	9f 70       	andi	r25, 0x0F	; 15
    1316:	89 27       	eor	r24, r25
    1318:	81 70       	andi	r24, 0x01	; 1
    131a:	90 70       	andi	r25, 0x00	; 0
    131c:	82 17       	cp	r24, r18
    131e:	93 07       	cpc	r25, r19
    1320:	81 f7       	brne	.-32     	; 0x1302
    1322:	85 e4       	ldi	r24, 0x45	; 69
    1324:	ef ce       	rjmp	.-546    	; 0x1104
    1326:	21 e0       	ldi	r18, 0x01	; 1
    1328:	30 e0       	ldi	r19, 0x00	; 0
    132a:	80 91 c0 00 	lds	r24, 0x00C0
    132e:	99 27       	eor	r25, r25
    1330:	96 95       	lsr	r25
    1332:	87 95       	ror	r24
    1334:	92 95       	swap	r25
    1336:	82 95       	swap	r24
    1338:	8f 70       	andi	r24, 0x0F	; 15
    133a:	89 27       	eor	r24, r25
    133c:	9f 70       	andi	r25, 0x0F	; 15
    133e:	89 27       	eor	r24, r25
    1340:	81 70       	andi	r24, 0x01	; 1
    1342:	90 70       	andi	r25, 0x00	; 0
    1344:	82 17       	cp	r24, r18
    1346:	93 07       	cpc	r25, r19
    1348:	81 f7       	brne	.-32     	; 0x132a
    134a:	80 e3       	ldi	r24, 0x30	; 48
    134c:	db ce       	rjmp	.-586    	; 0x1104

0000134e <UART_send_HEX8>:
	case(0):
		send_byte_serial('0');
		break;
	case(1):
		send_byte_serial('1');
		break;
	case(2):
		send_byte_serial('2');
		break;
	case(3):
		send_byte_serial('3');
		break;
	case(4):
		send_byte_serial('4');
		break;
	case(5):
		send_byte_serial('5');
		break;
	case(6):
		send_byte_serial('6');
		break;
	case(7):
		send_byte_serial('7');
		break;
	case(8):
		send_byte_serial('8');
		break;
	case(9):
		send_byte_serial('9');
		break;
	case(10):
		send_byte_serial('A');
		break;
	case(11):
		send_byte_serial('B');
		break;
	case(12):
		send_byte_serial('C');
		break;
	case(13):
		send_byte_serial('D');
		break;
	case(14):
		send_byte_serial('E');
		break;
	case(15):
		send_byte_serial('F');
		break;
	}	
}

void UART_send_HEX8(uint8_t lowb){
    134e:	1f 93       	push	r17
    1350:	18 2f       	mov	r17, r24
	UART_send_HEX4(lowb>>4);
    1352:	82 95       	swap	r24
    1354:	8f 70       	andi	r24, 0x0F	; 15
    1356:	0e 94 20 08 	call	0x1040
	UART_send_HEX4(lowb & 0x0F);
    135a:	81 2f       	mov	r24, r17
    135c:	8f 70       	andi	r24, 0x0F	; 15
    135e:	0e 94 20 08 	call	0x1040
    1362:	1f 91       	pop	r17
    1364:	08 95       	ret

00001366 <UART_send_HEX16b>:
}

void UART_send_HEX16b(uint8_t highb, uint8_t lowb){
    1366:	0f 93       	push	r16
    1368:	1f 93       	push	r17
    136a:	18 2f       	mov	r17, r24
    136c:	06 2f       	mov	r16, r22
    136e:	82 95       	swap	r24
    1370:	8f 70       	andi	r24, 0x0F	; 15
    1372:	0e 94 20 08 	call	0x1040
    1376:	81 2f       	mov	r24, r17
    1378:	8f 70       	andi	r24, 0x0F	; 15
    137a:	0e 94 20 08 	call	0x1040
    137e:	80 2f       	mov	r24, r16
    1380:	82 95       	swap	r24
    1382:	8f 70       	andi	r24, 0x0F	; 15
    1384:	0e 94 20 08 	call	0x1040
    1388:	80 2f       	mov	r24, r16
    138a:	8f 70       	andi	r24, 0x0F	; 15
    138c:	0e 94 20 08 	call	0x1040
    1390:	1f 91       	pop	r17
    1392:	0f 91       	pop	r16
    1394:	08 95       	ret

00001396 <UART_send_HEX16>:
	UART_send_HEX8(highb);
	UART_send_HEX8(lowb);
}

void UART_send_HEX16(uint16_t highb){
    1396:	ef 92       	push	r14
    1398:	ff 92       	push	r15
    139a:	1f 93       	push	r17
    139c:	7c 01       	movw	r14, r24
	uint8_t blah;
	blah = (uint8_t)(highb>>8);
    139e:	89 2f       	mov	r24, r25
    13a0:	99 27       	eor	r25, r25
    13a2:	f8 2e       	mov	r15, r24
    13a4:	82 95       	swap	r24
    13a6:	8f 70       	andi	r24, 0x0F	; 15
    13a8:	0e 94 20 08 	call	0x1040
    13ac:	8f 2d       	mov	r24, r15
    13ae:	8f 70       	andi	r24, 0x0F	; 15
    13b0:	0e 94 20 08 	call	0x1040
    13b4:	8e 2d       	mov	r24, r14
    13b6:	82 95       	swap	r24
    13b8:	8f 70       	andi	r24, 0x0F	; 15
    13ba:	0e 94 20 08 	call	0x1040
    13be:	8e 2d       	mov	r24, r14
    13c0:	8f 70       	andi	r24, 0x0F	; 15
    13c2:	0e 94 20 08 	call	0x1040
    13c6:	1f 91       	pop	r17
    13c8:	ff 90       	pop	r15
    13ca:	ef 90       	pop	r14
    13cc:	08 95       	ret

000013ce <init_tp>:
//- INIT ROUTINES
//----------------------------------------------------------------

inline void init_tp(){
	sbi(DDRB, 1);
    13ce:	21 9a       	sbi	0x04, 1	; 4
	sbi(DDRD, 5);
    13d0:	55 9a       	sbi	0x0a, 5	; 10
	sbi(DDRD, 6);	
    13d2:	56 9a       	sbi	0x0a, 6	; 10
    13d4:	08 95       	ret

000013d6 <tpl>:
}

//----------------------------------------------------------------
//- COMMAND ROUTINES
//----------------------------------------------------------------

//Test Point LED (D_IRISU)
inline void tpl(uint8_t cmd){
	switch(cmd){
    13d6:	99 27       	eor	r25, r25
    13d8:	82 30       	cpi	r24, 0x02	; 2
    13da:	91 05       	cpc	r25, r1
    13dc:	69 f0       	breq	.+26     	; 0x13f8
    13de:	83 30       	cpi	r24, 0x03	; 3
    13e0:	91 05       	cpc	r25, r1
    13e2:	1c f4       	brge	.+6      	; 0x13ea
    13e4:	01 97       	sbiw	r24, 0x01	; 1
    13e6:	51 f0       	breq	.+20     	; 0x13fc
    13e8:	08 95       	ret
    13ea:	03 97       	sbiw	r24, 0x03	; 3
    13ec:	e9 f7       	brne	.-6      	; 0x13e8
		case ON:
			sbi(PORTB, 1);
			break;
		case OFF:
			cbi(PORTB, 1);
			break;
		case TOGGLE:
			tbi(PORTB, 1);
    13ee:	85 b1       	in	r24, 0x05	; 5
    13f0:	92 e0       	ldi	r25, 0x02	; 2
    13f2:	89 27       	eor	r24, r25
    13f4:	85 b9       	out	0x05, r24	; 5
    13f6:	08 95       	ret
    13f8:	29 98       	cbi	0x05, 1	; 5
    13fa:	08 95       	ret
    13fc:	29 9a       	sbi	0x05, 1	; 5
    13fe:	08 95       	ret
    1400:	08 95       	ret

00001402 <tp4>:
			break;
		default:
			break;
	}
}

//Test Point 4
inline void tp4(uint8_t cmd){
	switch(cmd){
    1402:	99 27       	eor	r25, r25
    1404:	82 30       	cpi	r24, 0x02	; 2
    1406:	91 05       	cpc	r25, r1
    1408:	69 f0       	breq	.+26     	; 0x1424
    140a:	83 30       	cpi	r24, 0x03	; 3
    140c:	91 05       	cpc	r25, r1
    140e:	1c f4       	brge	.+6      	; 0x1416
    1410:	01 97       	sbiw	r24, 0x01	; 1
    1412:	51 f0       	breq	.+20     	; 0x1428
    1414:	08 95       	ret
    1416:	03 97       	sbiw	r24, 0x03	; 3
    1418:	e9 f7       	brne	.-6      	; 0x1414
		case ON:
			sbi(PORTD, 5);
			break;
		case OFF:
			cbi(PORTD, 5);
			break;
		case TOGGLE:
			tbi(PORTD, 5);
    141a:	8b b1       	in	r24, 0x0b	; 11
    141c:	90 e2       	ldi	r25, 0x20	; 32
    141e:	89 27       	eor	r24, r25
    1420:	8b b9       	out	0x0b, r24	; 11
    1422:	08 95       	ret
    1424:	5d 98       	cbi	0x0b, 5	; 11
    1426:	08 95       	ret
    1428:	5d 9a       	sbi	0x0b, 5	; 11
    142a:	08 95       	ret
    142c:	08 95       	ret

0000142e <tp5>:
			break;
		default:
			break;
	}
}

//Test Point 5
inline void tp5(uint8_t cmd){
	switch(cmd){
    142e:	99 27       	eor	r25, r25
    1430:	82 30       	cpi	r24, 0x02	; 2
    1432:	91 05       	cpc	r25, r1
    1434:	69 f0       	breq	.+26     	; 0x1450
    1436:	83 30       	cpi	r24, 0x03	; 3
    1438:	91 05       	cpc	r25, r1
    143a:	1c f4       	brge	.+6      	; 0x1442
    143c:	01 97       	sbiw	r24, 0x01	; 1
    143e:	51 f0       	breq	.+20     	; 0x1454
    1440:	08 95       	ret
    1442:	03 97       	sbiw	r24, 0x03	; 3
    1444:	e9 f7       	brne	.-6      	; 0x1440
		case ON:
			sbi(PORTD, 6);
			break;
		case OFF:
			cbi(PORTD, 6);
			break;
		case TOGGLE:
			tbi(PORTD, 6);
    1446:	8b b1       	in	r24, 0x0b	; 11
    1448:	90 e4       	ldi	r25, 0x40	; 64
    144a:	89 27       	eor	r24, r25
    144c:	8b b9       	out	0x0b, r24	; 11
    144e:	08 95       	ret
    1450:	5e 98       	cbi	0x0b, 6	; 11
    1452:	08 95       	ret
    1454:	5e 9a       	sbi	0x0b, 6	; 11
    1456:	08 95       	ret
    1458:	08 95       	ret
