nesl/ragobots/robot/sw/code/sos-1.x/include/modules/inertialsensor.h

/* -*- Mode: C; tab-width:4 -*- */
/* ex: set ts=4 shiftwidth=4 softtabstop=4 cindent: */
/*
 * Copyright (c) 2003 The Regents of the University of California.
 * All rights reserved.
 *
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
 */


//-----------------------------------------------------------------------------
// MESSAGE DEFINITIONS
//-----------------------------------------------------------------------------
enum {
  //Get Accelerometer Readings
  MSG_GET_ACC_READINGS = (MOD_MSG_START+0),
  MSG_GET_MAG_READINGS = (MOD_MSG_START+1),
  MSG_GET_INERTIAL_READINGS = (MOD_MSG_START+2),

  MSG_GET_ACC_READINGS_DONE = (MOD_MSG_START+7),
  MSG_GET_MAG_READINGS_DONE = (MOD_MSG_START+8), 
  MSG_GET_INERTIAL_READINGS_DONE = (MOD_MSG_START+9), 

  MSG_GET_ACC_READINGS_FAIL = (MOD_MSG_START+13),
  MSG_GET_MAG_READINGS_FAIL = (MOD_MSG_START+14), 
  MSG_GET_INERTIAL_READINGS_FAIL = (MOD_MSG_START+15), 
  
};


#define ACCSENSOR_ENABLE() post_short(RAGOBOT_CB2BUS_PID, RAGOBOT_INERTIALSENSOR_PID, MSG_ACC_EN, ENABLE, 0, 0); post_short(RAGOBOT_CB2BUS_PID, RAGOBOT_INERTIALSENSOR_PID, MSG_LOAD, 0, 0, 0) 
#define ACCSENSOR_DISABLE() post_short(RAGOBOT_CB2BUS_PID, RAGOBOT_INERTIALSENSOR_PID, MSG_ACC_EN, DISABLE, 0, 0); post_short(RAGOBOT_CB2BUS_PID, s->pid, RAGOBOT_INERTIALSENSOR_PID, 0, 0, 0)

#define MAGSENSOR_ENABLE() post_short(RAGOBOT_CB2BUS_PID, RAGOBOT_INERTIALSENSOR_PID, MSG_MAG_EN, ENABLE, 0, 0); post_short(RAGOBOT_CB2BUS_PID, RAGOBOT_INERTIALSENSOR_PID, MSG_LOAD, 0, 0, 0) 
#define MAGSENSOR_DISABLE() post_short(RAGOBOT_CB2BUS_PID, RAGOBOT_INERTIALSENSOR_PID, MSG_MAG_EN, DISABLE, 0, 0); post_short(RAGOBOT_CB2BUS_PID, s->pid, RAGOBOT_INERTIALSENSOR_PID, 0, 0, 0)

#define MAGSENSOR_RESET() post_short(RAGOBOT_CB2BUS_PID, RAGOBOT_INERTIALSENSOR_PID, MSG_MAG_RESET, 0, 0, 0); post_short(RAGOBOT_CB2BUS_PID, RAGOBOT_INERTIALSENSOR_PID, MSG_LOAD, 0, 0, 0) 

#ifndef _MODULE_
mod_header_ptr inertialsensor_get_header();
#endif
