nesl/ragobots/robot/sw/code/tinyos/tos/system/PanTiltController.h

#define PAN_SERVO_ID 0
#define TILT_SERVO_ID 1

#define BUSY_PERIOD 300

#define NUM_SERVO_POSITIONS 27

int8_t ServoPositionArray[] = {-91, -84, -77, -70, -63, -56, -49, -42, -35, -29, -22, -15, -8, -1, 6, 13, 20, 27, 34, 41, 48, 55, 62, 69, 76, 83, 90};
