nesl/ragobots/robot/sw/code/sos/dev/mica2/ragobot_module.h

/* -*- Mode: C; tab-width:4 -*- */
/* ex: set ts=4: */
/*
 * Copyright (c) 2003 The Regents of the University of California.
 * All rights reserved.
 *
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
 */
/** 
 * @brief Header file for Ragobot specific modules
 * 
 * This is the only file that module writer for Ragobot should include.
 *
 */

#ifndef _RAGOBOT_MODULE_H_
#define _RAGOBOT_MODULE_H_

#include <ragobot_message_types.h>
//#include <pushbutton.h>
#include <modules/ragobot_mod_pid.h>
#include <modules/cb2bus.h>
//#include <uart_ragobot.h>

#include <module.h>

/**
 * Register module to receive message when pushbutton is pressed
 */
typedef int8_t (*ker_pushbutton_register_t)(uint8_t pid);
static inline int8_t ker_pushbutton_register(uint8_t pid) {
  ker_pushbutton_register_t func = (ker_pushbutton_register_t)pgm_read_word(0x8c+128+0);
  return func(pid);
}

/**
 * Unregister module to receive message when pushbutton is pressed
 */
static inline int8_t ker_pushbutton_deregister(uint8_t pid) {
  ker_pushbutton_register_t func = (ker_pushbutton_register_t)pgm_read_word(0x8c+128+2);
  return func(pid);
}

/**
 * Load cb2bus with configuration bytes in vport
 */
typedef void (*ker_cb2bus_load_t)(uint8_t vport[], uint8_t size);
static inline void ker_cb2bus_load(uint8_t vport[], uint8_t size) {
  ker_cb2bus_load_t func = (ker_cb2bus_load_t)pgm_read_word(0x8c+128+4);
  return func(vport, size);
}

/**
 * Set the position of a servo
 */
typedef int8_t (*ker_servo_set_position_t)(uint8_t motor_id, int8_t position);
static inline int8_t ker_servo_set_position(uint8_t motor_id, int8_t position){
  ker_servo_set_position_t func = (ker_servo_set_position_t)pgm_read_word(0x8c+128+6);
  return func(motor_id, position);
}

/**
 * Register module to receive message when a HIPRI_INT interrupts is received
 */
typedef int8_t (*ker_hipri_register_t)(uint8_t pid);
static inline int8_t ker_hipri_int_register(uint8_t pid) {
  ker_hipri_register_t func = (ker_hipri_register_t)pgm_read_word(0x8c+128+8);
  return func(pid);
}

/**
 * Unregister module to receive message when a HIPRI_INT interrupt is received
 */
static inline int8_t ker_hipri_int_deregister(uint8_t pid) {
  ker_hipri_register_t func = (ker_hipri_register_t)pgm_read_word(0x8c+128+10);
  return func(pid);
}

/**
 * Write a packet on the one-wire bus and no read afterwards
 */
typedef int8_t (*ker_one_wire_write_t)(uint8_t pid, uint8_t* data, uint8_t size);
static inline int8_t ker_one_wire_write(uint8_t pid, uint8_t* data, uint8_t size) {
  ker_one_wire_write_t func = (ker_one_wire_write_t)pgm_read_word(0x8c+128+12);
  return func(pid, data, size);
}

/**
 * Write a packet on the one-wire bus with a read afterwards
 */
typedef int8_t (*ker_one_wire_read_t)(uint8_t pid, uint8_t* write_data, uint8_t write_size, uint8_t read_size);
static inline int8_t ker_one_wire_read(uint8_t pid, uint8_t* write_data, uint8_t write_size, uint8_t read_size) {
  ker_one_wire_read_t func = (ker_one_wire_read_t)pgm_read_word(0x8c+128+14);
  return func(pid, write_data, write_size, read_size);
}

/**
 * Request for distance from IR Ranger
 */
static inline int8_t ker_irranger_trigger(uint8_t pid) {
	ker_hipri_register_t func = (ker_hipri_register_t)pgm_read_word(0x8c+128+16);
	return func(pid);
}

/**
 * Write a packet on the serial ports
 */
typedef int8_t (*ker_serial_write_t)(uint8_t pid, uint8_t port, uint8_t *data, uint8_t len, uint8_t flag);
static inline int8_t ker_serial_write(uint8_t pid, uint8_t port, uint8_t *data, uint8_t len, uint8_t flag) {
  ker_serial_write_t func = (ker_serial_write_t)pgm_read_word(0x8c+128+18);
  return func(pid, port, data, len, flag);
}

/**
 * Read a packet on the serial ports
 */
typedef int8_t (*ker_serial_read_t)(uint8_t pid, uint8_t port, uint8_t len);
static inline int8_t ker_serial_read(uint8_t pid, uint8_t port, uint8_t len) {
  ker_serial_read_t func = (ker_serial_read_t)pgm_read_word(0x8c+128+20);
  return func(pid, port, len);
}
#endif
