nesl/ragobots/robot/sw/code/sos/modules/mc/compass.h

#ifndef COMPASS_H

#define COMPASS_H

#define SOSH_ACTUAL_COMPASS_X_PORT  1
#define SOSH_ACTUAL_COMPASS_Y_PORT  2

#define SOS_ADC_COMPASS_X_PORT 1
#define SOS_ADC_COMPASS_Y_PORT 2

#endif
