nesl/ragobots/robot/sw/code/tinyos/tos/platform/mica2/compass.h

#ifndef COMPASS_H

#define COMPASS_H

#define TOSH_ACTUAL_COMPASS_X_PORT  1
#define TOSH_ACTUAL_COMPASS_Y_PORT  2

#define TOS_ADC_COMPASS_X_PORT 1
#define TOS_ADC_COMPASS_Y_PORT 2

#endif
