nesl/ragobots/(commit log)

2009-01-12 Merged Ragobot hardware and software trees for public release
    [ANT.DSN, ANT.opj, ANT2.DSN, ANT2.opj, Avg_Energy.xls, BOM.RBTNDPA.xls, BOM.xls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]
2009-01-12 Some cleanup to the body hw design files; Added pdf version of body rev. c schematic
    [SpecctraWithinLayout.dsn]
